sergeykhbr/riscv_vhdl/rocket_soc/docs/style/header.tex

% Latex header for doxygen 1.8.10
\documentclass[oneside]{book}

% Packages required by doxygen
\usepackage{fixltx2e}
\usepackage{calc}
\usepackage{doxygen}
\usepackage[export]{adjustbox} % also loads graphicx
\usepackage{graphicx}
\usepackage[utf8]{inputenc}
\usepackage{makeidx}
\usepackage{multicol}
\usepackage{multirow}
\PassOptionsToPackage{warn}{textcomp}
\usepackage{textcomp}
\usepackage[nointegrals]{wasysym}
\usepackage[table]{xcolor}

% Font selection
\usepackage[T1]{fontenc}
\usepackage[scaled=.90]{helvet}
\usepackage{courier}
\usepackage{amssymb}
\usepackage{sectsty}
\renewcommand{\familydefault}{\sfdefault}
\allsectionsfont{%
  \fontseries{bc}\selectfont%
  \color{darkgray}%
}
\renewcommand{\DoxyLabelFont}{%
  \fontseries{bc}\selectfont%
  \color{darkgray}%
}
\newcommand{\+}{\discretionary{\mbox{\scriptsize$\hookleftarrow$}}{}{}}

% Page & text layout
\usepackage{geometry}
\geometry{%
  a4paper,%
  top=2.5cm,%
  bottom=2.5cm,%
  left=2.5cm,%
  right=2.5cm%
}
\tolerance=750
\hfuzz=15pt
\hbadness=750
\setlength{\emergencystretch}{15pt}
\setlength{\parindent}{0cm}
\setlength{\parskip}{0.2cm}
\makeatletter
\renewcommand{\paragraph}{%
  \@startsection{paragraph}{4}{0ex}{-1.0ex}{1.0ex}{%
    \normalfont\normalsize\bfseries\SS@parafont%
  }%
}
\renewcommand{\subparagraph}{%
  \@startsection{subparagraph}{5}{0ex}{-1.0ex}{1.0ex}{%
    \normalfont\normalsize\bfseries\SS@subparafont%
  }%
}
\makeatother

% Headers & footers
\usepackage{fancyhdr}
\pagestyle{fancyplain}
\fancyhead[LE]{\fancyplain{}{\bfseries\thepage}}
\fancyhead[CE]{\fancyplain{}{}}
\fancyhead[RE]{\fancyplain{}{\bfseries\leftmark}}
\fancyhead[LO]{\fancyplain{}{\bfseries\rightmark}}
\fancyhead[CO]{\fancyplain{}{}}
\fancyhead[RO]{\fancyplain{}{\bfseries\thepage}}
\fancyfoot[LE]{\fancyplain{}{}}
\fancyfoot[CE]{\fancyplain{}{}}
\fancyfoot[RE]{\fancyplain{}{\bfseries\scriptsize Generated on Mar 9, 2017 }}
\fancyfoot[LO]{\fancyplain{}{\bfseries\scriptsize Generated on Mar 9, 2017 }}
\fancyfoot[CO]{\fancyplain{}{}}
\fancyfoot[RO]{\fancyplain{}{}}
\renewcommand{\footrulewidth}{0.4pt}
\renewcommand{\chaptermark}[1]{%
  \markboth{#1}{}%
}
\renewcommand{\sectionmark}[1]{%
  \markright{\thesection\ #1}%
}

% Indices & bibliography
\usepackage{natbib}
\usepackage[titles]{tocloft}
\setcounter{tocdepth}{3}
\setcounter{secnumdepth}{5}
\makeindex

% Hyperlinks (required, but should be loaded last)
\usepackage{ifpdf}
\ifpdf
  \usepackage[pdftex,pagebackref=true]{hyperref}
\else
  \usepackage[ps2pdf,pagebackref=true]{hyperref}
\fi
\hypersetup{%
  colorlinks=true,%
  linkcolor=blue,%
  citecolor=blue,%
  unicode%
}

% Custom commands
\newcommand{\clearemptydoublepage}{%
  \newpage{\pagestyle{empty}\cleardoublepage}%
}

%===== C O N T E N T S =====

\begin{document}

% Titlepage & ToC
\hypersetup{pageanchor=false,
             bookmarks=true,
             bookmarksnumbered=true,
             pdfencoding=unicode
            }
\pagenumbering{roman}
\begin{titlepage}
\vspace*{7cm}
\begin{center}%
{\Large RISC-V System-on-Chip description}\\
\vspace*{3cm}
{\large Autor: Khabarov Sergey 5.1.2}\\
\vspace*{0.5cm}
{\large MIPT}\\
\vspace*{0.5cm}
{\small Mar 09, 2017}\\
\end{center}
\end{titlepage}
\clearemptydoublepage
\tableofcontents
\clearemptydoublepage
\pagenumbering{arabic}
\hypersetup{pageanchor=true}

%--- Begin generated contents ---
