sergeykhbr/riscv_vhdl/docs/doxygen/config/style/header.tex

% Latex header for doxygen 1.8.16
\let\mypdfximage\pdfximage\def\pdfximage{\immediate\mypdfximage}\documentclass[oneside]{book}

%% moved from doxygen.sty due to workaround for LaTex 2019 version and unmaintained tabu package
\usepackage{ifthen}
\ifx\requestedLaTeXdate\undefined
\usepackage{array}
\else
\usepackage{array}[=2016-10-06]
\fi
%%
% Packages required by doxygen
\usepackage{fixltx2e}
\usepackage{calc}
\usepackage{doxygen}
\usepackage{graphicx}
\usepackage[utf8]{inputenc}
\usepackage{makeidx}
\usepackage{multicol}
\usepackage{multirow}
\PassOptionsToPackage{warn}{textcomp}
\usepackage{textcomp}
\usepackage[nointegrals]{wasysym}
\usepackage[table]{xcolor}
\usepackage{ifpdf,ifxetex}

% Font selection
\usepackage[T1]{fontenc}
\usepackage[scaled=.90]{helvet}
\usepackage{courier}
\usepackage{amssymb}
\usepackage{sectsty}
\renewcommand{\familydefault}{\sfdefault}
\allsectionsfont{%
  \fontseries{bc}\selectfont%
  \color{darkgray}%
}
\renewcommand{\DoxyLabelFont}{%
  \fontseries{bc}\selectfont%
  \color{darkgray}%
}
\newcommand{\+}{\discretionary{\mbox{\scriptsize$\hookleftarrow$}}{}{}}

% Arguments of doxygenemoji:
% 1) ':<text>:' form of the emoji, already "LaTeX"-escaped
% 2) file with the name of the emoji without the .png extension
% in case image exist use this otherwise use the ':<text>:' form
\newcommand{\doxygenemoji}[2]{%
  \IfFileExists{./#2.png}{\raisebox{-0.1em}{}}{#1}%
}
% Page & text layout
\usepackage{geometry}
\geometry{%
  a4paper,%
  top=2.5cm,%
  bottom=2.5cm,%
  left=2.5cm,%
  right=2.5cm%
}
\tolerance=650
\hfuzz=15pt
\hbadness=650
\textheight=650pt% default 674 see https://www.sharelatex.com/learn/Page_size_and_margins
\setlength{\emergencystretch}{15pt}
\setlength{\parindent}{0cm}
\newcommand{\doxynormalparskip}{\setlength{\parskip}{3ex plus 2ex minus 2ex}}
\newcommand{\doxytocparskip}{\setlength{\parskip}{1ex plus 0ex minus 0ex}}
\doxynormalparskip
\makeatletter
\renewcommand{\paragraph}{%
  \@startsection{paragraph}{4}{0ex}{-1.0ex}{1.0ex}{%
    \normalfont\normalsize\bfseries\SS@parafont%
  }%
}
\renewcommand{\subparagraph}{%
  \@startsection{subparagraph}{5}{0ex}{-1.0ex}{1.0ex}{%
    \normalfont\normalsize\bfseries\SS@subparafont%
  }%
}
\makeatother

% Headers & footers
\usepackage{fancyhdr}
\pagestyle{fancyplain}
% E O = Even Odd pages: L C R = Left, Center, Right page
\setlength\headheight{50pt}% top colontitle height
\fancyhead[RE,RO]{\fancyplain{}{\bfseries\thepage}}
\fancyhead[CE,CO]{\fancyplain{}{\bfseries\rightmark}}
\fancyhead[LE,LO]{}

\fancyfoot[LE,RO]{\fancyplain{}{}}
\fancyfoot[CE,CO]{\fancyplain{}{}}
\fancyfoot[RE,LO]{\fancyplain{}{\bfseries\scriptsize Generated on \\\today }}

\renewcommand{\footrulewidth}{0.4pt}
\renewcommand{\chaptermark}[1]{%
  \markboth{#1}{}%
}
\renewcommand{\sectionmark}[1]{%
  \markright{\thesection\ #1}%
}

% Indices & bibliography
\usepackage{natbib}
\usepackage[titles]{tocloft}
\setcounter{tocdepth}{3}
\setcounter{secnumdepth}{5}
\makeindex

\usepackage{newunicodechar}
  \newunicodechar{⁻}{${}^{-}$}% Superscript minus
  \newunicodechar{²}{${}^{2}$}% Superscript two
  \newunicodechar{³}{${}^{3}$}% Superscript three

% Hyperlinks (required, but should be loaded last)
\ifpdf
  \usepackage[pdftex,pagebackref=true]{hyperref}
\else
  \ifxetex
    \usepackage[pagebackref=true]{hyperref}
  \else
    \usepackage[ps2pdf,pagebackref=true]{hyperref}
  \fi
\fi

\hypersetup{%
  colorlinks=true,%
  linkcolor=blue,%
  citecolor=blue,%
  unicode%
}

% Custom commands
\newcommand{\clearemptydoublepage}{%
  \newpage{\pagestyle{empty}\cleardoublepage}%
}

\usepackage{caption}
\captionsetup{labelsep=space,justification=centering,font={bf},singlelinecheck=off,skip=4pt,position=top}

\usepackage{etoc}
\etocsettocstyle{\doxytocparskip}{\doxynormalparskip}
\renewcommand{\numberline}[1]{#1~}
%===== C O N T E N T S =====

\newcounter{tblid}[chapter]
\newenvironment{tblid}[1][]{\refstepcounter{tblid}\par\medskip
   \textbf{Table~\thechapter#1-\thetblid#1. \medskip}}{\medskip}

\newcounter{figid}[chapter]
\newenvironment{figid}[1][]{\refstepcounter{figid}\par\medskip
   \textbf{Figure~\thechapter#1-\thefigid#1. \medskip}}{\medskip}

\begin{document}

% Titlepage & ToC
\hypersetup{pageanchor=false,
             bookmarksnumbered=true,
             pdfencoding=unicode
            }
\pagenumbering{alph}
\begin{titlepage}
\vspace*{7cm}
\begin{center}%
{\Large Synthesizable System-on-Chip}\\
\vspace*{1\baselineskip}
{\Large with 64-bits RISC-V processor core}\\
\vspace*{2\baselineskip}
{\Large Technical Reference Manual}\\
\end{center}
\begin{flushright}%
\vspace*{3cm}
{\scshape Generated:    \today}\\
{\scshape Author: Sergey Khabarov}
\end{flushright}

\begin{center}%
\vspace*{3cm}
\begin{tabular}{ | m{2cm} | m{3cm} | m{3cm} | m{2cm} | m{2cm} | }
\hline
  & Name & Position & Signature &  Date \\
\hline
Prepared by & Sergey Khabarov & Technical Lead &  & \\
\hline
Reviewed by & Denis Nefedov &  &  & \\
\hline
Approved by &  &  &  & \\
\hline
Approved by &  &  &  & \\
\hline
\end{tabular}
\end{center}
\end{titlepage}
\clearemptydoublepage
\pagenumbering{roman}
\tableofcontents
\clearemptydoublepage
\pagenumbering{arabic}
\hypersetup{pageanchor=true}

%--- Begin generated contents ---
