sergeykhbr/riscv_vhdl/docs/doxygen/pics/dbg_dsu.png

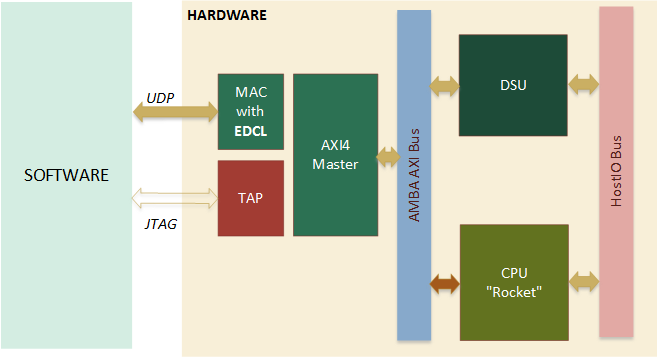
docs/doxygen/pics/dbg_dsu.png
