sergeykhbr/riscv_vhdl/docs/doxygen/pics/dbg_err1.png

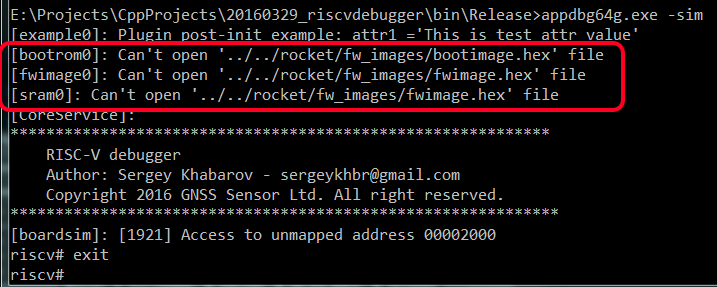
docs/doxygen/pics/dbg_err1.png
