sergeykhbr/riscv_vhdl/docs/doxygen/pics/dbg_fpga_gui1.png

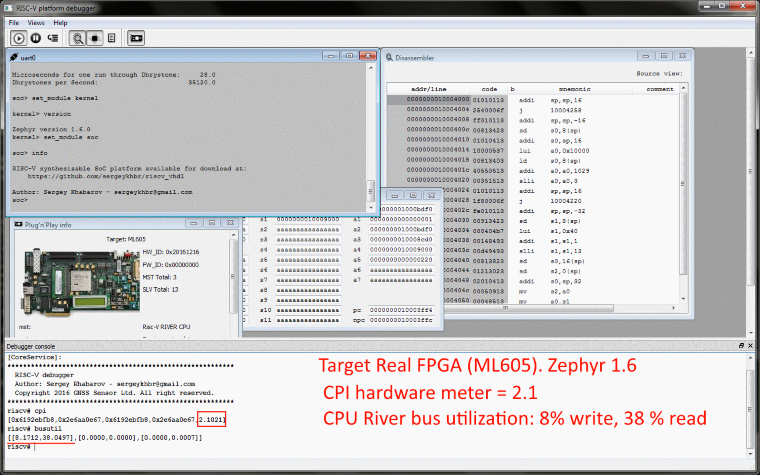
docs/doxygen/pics/dbg_fpga_gui1.png
