sergeykhbr/riscv_vhdl/docs/doxygen/pics/dbg_gnss.png

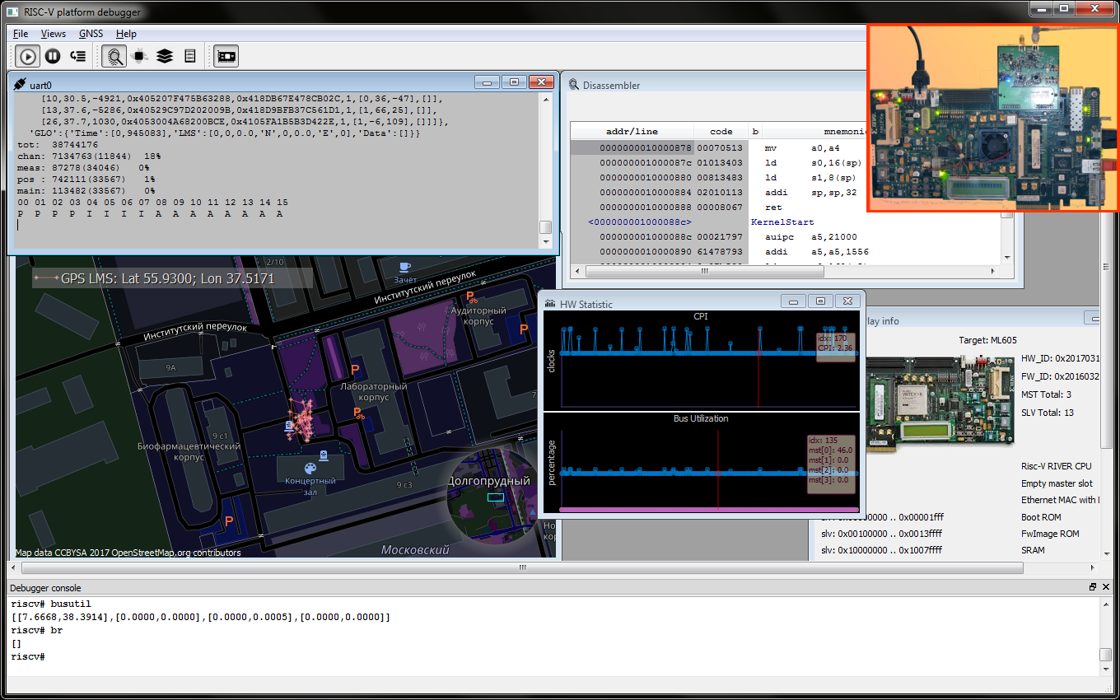
docs/doxygen/pics/dbg_gnss.png
