sergeykhbr/riscv_vhdl/docs/doxygen/pics/dbg_gui_start.png

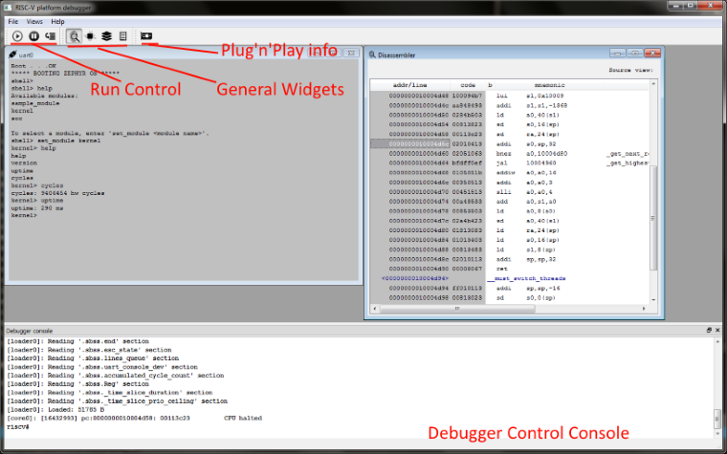
docs/doxygen/pics/dbg_gui_start.png
