sergeykhbr/riscv_vhdl/docs/doxygen/pics/dbg_gui_symb.png

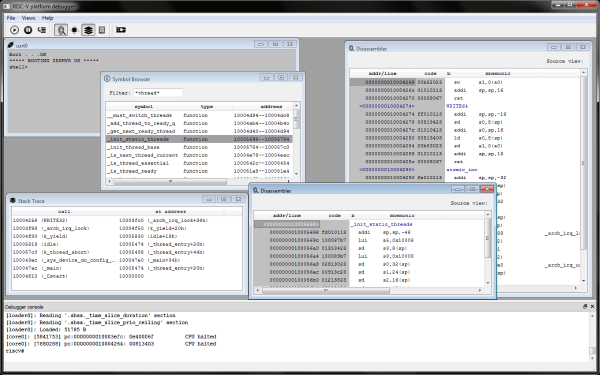
docs/doxygen/pics/dbg_gui_symb.png
