sergeykhbr/riscv_vhdl/docs/doxygen/pics/dbg_sim.png

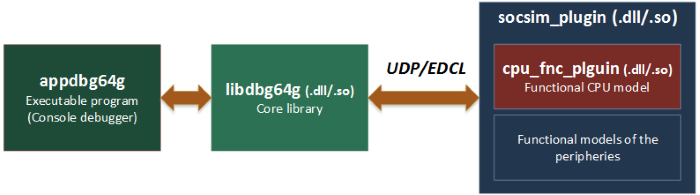
docs/doxygen/pics/dbg_sim.png
