sergeykhbr/riscv_vhdl/docs/doxygen/pics/dbg_simout1.png

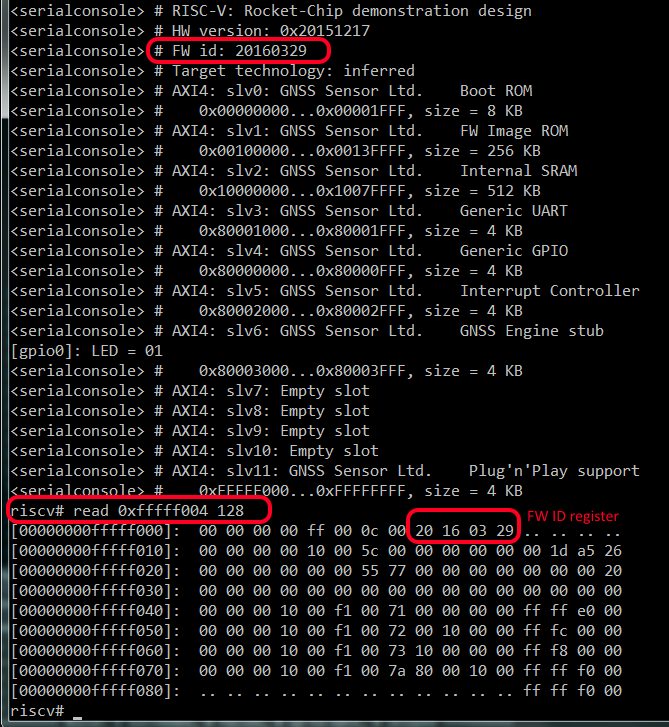
docs/doxygen/pics/dbg_simout1.png
