sergeykhbr/riscv_vhdl/docs/doxygen/pics/eth_check1.png

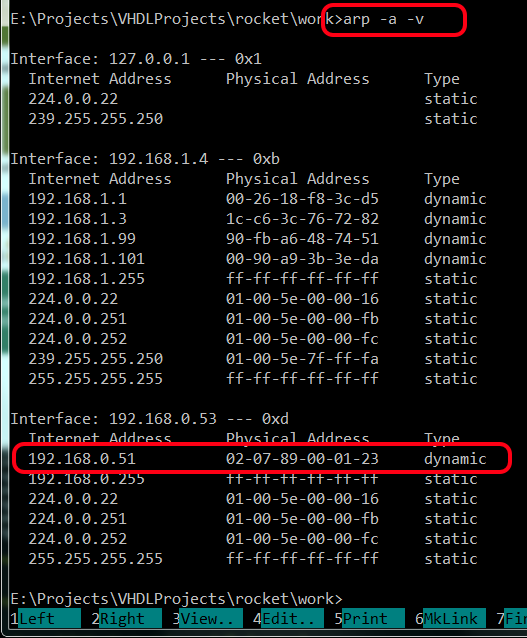
docs/doxygen/pics/eth_check1.png
