sergeykhbr/riscv_vhdl/docs/doxygen/pics/eth_common.png

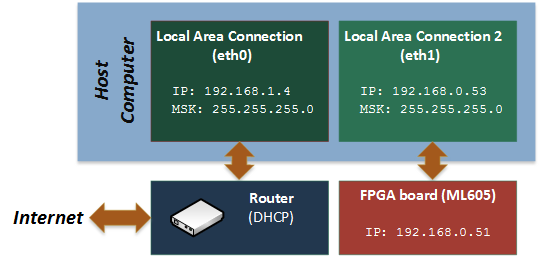
docs/doxygen/pics/eth_common.png
