sergeykhbr/riscv_vhdl/docs/doxygen/pics/eth_win1.png

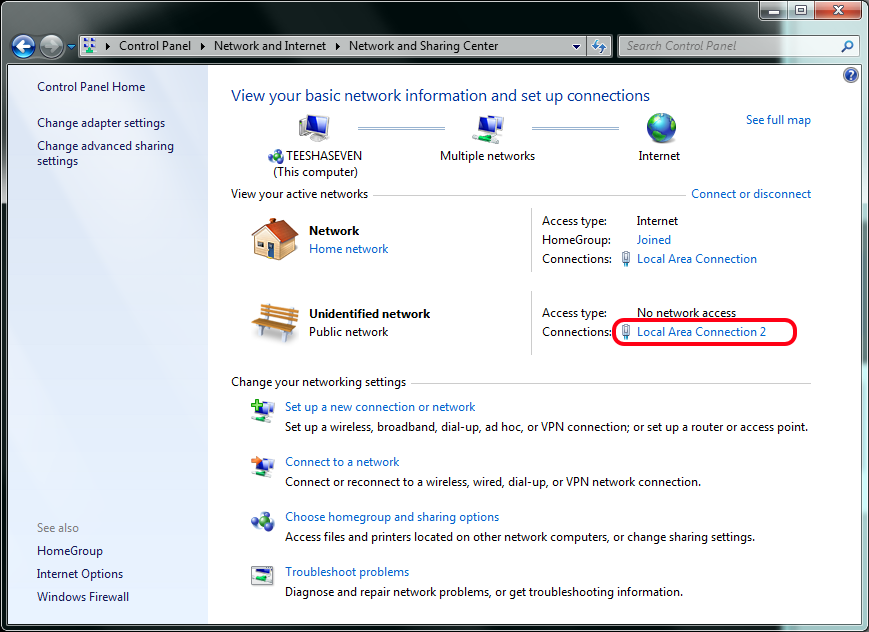
docs/doxygen/pics/eth_win1.png
