sergeykhbr/riscv_vhdl/docs/doxygen/pics/eth_win2.png

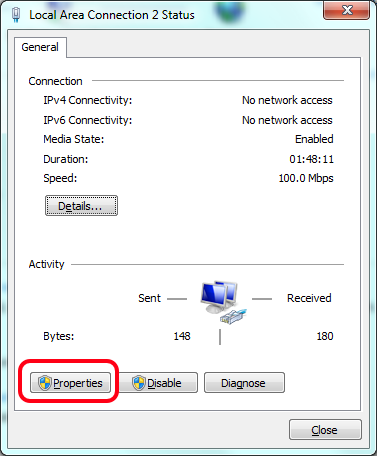
docs/doxygen/pics/eth_win2.png
