sergeykhbr/riscv_vhdl/docs/doxygen/pics/eth_win3.png

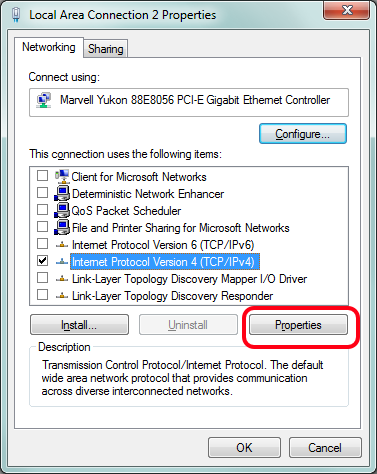
docs/doxygen/pics/eth_win3.png
