sergeykhbr/riscv_vhdl/docs/doxygen/pics/eth_win4.png

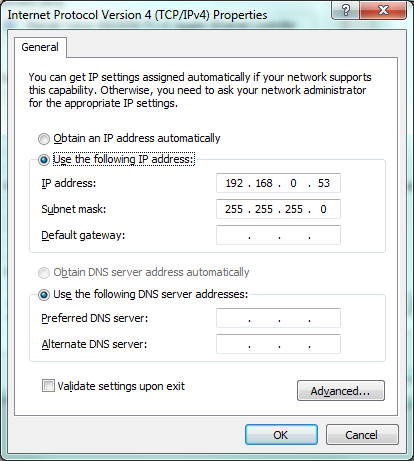
docs/doxygen/pics/eth_win4.png
