sergeykhbr/riscv_vhdl/docs/doxygen/pics/gptimer_pwm.png

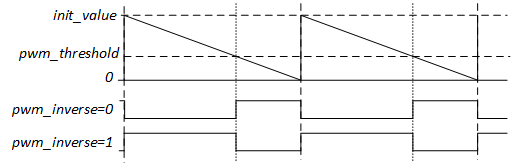
docs/doxygen/pics/gptimer_pwm.png
