sergeykhbr/riscv_vhdl/docs/doxygen/pics/soc_sim.png

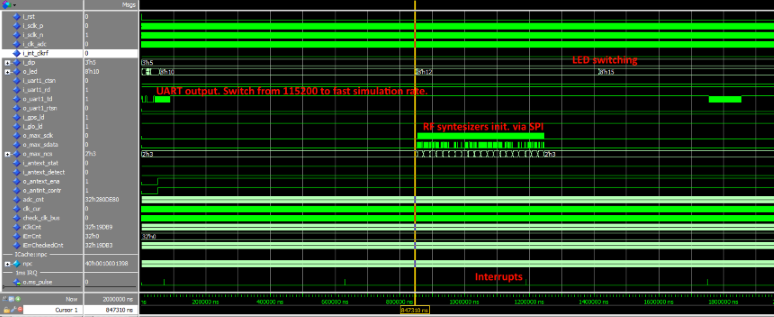
docs/doxygen/pics/soc_sim.png
