sergeykhbr/riscv_vhdl/docs/doxygen/pics/soc_top_v4.png

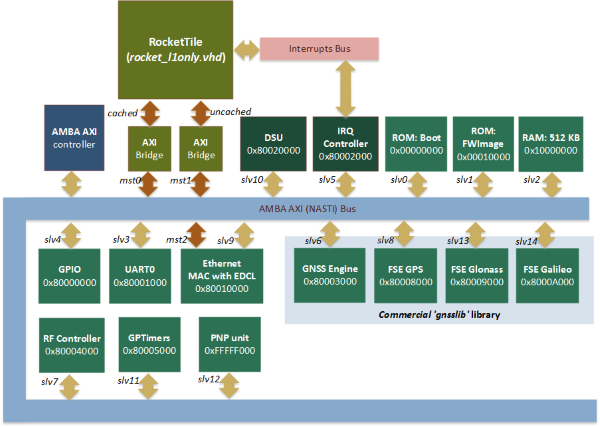
docs/doxygen/pics/soc_top_v4.png
