sergeykhbr/riscv_vhdl/docs/doxygen/pics/spi_rd_data.png

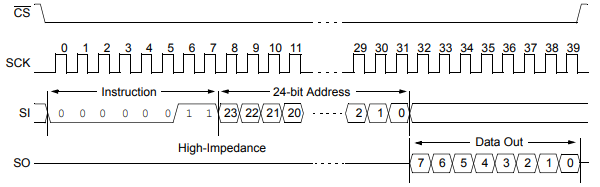
docs/doxygen/pics/spi_rd_data.png
