sergeykhbr/riscv_vhdl/docs/doxygen/pics/spi_rd_status.png

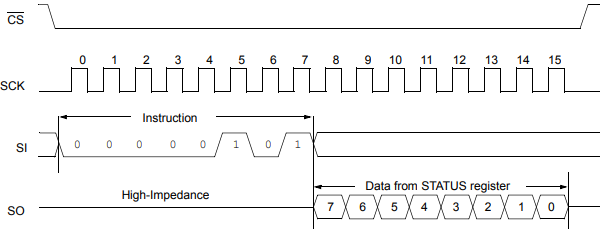
docs/doxygen/pics/spi_rd_status.png
