sergeykhbr/riscv_vhdl/docs/doxygen/pics/spi_wr_enable.png

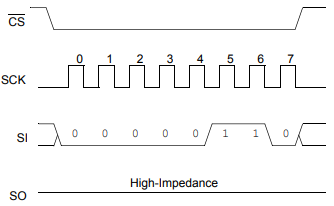
docs/doxygen/pics/spi_wr_enable.png
