sergeykhbr/riscv_vhdl/docs/doxygen/pics/spi_wr_page.png

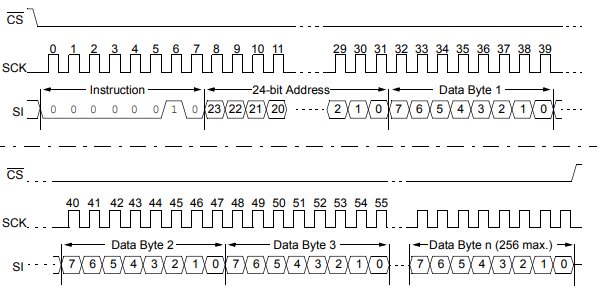
docs/doxygen/pics/spi_wr_page.png
