sergeykhbr/riscv_vhdl/docs/doxygen/pics/spi_wr_status.png

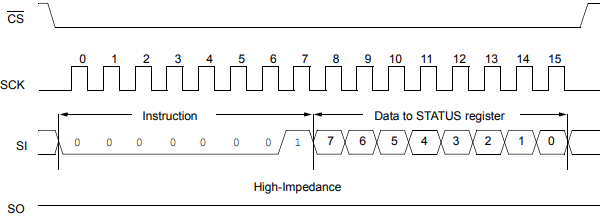
docs/doxygen/pics/spi_wr_status.png
