sergeykhbr/riscv_vhdl/docs/doxygen/pics/uartdbg1.png

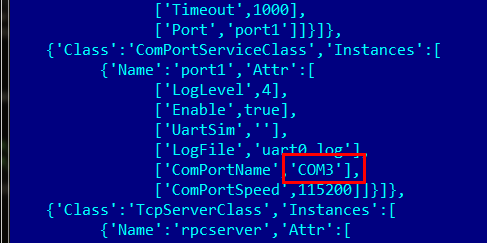
docs/doxygen/pics/uartdbg1.png
