sergeykhbr/riscv_vhdl/docs/doxygen/pics/uartdbg2.png

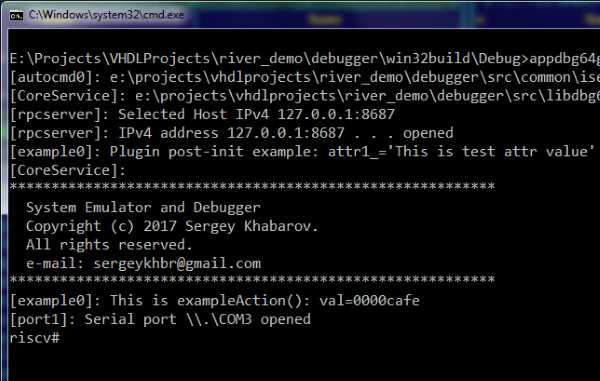
docs/doxygen/pics/uartdbg2.png
