sergeykhbr/riscv_vhdl/docs/doxygen/pics/uartdbg3.png

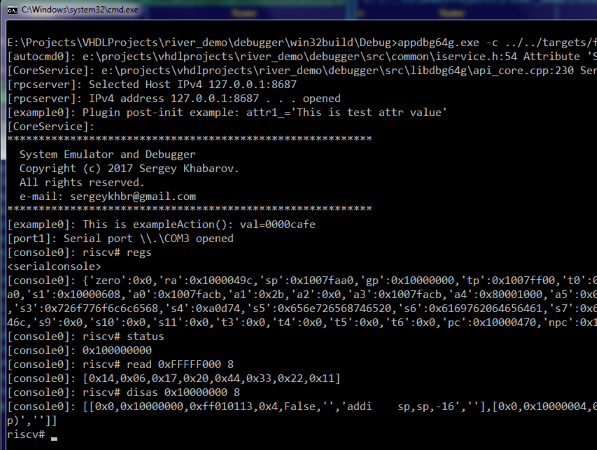
docs/doxygen/pics/uartdbg3.png
