sergeykhbr/riscv_vhdl/docs/doxygen/pics/uartdbg4.png

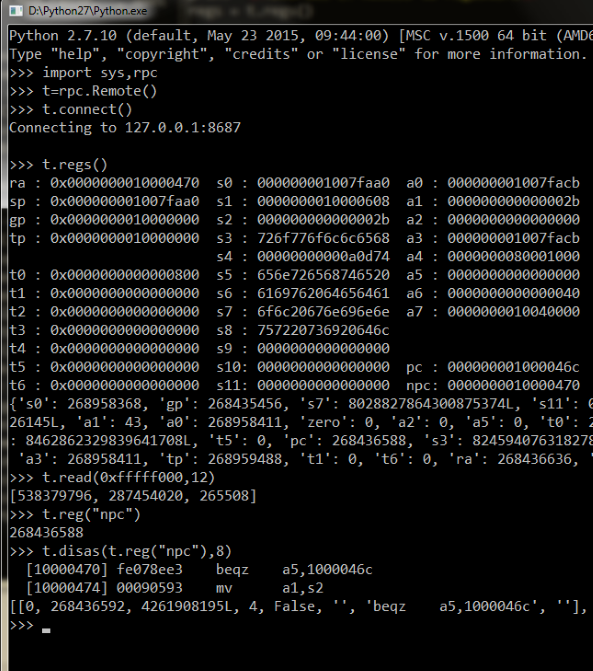
docs/doxygen/pics/uartdbg4.png
