sergeykhbr/riscv_vhdl/docs/doxygen/pics/mem_byte_order.png

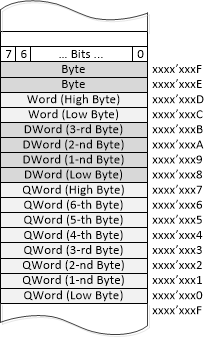
docs/doxygen/pics/mem_byte_order.png
