sergeykhbr/riscv_vhdl/docs/doxygen/pics/dbg_testhw.png

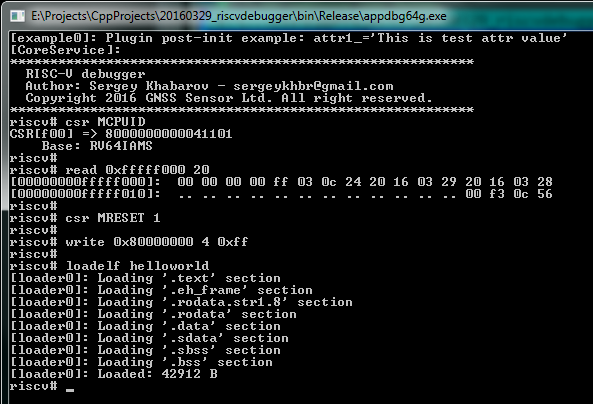
docs/doxygen/pics/dbg_testhw.png
