sergeykhbr/riscv_vhdl/debugger/scripts/demo/footer.tex

% Latex footer for doxygen 1.8.10
%--- End generated contents ---

% Index
\backmatter
\newpage
\phantomsection
\clearemptydoublepage
\addcontentsline{toc}{chapter}{Index}
\printindex

\end{document}
