sergeykhbr/riscv_vhdl/debugger/src/gui_plugin/resources/images/kc705_top.png

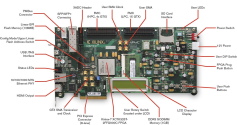
debugger/src/gui_plugin/resources/images/kc705_top.png
