sergeykhbr/riscv_vhdl/debugger/src/gui_plugin/resources/images/ml605_top.png

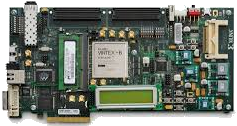
debugger/src/gui_plugin/resources/images/ml605_top.png
