sergeykhbr/riscv_vhdl/(threads)

Thread 1 (2016-02-23):

Bare-metal Rocket Chip

pbn4, 2016-02-23:
Hello,

I was wondering if it is possible to run bare-metal applications with rocketchip? I wanted to simply flash a program written in C without using bootloader and flashing linux image to ROM.  If it is not possible please point me to some details (docs, readings etc.) about it.

sergeykhbr, 2016-02-23:
Hi,
It is possible and that's we're doing with our firmware for Satellite Navigation receiver.

In our case it is a bit simpler to support hardware features because we're writing our FW from the scratch. In a case of linux there're some modifications in kernel will require to support internal timers and interrupts and most probably modes of processors (up to 4 privilege levels: machine ->..-> user). Linux port from the original riscv.org site should simplify this work, I think.
The second problem - available memory size to run linux. It can be easily solved on fpga platforms using appropriate ddr phy with AMBA axi controller but it out of my project for now (maybe later).

You need some initial bootup code in any case to reset registers, invalidate caches and initialize stack pointer. After that you can copy your linux image into SRAM or jump to some entry point at once. That's we are actually doing with our firmware before we call main() function placed exactly at 0x10000000 address. See example of our our boot loader in 'fw' folder.

Closed 2016-02-23.

Thread 4 (2017-02-07):

The software models with GUI closes automatically

satya123bora, 2017-02-07:
If I run ./_run_functional_sim.sh or ./_run_systemc_sim.sh, it works fine for 2-3 mins. But, after 2-3 mins, the window closes automatically. The terminal messages are:

[example0]: Plugin post-init example: attr1_='This is test attr value'
[CoreService]:                                                
**********************************************************
  RISC-V debugger
  Author: Sergey Khabarov - sergeykhbr@gmail.com
  Copyright 2016 GNSS Sensor Ltd. All right reserved.
**********************************************************
[example0]: This is exampleAction(): val=0000cafe             
<led[7:0]> 01h                                                
<led[7:0]> 02h                                                
<led[7:0]> 03h                                                
<led[7:0]> 04h                                                
<serialconsole> Boot . . .OK                                  
<serialconsole> ***** BOOTING ZEPHYR OS *****                 
riscv# *** Error in `./appdbg64g.exe': double free or corruption (out): 0x00007f4d8805f1d0 ***
./_run_functional_sim.sh: line 3:  7880 Aborted                 (core dumped) ./appdbg64g.exe -c ../../targets/functional_sim_gui.json "$@"

when the window closes, the terminal also stops working. If I try to run it from a different terminal, it appears for 3-4 secs and then closes. But, If I wait for 15-20 mins and then run it, it again works for 2-3 mins. Why is this happening? I am working on ubuntu 14.04.

sergeykhbr, 2017-02-07:
Thank you for this issue report. I can reproduce it and will try to fix as fast as possible.

sergeykhbr, 2017-02-07:
Bug was fixed. see attribute.cpp, line 216. Allocated memory wasn't initialized (Linux problem only).

Closed 2017-02-08.

Thread 5 (2017-06-22):

Rtos port on RISC-V

ninode, 2017-06-22:
Hello,

I'm doing an rtos port on RISC-V and currently working on the fpga-zynq/rocket-chip directory of Berkeley's.

Could you please provide instruction to how you used Vivado tools to generate another boot.bin which contains another os than linux with the rocket chip ? Did you use [this directory ](https://github.com/ucb-bar/fpga-zynq) at all ?
What kind of files are necessary to have both the rocket cores and another os into the same boot.bin ?

Thank you very much

Regards

sergeykhbr, 2017-06-23:
Hi,

I think you've a bit misunderstood the difference of projects for ZYNQ (ARM+FPGA) and pure FPGA projects. I do not use ZYNQ in my project and I do not use directory you've pointed to. So, I cannot help you to generate boot.bin file because I don't need to generate image for ARM at all.

Regards,
Sergey

ninode, 2017-07-03:
Hello,

Actually, is it possible to use your SoC FPGA Rocket sources and push them to a Zedboard to have Rocket cores on the FPGA fabric and not touch the ARM ?

Also, instead of Zephyr, is it possible to use my own sources for a ported RTOS in order to have: RTOS on ARM cores and Rocket cores on FPGA, without the boot.bin, but following your steps ?

Thank you

sergeykhbr, 2017-07-03:
I am not experienced with ZYNQ but I see one common difference in FPGA startup process:

- In a case of pure FPGA project (not ZYNQ), FPGA has access to all HW interfaces and IOs including flash ROM. Software (ISE or Vivado) can directly load bit-image into fpga via JTAG interface either.

- In a case of ZYNQ almost all FPGA's IOs connected to MIO interface between ARM and FPGA. And accordingly with this thread
https://forums.xilinx.com/t5/Zynq-All-Programmable-SoC/Zynq-newbee-questions-Configure-FPGA-fabric-without-hard-ARM/td-p/568025
"**_The Zynq PL cannot be configured independent of the PS; the PL can't power on and read a configuration bitstream from a memory chip. The PS must run and program the fabric through a configuration access port...._**"
In my opinion, it means that you has to build and run at least BootLoader on ARM to properly configure MIO interface and load FPGA image into FPGA.

So, I suppose the answers on questions will be (my opinion only):
1. It is possible to use Rocket sources on FPGA but ARM is always touched.
2. You cannot load FPGA without boot.bin

Closed 2017-06-23.

Thread 6 (2017-08-17):

compiling errors

Pengnian, 2017-08-17:
Hi ,all

I want to compiling boot (riscv_vhdl\rocket_soc\fw\boot),but find some errors maybe causing  gun-toolchain version , please experts  explanation ! Thanks~

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

sergeykhbr, 2017-08-17:
Hi,
You're building _bootimg_ with the flag **-march=rv64ima**, but gcc toolchain was built with the hardware FPU (default configuration).

I suggest to rebuild gcc with _**--disable-float**_ key or build _bootimg_ with the _-march=rv64imafd_.

Pengnian, 2017-08-17:
Okay. Thanks very much，I will  try again！☺️ You explanation  very useful for  me！

Sent from Mail Master
On 08/17/2017 17:57, Sergey wrote:

Hi,
You're building bootimg with the flag -march=rv64ima, but gcc toolchain was built with the hardware FPU (default configuration).

I suggest to rebuild gcc with --disable-float key or build bootimg with the -march=rv64imafd.

—
You are receiving this because you authored the thread.
Reply to this email directly, view it on GitHub, or mute the thread.

Closed 2017-08-17.

Thread 9 (2017-10-11):

how  to generate bitstream file  by myself ?

Pengnian, 2017-10-11:
Hi Sergey,

At first，thanks for your source code about risc-v cores.

I know I can directly use your  project at ISE or Vivado(riscv_vhdl/rocket_soc/prj/) but I want to synthesis in vivado by myself at xilinx  VCU118 Board. Can  you  tell me which vhdl files  need to add my project and other attention items?

Thanks you very much !

sergeykhbr, 2017-10-11:
Hi,
I'm doing the following steps to add new fpga/asic target:

1. Create new target ID in the file _techmap/gencomp/gecomp.vhd_ (or reuse '_virtex7_' for your purpose).
2. Generate new PLL module for your target and add it to the file _techmap/pll/SysPLL_tech.vhd_ under your generic parameter. Don't forget to include your pll module into '_techmap_' library (default is '_work_').
3. Do the same step for others '_*_tech.vhd_' files (if needed), like _techmap/mem/bootrom_tech.vhd_ or check that function __is_fpga__('virtex7') returns 1.
4. Create the constrains file for your fpga
5. Create the target config file (analog is _prj/ml605/config_v6.vhd_) and include it into the project instead of other config target. It should define parameters:
           CFG_FABTECH = virtex7
           CFG_MEMTECH = virtex7
           ..
6. Build project and try to find the words '_blackbox_' or '_black_' in your synthesis output. If not found then OK and everything should be built successfully, otherwise check that you properly included target dependable modules.

Pengnian, 2017-10-12:
@sergeykhbr Hi sergey，
Thanks  for your reply ,I want to ask one question that adding helloworld  hex file to vhdl file synthesis together which attention items we need focus on and why print "hello world !" message  by uart port is messy code.

please give me  some hint,thanks again!

sergeykhbr, 2017-10-12:
There're used two images:

1. bootimage.hex. This file is generated by fw/boot code. It is valid for ASIC, FPGA and RTL simulation. But there's implemented a special trick (reading 'tech' register from pnp module) for the RTL simulation that allows to skip stage of copying fwimage data from ROM to RAM before executing it.

2. fwimage.hex. It's the image with the firmware (HelloWorld or whatever). In normal mode it should be stored only as a ROM module but to speed simulation SRAM module also is using it for the initialization. This approach normally works on simulation and even for FPGA but invalid for ASIC because SRAM cannot be initialized.

If you have some messy UART output most probably you wrongly setup UART Baud rate. Baud Rate directly depends of Bus clock frequency and UART scaler register must be computed as:

        uart->scaler = Fbus / 115200 / 2
        where Fbus = 40 000 000 Hz
Probably you are using another Bus Frequency.

Pengnian, 2017-10-13:
@sergeykhbr Thanks very much,
It is very important for us !

Pengnian, 2017-10-13:
@sergeykhbr Hi sergey,
Thanks for you patient, I'm very appreciate it !

Pengnian, 2017-10-21:
@sergeykhbr Hi sergey，
 I'm sorry , I can't generate bitstream file for my target board (Virtex UltraScala+ VCU118) following your hints. Can you tell me every steps transplant RISC-V core to my board or create new project in vivado(or ISE)  for my board. My board XDC file   following:

`
##############################################################################
 Generated by PlanAhead 14.7 built on 'Fri Sep 27 19:29:51 MDT 2013' by 'xbuild'
##############################################################################

create_clock -period 5.000 -name i_sclk_p [get_ports i_sclk_p]
set_property IOSTANDARD LVDS [get_ports i_sclk_p]
set_property PACKAGE_PIN G31 [get_ports i_sclk_p]
set_property PACKAGE_PIN F31 [get_ports i_sclk_n]
set_property IOSTANDARD LVDS [get_ports i_sclk_n]

# button "Center"
set_property PACKAGE_PIN L19 [get_ports i_rst]
set_property CLOCK_DEDICATED_ROUTE FALSE [get_nets i_rst]
set_property IOSTANDARD LVCMOS12 [get_ports i_rst]

# DIP switch: SW1.1
set_property PACKAGE_PIN B17 [get_ports {i_dip[0]}]
set_property IOSTANDARD LVCMOS12 [get_ports {i_dip[0]}]
set_property PACKAGE_PIN G16 [get_ports {i_dip[1]}]
set_property IOSTANDARD LVCMOS12 [get_ports {i_dip[1]}]
set_property PACKAGE_PIN J16 [get_ports {i_dip[2]}]
set_property IOSTANDARD LVCMOS12 [get_ports {i_dip[2]}]
set_property PACKAGE_PIN D21 [get_ports {i_dip[3]}]
set_property IOSTANDARD LVCMOS12 [get_ports {i_dip[3]}]

#UART interface
set_property PACKAGE_PIN AY25 [get_ports i_uart1_ctsn]
set_property IOSTANDARD LVCMOS18 [get_ports i_uart1_ctsn]
set_property PACKAGE_PIN AW25 [get_ports i_uart1_rd]
set_property IOSTANDARD LVCMOS18 [get_ports i_uart1_rd]
set_property PACKAGE_PIN BB22 [get_ports o_uart1_rtsn]
set_property IOSTANDARD LVCMOS18 [get_ports o_uart1_rtsn]
set_property PACKAGE_PIN BB21 [get_ports o_uart1_td]
set_property IOSTANDARD LVCMOS18 [get_ports o_uart1_td]

#/ User's LEDs:
set_property PACKAGE_PIN AT32 [get_ports {o_led[0]}]
set_property IOSTANDARD LVCMOS12 [get_ports {o_led[0]}]
set_property PACKAGE_PIN AV34 [get_ports {o_led[1]}]
set_property IOSTANDARD LVCMOS12 [get_ports {o_led[1]}]
set_property PACKAGE_PIN AY30 [get_ports {o_led[2]}]
set_property IOSTANDARD LVCMOS12 [get_ports {o_led[2]}]
set_property PACKAGE_PIN BB32 [get_ports {o_led[3]}]
set_property IOSTANDARD LVCMOS12 [get_ports {o_led[3]}]
set_property PACKAGE_PIN BF32 [get_ports {o_led[4]}]
set_property IOSTANDARD LVCMOS12 [get_ports {o_led[4]}]
set_property PACKAGE_PIN AU37 [get_ports {o_led[5]}]
set_property IOSTANDARD LVCMOS12 [get_ports {o_led[5]}]
set_property PACKAGE_PIN AV36 [get_ports {o_led[6]}]
set_property IOSTANDARD LVCMOS12 [get_ports {o_led[6]}]
set_property PACKAGE_PIN BA37 [get_ports {o_led[7]}]
set_property IOSTANDARD LVCMOS12 [get_ports {o_led[7]}]

# Ethernet signals
set_property PACKAGE_PIN AT22 [get_ports i_gmiiclk_p]
set_property IOSTANDARD LVCMOS18 [get_ports i_gmiiclk_p]
set_property PACKAGE_PIN AU22 [get_ports i_gmiiclk_n]
set_property IOSTANDARD LVCMOS18 [get_ports i_gmiiclk_n]

set_property CLOCK_DEDICATED_ROUTE FALSE [get_nets -of [get_pins igbebuf0/xk7.x1/x1/O]]

set_property PACKAGE_PIN AH30 [get_ports io_emdio]
set_property IOSTANDARD LVCMOS18 [get_ports io_emdio]
set_property PACKAGE_PIN AM31 [get_ports o_emdc]
set_property IOSTANDARD LVCMOS18 [get_ports o_emdc]
set_property PACKAGE_PIN K36 [get_ports i_emdint]
set_property IOSTANDARD LVCMOS18 [get_ports i_emdint]
set_property PACKAGE_PIN R36 [get_ports o_erstn]
set_property IOSTANDARD LVCMOS18 [get_ports o_erstn]
set_property PACKAGE_PIN L38 [get_ports i_erx_crs]
set_property IOSTANDARD LVCMOS18 [get_ports i_erx_crs]
set_property PACKAGE_PIN M37 [get_ports i_erx_col]
set_property IOSTANDARD LVCMOS18 [get_ports i_erx_col]
set_property PACKAGE_PIN BC10 [get_ports i_erx_clk]
set_property IOSTANDARD LVCMOS18 [get_ports i_erx_clk]
set_property PACKAGE_PIN R33 [get_ports i_erx_er]
set_property IOSTANDARD LVCMOS18 [get_ports i_erx_er]
set_property PACKAGE_PIN T33 [get_ports i_erx_dv]
set_property IOSTANDARD LVCMOS18 [get_ports i_erx_dv]
set_property PACKAGE_PIN W31 [get_ports {i_erxd[0]}]
set_property IOSTANDARD LVCMOS18 [get_ports {i_erxd[0]}]
set_property PACKAGE_PIN Y31 [get_ports {i_erxd[1]}]
set_property IOSTANDARD LVCMOS18 [get_ports {i_erxd[1]}]
set_property PACKAGE_PIN U32 [get_ports {i_erxd[2]}]
set_property IOSTANDARD LVCMOS18 [get_ports {i_erxd[2]}]
set_property PACKAGE_PIN U31 [get_ports {i_erxd[3]}]
set_property IOSTANDARD LVCMOS18 [get_ports {i_erxd[3]}]
set_property PACKAGE_PIN T31 [get_ports o_egtx_clk]
set_property IOSTANDARD LVCMOS18 [get_ports o_egtx_clk]
set_property PACKAGE_PIN BE10 [get_ports i_etx_clk]
set_property IOSTANDARD LVCMOS18 [get_ports i_etx_clk]
set_property CLOCK_DEDICATED_ROUTE FALSE [get_nets i_etx_clk_IBUF_inst/O]

set_property PACKAGE_PIN BB8 [get_ports o_etx_er]
set_property IOSTANDARD LVCMOS18 [get_ports o_etx_er]
set_property PACKAGE_PIN J14 [get_ports o_etx_en]
set_property IOSTANDARD LVCMOS18 [get_ports o_etx_en]
set_property PACKAGE_PIN N12 [get_ports {o_etxd[0]}]
set_property IOSTANDARD LVCMOS18 [get_ports {o_etxd[0]}]
set_property PACKAGE_PIN R16 [get_ports {o_etxd[1]}]
set_property IOSTANDARD LVCMOS18 [get_ports {o_etxd[1]}]
set_property PACKAGE_PIN BB11 [get_ports {o_etxd[2]}]
set_property IOSTANDARD LVCMOS18 [get_ports {o_etxd[2]}]
set_property PACKAGE_PIN BA10 [get_ports {o_etxd[3]}]
set_property IOSTANDARD LVCMOS18 [get_ports {o_etxd[3]}]

set_property MARK_DEBUG true [get_nets o_uart1_td_OBUF]
set_property MARK_DEBUG true [get_nets i_uart1_rd_IBUF]
set_property MARK_DEBUG true [get_nets i_uart1_ctsn_IBUF]

set_property MARK_DEBUG false [get_nets {uart1/data1[2]}]
set_property MARK_DEBUG false [get_nets {uart1/data1[29]}]
set_property MARK_DEBUG false [get_nets {uart1/data1[26]}]
set_property MARK_DEBUG false [get_nets {uart1/data1[23]}]
set_property MARK_DEBUG false [get_nets {uart1/data1[20]}]
set_property MARK_DEBUG false [get_nets {uart1/data1[17]}]
set_property MARK_DEBUG false [get_nets {uart1/data1[14]}]
set_property MARK_DEBUG false [get_nets {uart1/data1[11]}]
set_property MARK_DEBUG false [get_nets {uart1/data1[10]}]
set_property MARK_DEBUG false [get_nets {uart1/data1[5]}]
set_property MARK_DEBUG false [get_nets {uart1/data1[27]}]
set_property MARK_DEBUG false [get_nets {uart1/data1[24]}]
set_property MARK_DEBUG false [get_nets {uart1/data1[21]}]
set_property MARK_DEBUG false [get_nets {uart1/data1[18]}]
set_property MARK_DEBUG false [get_nets {uart1/data1[15]}]
set_property MARK_DEBUG false [get_nets {uart1/data1[12]}]
set_property MARK_DEBUG false [get_nets {uart1/data1[8]}]
set_property MARK_DEBUG false [get_nets {uart1/data1[6]}]
set_property MARK_DEBUG false [get_nets {uart1/data1[3]}]
set_property MARK_DEBUG false [get_nets {uart1/data1[30]}]
set_property MARK_DEBUG false [get_nets {uart1/data1[7]}]
set_property MARK_DEBUG false [get_nets {uart1/data1[1]}]
set_property MARK_DEBUG false [get_nets {uart1/data1[16]}]
set_property MARK_DEBUG false [get_nets {uart1/data1[4]}]
set_property MARK_DEBUG false [get_nets {uart1/data1[31]}]
set_property MARK_DEBUG false [get_nets {uart1/data1[28]}]
set_property MARK_DEBUG false [get_nets {uart1/data1[22]}]
set_property MARK_DEBUG false [get_nets {uart1/data1[25]}]
set_property MARK_DEBUG false [get_nets {uart1/data1[19]}]
set_property MARK_DEBUG false [get_nets {uart1/data1[9]}]
set_property MARK_DEBUG false [get_nets {uart1/data1[13]}]

set_property MARK_DEBUG true [get_nets {rst0/AR[0]}]
create_debug_core u_ila_0 ila
set_property ALL_PROBE_SAME_MU true [get_debug_cores u_ila_0]
set_property ALL_PROBE_SAME_MU_CNT 1 [get_debug_cores u_ila_0]
set_property C_ADV_TRIGGER false [get_debug_cores u_ila_0]
set_property C_DATA_DEPTH 65536 [get_debug_cores u_ila_0]
set_property C_EN_STRG_QUAL false [get_debug_cores u_ila_0]
set_property C_INPUT_PIPE_STAGES 0 [get_debug_cores u_ila_0]
set_property C_TRIGIN_EN false [get_debug_cores u_ila_0]
set_property C_TRIGOUT_EN false [get_debug_cores u_ila_0]
set_property port_width 1 [get_debug_ports u_ila_0/clk]
connect_debug_port u_ila_0/clk [get_nets [list pll0/xv7.pll0/w_clk_bus]]
set_property PROBE_TYPE DATA_AND_TRIGGER [get_debug_ports u_ila_0/probe0]
set_property port_width 1 [get_debug_ports u_ila_0/probe0]
connect_debug_port u_ila_0/probe0 [get_nets [list i_uart1_ctsn_IBUF]]
create_debug_port u_ila_0 probe
set_property PROBE_TYPE DATA_AND_TRIGGER [get_debug_ports u_ila_0/probe1]
set_property port_width 1 [get_debug_ports u_ila_0/probe1]
connect_debug_port u_ila_0/probe1 [get_nets [list i_uart1_rd_IBUF]]
create_debug_port u_ila_0 probe
set_property PROBE_TYPE DATA_AND_TRIGGER [get_debug_ports u_ila_0/probe2]
set_property port_width 2 [get_debug_ports u_ila_0/probe2]
connect_debug_port u_ila_0/probe2 [get_nets [list o_uart1_td_OBUF {rst0/AR[0]}]]
set_property C_CLK_INPUT_FREQ_HZ 300000000 [get_debug_cores dbg_hub]
set_property C_ENABLE_CLK_DIVIDER false [get_debug_cores dbg_hub]
set_property C_USER_SCAN_CHAIN 1 [get_debug_cores dbg_hub]
connect_debug_port dbg_hub/clk [get_nets u_ila_1_clkfbout_buf]
`

Pengnian, 2017-10-21:
@sergeykhbr Hi sergey，
I'm sorry , I can't generate bitstream file for my target board (Virtex UltraScala+ VCU118) following your hints. Can you tell me every steps transplant RISC-V core to my board or create new project in vivado(or ISE) for my board. My board XDC file following:
[riscv_soc_vcu118.txt](https://github.com/sergeykhbr/riscv_vhdl/files/1404056/riscv_soc_vcu118.txt)

sergeykhbr, 2017-11-03:
Sorry, I was on vacation.
Where did you stuck? Could you please send synthesis console logs. Because I don't have such board and can't check your constraints file.

Pengnian, 2017-11-06:
@sergeykhbr  Thank you very much,
 "ERROR: [Chipscope 16-213] The debug port 'u_ila_0/clk' has 1 unconnected channels (bits). This will cause errors during implementation."

my synthesis log as follow:

[synthesis_log.txt](https://github.com/sergeykhbr/riscv_vhdl/files/1446705/synthesis_log.txt)

my implementation log  as follow:
[implementation_log.txt](https://github.com/sergeykhbr/riscv_vhdl/files/1446708/implementation_log.txt)

Pengnian, 2017-11-07:
@sergeykhbr  Hi,sergeykhbr

Thank you for your patient!

Vivado synthesis has passed, but implementation report errors , the error is follow:

`[DRC 23-20] Rule violation (INBB-3) Black Box Instances - Cell 'boot0/tech0/genrom1.x0' of type 'boot0/tech0/genrom1.x0/BootRom_vcu118' has undefined contents and is considered a black box.  The contents of this cell must be defined for opt_design to complete successfully.
`
my vivado synthesis log:
[vivado_synthesis_log.txt](https://github.com/sergeykhbr/riscv_vhdl/files/1448573/vivado_synthesis_log.txt)

my vivado implementation log:
[vivado_implementation_log.txt](https://github.com/sergeykhbr/riscv_vhdl/files/1448574/vivado_implementation_log.txt)

Pengnian, 2017-11-07:
@sergeykhbr Thank you for your patient!

Vivado synthesis has passed, but implementation report errors , the error is follow:

`[DRC 23-20] Rule violation (INBB-3) Black Box Instances - Cell 'boot0/tech0/genrom1.x0' of type 'boot0/tech0/genrom1.x0/BootRom_vcu118' has undefined contents and is considered a black box. The contents of this cell must be defined for opt_design to complete successfully.`

my vivado synthesis log:
[vivado_synthesis_log.txt](https://github.com/sergeykhbr/riscv_vhdl/files/1448577/vivado_synthesis_log.txt)

my vivado implementation log:
[vivado_implementation_log.txt](https://github.com/sergeykhbr/riscv_vhdl/files/1448578/vivado_implementation_log.txt)

sergeykhbr, 2017-11-07:
I see at least 2 wrongly synthesized component (see synt. log-file):
```
Report BlackBoxes:
     +------+----------------+----------+
     |      |BlackBox name   |Instances |
     +------+----------------+----------+
     |1     |BootRom_vcu118  |         1|
     |2     |RomImage_vcu118 |         1|
     +------+----------------+----------+
```
So you need to properly instantiate these modules in a similar way as in *techmap\mem\bootrom_tech.vhd*
1. Check *is_fpga(memtech)* returns true
2. Check that your files included into *techmap* library
3. There's a bit another names than in my project so I can't provide more details.

Pengnian, 2017-11-08:
@sergeykhbr
Thank for your patient,

My modification steps as follow:

 1. create BootRom_vcu118.vhd for  my target.
 2.instantiation the modules in `techmap\mem\bootrom.vhd`
  ( `RomImage_vcu118.vhd` also like above )

So,besides I don't know which file  need to modification .Can you tell  all of `*.vhd` file need to modification  about `BootRom` and `RomImage`.

Pengnian, 2017-11-08:
Thanks for your patient, My modification steps as follow:

   1.create BootRom_vcu118.vhd for my target.
   2.instantiation the modules in techmap\mem\bootrom.vhd
      ( RomImage_vcu118.vhd also like above )
So,besides I don't know which file need to modification .Can you tell all of *.vhd file need to modification about BootRom and RomImage.

sergeykhbr, 2017-11-08:
If you create new ROM-module file then you need to add it into Vivado project and afterward you need to include it into 'techmap' library (default is 'work').

Now it looks like you didn't add your files into the project or didn't include them into proper library by this reason Vivado insert black-boxes.

Pengnian, 2017-11-11:
Okay,Thanks  you very much!!!

Closed 2017-11-24.

Thread 11 (2018-03-29):

elf2raw64 и .shstrab

kraziant, 2018-03-29:
Сергей, здравствуйте! Собрали elf2raw64 из исходников. При конвертации выдается ошибка:
 err: undifined .shstrab section.

Возможно мы не правильно elf собираем?
В качестве тулчейна используем SciFive пресобранный со студией.

Хотим запустить helloworld.

sergeykhbr, 2018-03-29:
Hi. Could you please attach your elf-file?

Notice: there's bug with some compressed instruction in simulator from the main trunk of the repository that I didn't solve yet.

kraziant, 2018-03-31:
Here they are:

[helloworld.hex.txt](https://github.com/sergeykhbr/riscv_vhdl/files/1865273/helloworld.hex.txt)
[_example-comp.err.txt](https://github.com/sergeykhbr/riscv_vhdl/files/1865275/_example-comp.err.txt)
[helloworld.tar.gz](https://github.com/sergeykhbr/riscv_vhdl/files/1865277/helloworld.tar.gz)

kraziant, 2018-04-02:
Today we a trying to use Ubuntu GNU GCC 6.1.0 toolchain RV64IMA (204MB) and it work fine

sergeykhbr, 2018-04-02:
Thank you for the information.

I've looked into the code and this message "err: undefined .shstrab section" isn't critical. It only means that sections names weren't found. And it doesn't affect to the final ROM-image.

kraziant, 2018-04-02:
It's look like SciFive pre-build toolchain is use compressed instruction set, which does't support by project cores. In this case using `-march=rv64g` during helloworld compilation, will not solve the problem, because stdlib builded with compressed insturctions.

kraziant, 2018-04-12:
Done

Closed 2018-04-12.

Thread 14 (2018-07-13):

How to build River CPU?

mateoconlechuga, 2018-07-13:
Hello,

I understand that this is a template for instantiating the CPU on an SoC, however I am wondering if it is possible to just instantiate the River CPU as a standalone entity?

I see this issue: https://github.com/sergeykhbr/riscv_vhdl/issues/9

However I am wondering if it is possible to remove any extra components? Thanks for any help!

sergeykhbr, 2018-07-13:
Hi,
I'm not sure that I correctly understood your question, but:

- Yes, you can get River CPU module and connect it to another AXI4 inteconnect. You will also need boot memory, SRAM, interrupt controller, probably Debug Support Unit and other peripheries.
- Or you can generate VCD-trace file from SystemC model of River CPU and use it as stimulus for RTL simulation.

sergeykhbr, 2018-07-13:
Thank you for this question.

No, I do not use special tool to generate SystemC I do the following steps in development process:
1. Functional models of all devices with integration into SoC functional model. Testing.
2. SystemC model of specific device and automatic comparision of keys parameters relative the functional model.
3. RTL creation and testing relative SystemC using VCD-stimulus.

Closed 2018-07-16.

Thread 15 (2018-07-17):

A few questions

mateoconlechuga, 2018-07-17:
Thanks again for all your help. I just have a few questions concerning the River core:

* It seems that there is just 1 or 2 lines available in the caches. Is there actually a configurable cache size, or is it currently fixed?
* Can RISCV_ARCH be changed to 32 to support the 32bit RISC-V ISA? I see some things that appear to suggest it is hardcoded to 64 bits.
* It seems that the debug unit slave could be connected to a JTAG to AXI master, and then programmed via OpenOCD allowing for gdb debugging. Is there a defined protocol used within the debug module?

sergeykhbr, 2018-07-18:
1. I've tried to save cache upgrade capability with the possibility to make it more configurable but right now I don't need in it because I don't use DDR memory in my projects. Without DDR the caches are just wasting of resources (in my opinion).

2. No. Initially I had such idea to support RV32 only but now I think it is easy to create the separate branch with 32-bits CPU.

3. I have JTAG Test Access Point (TAP) that should work with this system and I can push it into repository. But I don't want to support gdb by myself in the nearest future.

mateoconlechuga, 2018-07-18:
It would be great if you could add that JTAG TAP whenever you have time; it would be greatly appreciated. Is there any things in particular that need to be done in order to support gdb?

sergeykhbr, 2018-07-18:
I will add JTAG TAP module into vhdl and update doxy with the description of scan chain values but I have very limited knowledge of the OpenOCD protocol. I suppose there should be configuration file or front-end module to translate gdb string commands into rd/wr addr/value transaction.

Current doxygen already contains information about DSU registers. Additional information of how-to-use them can be found in debugger's source code.

P.S. See https://www.gaisler.com/products/grlib/grip.pdf, page 66, "JTAG Debug Link" for additional information. The difference only in address width 64 bits instead of 32.

mateoconlechuga, 2018-07-18:
Great, thanks for your help!

sergeykhbr, 2018-07-28:
I've added the JTAG TAP into the system top-level and made simple initial tests in rtl simulator.

Closed 2018-07-28.

Thread 16 (2018-07-18):

Boot procedure bypass ROM FW copy to SRAM

daffy1108, 2018-07-18:
Hi Sergey,

Thanks again for making this RISCV design open to design community.

I'm trying to add a new peripheral and add programming.

So I modified the ADDRESS MAP and logic to add this peripheral.

Is there a shortcut way to add my new code right after

"Registers initialization"

and before

"Copying ROM FW Image into internal SRAM"
"Go to SRAM entry point 0x10000000 in user mode"
"Initialization of the "Interrupt Registers" by proper handler"
"Initialization of the UART"
"Start main task"
?

The sample code also has GPIO writing to the LED.
How to make new code also work before or after GPIO writing to LED.

For simulation, the ROM FW Image copying into internal SRAM is consuming lots of
simulation time and doesn't make for quick and easy debug of my code and logic.

Any other recommendations ?

Thanks,

David

sergeykhbr, 2018-07-18:
- Download the latest GCC from https://github.com/gnu-mcu-eclipse/riscv-none-gcc/releases/ (thanks to Liviu Ionescu <ilg@livius.net>).
- Build elf2raw64 tool and copy it into gcc/bin folder (setup PATH variable).
- Edit examples/boot/src/main.c file by adding your functionality into method *_init()* before *copy_image()* call.
- Modify method led_set(int) accordingly with your requirements.
- Run make (or make.bat) from *examples/boot/makefiles*.
You should get the new HEX-file with your modifications directly used by rtl.

You can do the same things with other examples.

Image is copying under conditions in bootloader:

        if (tech != TECH_INFERRED && pnp->fwid == 0) {
            memcpy(sram, fwrom, FW_IMAGE_SIZE_BYTES);
        }
It means:  not behaviour simulation AND run the first time after power-on. So I suppose you are running NOT behaviour simulation.

daffy1108, 2018-07-18:
Hi Sergey,

Looks like we can modify
fw/boot/src/main.c
to add the peripheral code before "copy_image()".
If we were to comment out the "copy_image()" would RISCV read and execute
from ROMIMAGE instead of SRAM ?

void _init() {
    uint32_t tech;
    pnp_map *pnp = (pnp_map *)ADDR_NASTI_SLAVE_PNP;
    uart_map *uart = (uart_map *)ADDR_NASTI_SLAVE_UART1;
    // Half period of the uart = Fbus / 115200 / 2 = 70 MHz / 115200 / 2:
    //uart->scaler = 304;  // 70 MHz
    uart->scaler = 260;  // 60 MHz

    led_set(0x01);
    print_uart("Boot . . .", 10);
    led_set(0x02);
///////////////////////////// PUT NEW PERIPHERAL CODE HERE ////////////////
    copy_image(); /////////// WHAT HAPPENS IF WE COMMENT THIS OUT ???? //////
    led_set(0x03);
    print_uart("OK\r\n", 4);
    led_set(0x04);
}

Closed 2018-07-25.

Thread 17 (2018-07-24):

loadelf is not working

southlife, 2018-07-24:
Hi, sergey.

Thank you for making River system.
I am following the tutorial now.
However, there are parts that do not work so I leave a question.

[loadelf helloworld] command is work well in Simulator(_run_functional_sim.sh).
But, in the FPGA(_run_fpga_gui.sh), the loadelf command is not work.

Here is the log when I run the command.

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

As you can see, when I run loadelf, edcl does not work properly.
Does it work right in the FPGA?

sergeykhbr, 2018-07-24:
I will check how the latest modifications affected on FPGA target. Did you use the latest version?

Could you also make the following steps to get additional information:
- Halt FPGA before loading new image (because of when loading is finished *loadelf* command restores CPU previous state).
- Check that *npc* register is equal to RESET_VECTORE (value 0x40)
- Read or dump part of memory starting from 0x10000000 (in hex format) and compare it with the generated *helloworld.hex* file.

Thank you

sergeykhbr, 2018-07-24:
I've just tried to build and debug FPGA (ML605) target using Ethernet/UDP TAP and it works fine. The only changes that I've made were the following things:
- Add recently created  *dcom_uart.vhd* file into *misclib* of the ISE project.
- I also wrote 1 into **pnp->fwid** register by sending command 'write 0xfffff004 4 0x1' before loading elf-file. It allows to avoid default image (zephyr) re-loading after soft-reset (see boot/main.c).

Could you provide more information about your setup?

southlife, 2018-07-25:
Thanks for your fast response.

I had test with latest pre-built image(riscv_vhdl-master\rtl\bit_files\v6.0\virtex6_ml605\riscv_soc_river_40mhz_zephyr16_v6.bit) and ML605 FPGA board.

1. When I halt the target before loading elf file, NPC value is 0x10004258 not 0x40.
2. Write 0x1 to 0xfffff004 for bypassing image_copy function in boot-up time as you mentioned.
3. And run [loadelf helloworld] command
4. Then UART0 display the TRAP code as following.

> shell> Boot . . .OK
> ADC clock not found. Enable DIP int_rf.
> mcause:0000000000000002,mepc:0000000010000000

But when I use the latest rtl code(rebuild fpga image in ISE) that you have updated yesterday(added dcom_uart.vhd, dcom_jtag.vhd, tap_jtag.vhd),
It works fine as following!

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

I think it would be a good idea to add writing 0x1 at 0xfffff004 to the tutorials

sergeykhbr, 2018-07-25:
Thank you for your feedback.
I'll move initialization of register *pnp->fwid* into the boot code.

Closed 2018-07-25.

Thread 18 (2018-07-25):

riscv_soc_tb crashes in Vivado Simulator

mateoconlechuga, 2018-07-25:
When I execute the simulation from Vivado 2017.4, in the KC705 project, it produces the following errors:

    Command failed: Simulator command interrupted.

    Simulator engine not responding.
    The simulator has terminated in an unexpected manner. Please review the simulation log (xsim.log) for details.

I'm not sure what may be the cause? Does this occur on your end?

sergeykhbr, 2018-07-25:
I've never run Vivado simulator before. I'm using QuestaSim and the unisim libraries to simulate fpga targets.
Recently I've built and commit new bit-file for KC705 board with all the latest modifications you can try it on your board.

mateoconlechuga, 2018-07-25:
Oh I see thanks!

Closed 2018-07-25.

Thread 19 (2018-07-31):

Potential ICache Bug

mateoconlechuga, 2018-07-31:
It seems that the cache can request two read addresses in sequence, without waiting for the first one to come back. I see this occur often on returns and jumps; causing the processor to enter an undefined state.

sergeykhbr, 2018-07-31:
The latest version actively tested including many-hours FPGA tests. It is always possible that some bug was skipped but it should be exceptionally rare case.

I suppose you have some misunderstanding. The memory transaction considered accepted only when AR_VALID = 1 && AR_READY = 1. There's possible situation when *fetch* module changes read request address while AR_READY=0.

mateoconlechuga, 2018-07-31:
Yes, AR_VALID = 1 && AR_READY = 1 are held both high in consequitive clocks. Here's the hardware capture on the axi bus, alone with the corresponding code.

Where the yellow vertical line is there are two axi requests: (Click for larger)

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

```
000000001000000a <StartHello>:
    1000000a:	1141                	addi	sp,sp,-16
    1000000c:	45b9                	li	a1,14
    1000000e:	00007517          	auipc	a0,0x7
    10000012:	8ca50513          	addi	a0,a0,-1846 # 100068d8 <__errno+0xc>
    10000016:	e406                	sd	ra,8(sp)
    10000018:	016000ef          	jal	ra,1000002e <PrintUart>
    1000001c:	60a2                	ld	ra,8(sp)
    1000001e:	45b9                	li	a1,14
    10000020:	00007517          	auipc	a0,0x7
    10000024:	8b850513          	addi	a0,a0,-1864 # 100068d8 <__errno+0xc>
    10000028:	0141                	addi	sp,sp,16
    1000002a:	0040006f          	j	1000002e <PrintUart>

000000001000002e <PrintUart>:
    1000002e:	87aa                	mv	a5,a0
    10000030:	400006b7          	lui	a3,0x40000
    10000034:	40a7873b          	subw	a4,a5,a0
    10000038:	00b74363          	blt	a4,a1,1000003e <PrintUart+0x10>
    1000003c:	8082                	ret
    1000003e:	4698                	lw	a4,8(a3)
    10000040:	8b21                	andi	a4,a4,8
    10000042:	ff75                	bnez	a4,1000003e <PrintUart+0x10>
    10000044:	0007c703          	lbu	a4,0(a5)
    10000048:	0785                	addi	a5,a5,1
    1000004a:	c2d8                	sw	a4,4(a3)
    1000004c:	b7e5                	j	10000034 <PrintUart+0x6>
```

From icache.vhd, this line: https://github.com/sergeykhbr/riscv_vhdl/blob/master/rtl/riverlib/cache/icache.vhd#L261-L263
Appears to issue this because instruction address 1000002e has lower bits "110". This causes `r.double_req` to be set, which then causes a second request before the first one completes.

I'm not sure if my reasoning is correct.

sergeykhbr, 2018-08-01:
It doesn't look good. But I noticed that you're using another system. In my opinion the interconnect has to lower AR_READY signal just after first transaction was accepted.

There's another possibility for such behavior if your interconnect implements buffered ports accepting several transactions.

mateoconlechuga, 2018-08-01:
Yes, the interconnect is able to accept several transactions (but that is part of the axi standard?) Anyway, I guess I can try lowering AR_READY when the transaction gets accepted, and then raising it when the response comes back?

sergeykhbr, 2018-08-01:
I agree that you found a problem occurring with the buffered interconnect with the queue length more than one and it should be fixed somehow.  But it's a bit another use case that I cannot reproduce right now. If you provide solution it would be very nice.

Accordingly to my experience fix for such problems may have undesirable side effects on long tests.

sergeykhbr, 2018-08-08:
Can you try the following patch to avoid bus request signal from caches before previous response has been received?

[rtl_cache_buffered_out_patch.txt](https://github.com/sergeykhbr/riscv_vhdl/files/2270023/rtl_cache_buffered_out_patch.txt)

Thread 24 (2019-06-14):

freertos port for river core

suhasskrishanmurthy, 2019-06-14:
Hi, I want to port freertos on the river core,so is there any links where i can refer or if you have done it would you share the steps? . I have gone through the freertos site

sergeykhbr, 2019-06-14:
Hi,
I didn't port freertos and I don't have necessary steps.

If you are not going to change ROM bootloader implemented in the SoC you should build freertos as a usual user application with program entry point 0x10000000 (internal SRAM base address) and change parameter CFG_SIM_FWIMAGE_HEX in *config_[target].vhd*.

Bootloader will copy your application image from ROM with this image into internal SRAM and jump to the entry point.

To implement serial output/input (printf/cin) please refer to the examples in folder *./examples*

suhasskrishanmurthy, 2019-06-17:
thank you for replying.
I actually went through this link https://www.freertos.org/Using-FreeRTOS-on-RISC-V.html
is this sufficient or any changes to be made?
I just have a few questions.
1.is there any changes to be made for memory map,interrupts tables,uart etc..

sergeykhbr, 2019-06-18:
Your question is too common.
Freertos tutorial has a statement that 3 boards are supported: MiFive, VEGABoard ans SiFive. So if you want another one you need to add it manually changing configuration and source files, memory map, interrupts, drivers etc. I'm not going to port freertos myself in the nearest future.

If you have problems with my rtl code or simulator please attach error message and log files.

Closed 2019-06-18.

Thread 28 (2019-08-27):

showing CPU is turned off

suhasskrishanmurthy, 2019-08-27:
I followed the steps present in Readme for setting debugger
and ran _run_functional_sim.sh
after this a prompt cmd# came in that i tried loaded helloworld
cmd# loadelf /home/riscv/helloworld
after this it showed reading some section
after this i pressed F5 but its showing
[25867098, "core0", "../src/common/generic/cpu_generic.cpp:428 CPU is turned-off"]

what am i doing wrong
I reconfigured ip address to 192.168.0.53
using command
sudo ifconfig eth0 192.168.0.53 netmask 255.255.255.0

sergeykhbr, 2019-08-27:
This is definitely a bug. Thank you, I will fix it in a couple of days.

Some simulation platforms have a Power-on button to simulate Power Cycle. The demo Hello World system doesn't implement this functionality that's the root cause of the problem

Closed 2019-08-30.

Thread 29 (2019-08-29):

Openning ttyUSB0 at 115200 . . .failed"

suhasskrishanmurthy, 2019-08-29:
I am trying to run application debugger on top of fpga.
so i executed fpga_gui.sh and used loadelf tool to load the zephyr.elf onto fpga but it says
[0, "port1", "../src/libdbg64g/services/comport/com_linux.cpp:152 fopen() failed"]
[0, "port1", "../src/libdbg64g/services/comport/comport.cpp:128 Openning ttyUSB0 at 115200 . . .failed"]
[0, "edcltap", "../src/libdbg64g/services/debug/edcl.cpp:99 No response. Break read transaction[1] at 80090000"]
[0, "udpedcl", "../src/libdbg64g/services/debug/udp_dbglink.cpp:224 sendto() failed

this never stops
and also LED @ ethernet do not blink at host system side
i have used sudo  ifconfig eth0 192.168.0.53 netmask 255.255.255.0
to change the ip of my pc
I also changed COM3 to ttyUSB0 as you have mentioned since my host is ubuntu 18.04
is there any other source file that i need to change.
please tell what am i doing wrong?

sergeykhbr, 2019-08-30:
I think there're at least two problems:
   - Serial output doesn't work
   - No debug connection via Ethernet

To start solving the 1-st one you should load any fpga image that can generate uart output (river soc or anything other). If you would see correct output in any console client then it should work in simulator's 'serial console' widget when you specify the same port settings in JSON-configuration file (*fpga_gui.json*).

The second problem may be caused by firewall settings or something like that, for me it is harder to help because I don't use linux for the hardware debugging. Maybe you will find something helpful in this document (chapter 5)
[riscv_vhdl_trm.pdf](https://github.com/sergeykhbr/riscv_vhdl/files/3559007/riscv_vhdl_trm.pdf)

FrankAnze, 2019-09-20:
Hi, I had the same problems.

I solved uart's problem by changing 'COM3' to '/dev/ttyUSB0' ('ttyUSB0' doesn't work for me) but I couldn't solve the debug connection via ethernet.

I can see the FPGA from my PC as you can see in the following image:

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

I noticed that when running './_run_fpga_gui.sh' an error related to CoreService 'core0' appears at the beginning:

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

While running the simulator './_run_functional_sim.sh' the following appears:

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

I was also seeing the files 'fpga_gui.json' and 'functional_sim_gui.json' and I noticed that 'fpga_gui.json' has much less services than 'functional_sim_gui.json' such as 'TcpServerClass', 'SerialDbgServiceClass', 'CpuRiver_FunctionalClass'.
I didn't find any service called 'core0' in 'fpga_gui.json' but I have no idea if that could be the problem. Could it be that there is a problem with 'fpga_gui.json'?

Regards,
Frank

sergeykhbr, 2019-09-21:
This message formed by *ConsoleClass* and used to debug zephyr os during development. I removed this attribute and you won't see it anymore.

This modification cannot affect Ethernet debug link. Probably you could try to find information about how to setup EDCL debug link on linux for LEON3 boards because they use absolutely the same ethernet module and settings.
Take into account that EDCL module of MAC can response only on ARP requests and ignore all others. By this reason firewalls can mark the device as unhealthy or something like that. I disable all services and protocols except IPv4 for the eth. port connected to fpga board (on windows)

Closed 2019-11-26.

Thread 30 (2019-09-05):

Generating bit file for boot up using debugger

taniyagarg4, 2019-09-05:
I am using a linux machine for fpga implementation of river core with freertos.
As you suggested, i changed COM3 to ttyUSB0 in debugger/targets/fpga_gui.json
After this, when i tried to generate bit file, i got the error that it can not access bin folder in riscv_vhdl/examples/dhrystone/makefiles/
So, i checked the repository and saw that the folder name was changed from bin to binarm
I renamed the folder to bin
As per your suggestions, I also did the following:
      1. desabled FPU
      2. commented CFLAGS += -march=rv64imac -mabi=lp64 statement in examples/bootrom_tests/makefiles/make_bootrom_tests

After this, when I tried to generate the bit file, it gave the error that I am trying to access the dhrystone21.hex after the limit of the file.
After further debugging, I found that the ROM_LENGTH calculation in rom_inferred.vhd file exceeds the dhrystone.hex file limit.
Can you please check these issues and let me know what am I doing wrong?

sergeykhbr, 2019-09-05:
Just several comments because in your question actually several questions:

- You can freely change json-configuration files it cannot affect the build process.
- *examples/dhrystone/makefiles/binarm* folder contains the **pre-built** hex-image + elf (with debug symbols) for ARM processor (not a RISC-V). These files are used by target *functional_arm_gui.json* or with the custom ARM-R5 system that not in the repository. You shouldn't rename it.
- FPU is disabled by default for *boot/* example. See the parameter *FPU_ENABLED=0* in the *make_boot*. Total size of the boot image 3 KB it is much less than available 'bootrom' space.
- I am using own utility **'examples/elf2rawx'** to generate hex-file. So you can try to build it and copy the binary file 'elf2rawx' into the folder with your gcc compiler:

         $ cd examples/elf2rawx/makefiles
         $ make
         $ cp elf/elf2rawx $(YOUR_CUSTOM_RISCV_GCC_FOLDER)
         $ cd ../../dhrystone21/makefiles
         $ make

- What version of gcc you are using (or actually where I can get the same to reproduce your result)?
- Are you going to port freertos yourself?

taniyagarg4, 2019-09-05:
i have actually followed your steps and sorry we are booting zephyr the way
you have done.
i was to change the folder name because it is giving an error while
generating bit file. So if i should not rename then what is to be done

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

--

*Thanks and Regards*

Taniya Garg

Mail: taniyagarg4@gmail.com

Mob: +91-9606815185

sergeykhbr, 2019-09-05:
I think I've understood. There're special *.vhd configuration file for each project:
- *rtl/prj/kc705/config_k7.vhd* for the KC705 board
- *rtl/prj/ml605/config_v6.vhd* for the ML605 board
- *rtl/prj/modelsim/config_msim.vhd* for the simulation in QuestaSim
- etc

All these files have the following constants definition:

    constant CFG_SIM_BOOTROM_HEX : string :=
                CFG_TOPDIR & "examples/boot/linuxbuild/bin/bootimage.hex";

    constant CFG_SIM_FWIMAGE_HEX : string :=
                CFG_TOPDIR & "examples/zephyr/gcc711/zephyr.hex";

Make sure that these constants are the same as shown above to run zephyr. It possible to change them to run bare-metal Dhrystone benchmark or *bootrom_tests* for CPU verification or redefine *CFG_TOPDIR* parameter.

taniyagarg4, 2019-09-06:
Ok sir I will try this but if I want to use the hex image I generated using
your specified method, then what should I do because that is the one that's
giving error?

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

sergeykhbr, 2019-09-15:
In that case please share information about gcc version and build log.

Closed 2019-09-17.

Thread 31 (2019-09-17):

Uart Conf

suhasskrishanmurthy, 2019-09-17:
we want to use debugger for booting zephyr, In .ucf file you have connected uart1 to usb-uart convertor where as debug uart goes to LPC, So do we need to swap these as debugger is not able to connect uart in present situation.

sergeykhbr, 2019-09-17:
Yes, you may swap these UARTS ports to be able debug via serial interface.
Take into notice that UART debug port is the master device and it automatically detects port baud rate on debugger connection (only first time after hard reset).

Closed 2019-11-26.

Thread 35 (2020-03-11):

Communicating with the ML605 Board (v8.0)

gutkedu, 2020-03-11:
Hello,

I'm having an issue or misunderstanding for communicating with the processor via UART. I downloaded the bitstream v8.0 into the ML605 board using iSE Impact, opened the UART channel on my computer and when I press RESET, I receive only a byte 00 on UART.

Also, it is possible to generate the bitstream for the ml605 board in the v11?

Thanks

sergeykhbr, 2020-03-12:
Hello,
- Check that you setup 115200 baud rate.
- ML605 is a quite obsolete board which is not supported in Vivado (I entirely switched into kc705). But you can build bit-file in ISE Studio from the latest 'master' (I've just checked it) and try to run it on your board.

gutkedu, 2020-03-13:
I checked and it is on 115200 baud rate, I tried multiple versions of the bitstream already, version 7.0, 8.0 and 11.0  (generated the bitstream with Xilinx ISE myself) but no success, I`m still receiving  0x00 on uart input. Maybe my board has a problem...

sergeykhbr, 2020-03-13:
Did you try to connect to board via Ethernet?
Could you try the following file?
[r5_soc.zip](https://github.com/sergeykhbr/riscv_vhdl/files/4331381/r5_soc.zip)

gutkedu, 2020-03-13:
I didn't try connecting with the ethernet and downloading the debugger. I tried this r5_soc bit file and still the same issue, next week I'm going to try to find the problem again, could be a problem with the board or with the software, I'm not sure

Closed 2022-09-15.

Thread 37 (2020-07-15):

problem compilation with options: -march=rv64imafd -DFPU_ENABLED

bitprog10, 2020-07-15:
Здравствуйте! Попробовали пересобрать helloworld с функцией сложения двух чисел типа double. Использовали компилятор riscv64-unknown-elf-gcc-8.3.0-2019.08.0-x86_64-linux-ubuntu14 от SiFive с опциями -march=rv64imafd -DFPU_ENABLED.
В helloworld.dump в разделе функции fadd присутсвует недокументированная команда fmv.d. При моделировании в  данном месте возникает исключение из-за нелегальной операции.

Как можно решить данную проблему?

Листинг модифицированной части helloworld.c прилагаю:

double fadd(double a, double b){
    double c=a+b;
    return c;
}

void helloWorld() {
    char ss[256];
    int ss_len;
    ss_len = sprintf(ss, "Hellow World - %d!!!!\n", 1);
    print_uart(ss, ss_len);
    fadd(10,10);
}

sergeykhbr, 2020-07-16:
I can reproduce this exception. CPU module doesn't support Compressed version of the instruction FLD (load double value from memory), so there's several options:
- Add this instruction into simulation
- Disable hardware FPU
- Disable compressed instruction set. It can be done by adding at the beginning of the any *.cpp file the following option so that Compressed instruction set will be disabled only for this file:

       asm(".option norvc");

- Wait until I will add this instructions into RTL and simulation.

Closed 2022-09-15.

Thread 41 (2021-09-27):

How to generate VCD files of bare-metal dhrystone with _run_systemc_sim.sh?

cnjsdfcy, 2021-09-27:
Hi Sergey,

Thanks for sharing this nice project.

I assume RISC-V SystemC model is CABA(Cycle-Accurate Bit-Accurate), right?

And I want to view it's waveform of some workloads, e.g. the pre-built dhrystone21.elf.
So, I managed to build the master branch code successfully (some modifications to satisfy compilation and added some missing files in the makefile), then I tried to add loading dhrystone21.elf with below modification:
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
But, after waiting some seconds, seems nothing have been run, please check the **attachment for log**.
[sc.log](https://github.com/sergeykhbr/riscv_vhdl/files/7236011/sc.log)

And below is screenshot of the pop-up Universal platform simualtor:
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

Any suggestions to correctly dump VCD waveform?

Thanks,
Cai Yu

sergeykhbr, 2021-09-27:
Hello, your assumption about the cycle accurate model is correct.

Here's the short description of the JSON-configuration file:
1. 'InitCommands' list attribute contains a list of commands that will be send to simulator during startup. Command 'loadelf _filename_ <b>nocode</b>" just loading symbol information (available in the Symbol Browser of simulator) without actual code flashing.
2. File image that actually used during CPU boot is defined here:
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
3. To generate VCD file just define output file name here:
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
4. Then you will be able to use any viewer (gtkvave as an example):
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

cnjsdfcy, 2021-09-27:
Thanks for your quick reply.

I tried with the bootrom_tests.hex, but it still not running correctly:
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

sergeykhbr, 2021-09-27:
Yes, I'm developing new updates for the CPU and disconnect temporary interrupts request pins from pipeline. This problem is a sequence of current development because bootrom_tests intentionally reads/writes into unmapped regions to check proper exceptions handling. You could try stable tagged version v11.0 to run this test.

cnjsdfcy, 2021-09-27:
I tried both v11.0 and v10.0, both warning with access of unmapped address, but V10.0 print out _HARTID_ in uart0 quickly however V11.0 doesn't. Anyway, I will try to modify and build the bootrom_test to generate a clean and short test/waveform.

Thanks, I am closing this issue.

Closed 2021-09-27.

Thread 43 (2023-04-18):

Run Hello world example on VC707 board

Mina2411, 2023-04-18:
Hello,
Thanks for this great work, I appreciate the whole work. It is extremely beneficial.
Actually,I removed the constraint file of KC705 board, and I used the constraint file of VC707 board, and I did the matching between them. Fortunately, the bit stream is written successfully and uploaded on the board.
However, I need to test the processor on the board, so I chose the simple hello world example using the UART module, but I don't know what should I do to test hello world on the board. I know that I need a compiler to produce HEX file format for the C program and then put the path for the generated HEX file somewhere in the code (I think in the sram module), so Kindly can you tell me the steps to test the hello world example because I am not able to get this point from the repository.
Thank you in advance,
Mina

sergeykhbr, 2023-04-18:
If you properly ported KC705 target on VC707 you should see UART1 output generated by 'bootrom_tests' example (115200 baudrate). By default, HEX-files _bootrom_tests_hi/lo.hex_ are used to initialize internal ROM of the SoC (see configuration parameter CFG_BOOTROM_FILE in file *sv\prj\impl\kc705\config_target_pkg.sv*). These files were pre-built and committed so you do not need to compile them manually. Check this output before experiment with the "Hello, World!" example.

You have several options:
1. Universal approach quite standard for any board
1.1. Configure and compile *'openocd'* to debug board via JTAG interface. Enable desired interface during configuration (jlink or whatever JTAG-debugger you are going to use). You also can find pre-built openocd binaries for Linux and Windows.
1.2. Compile helloworld in a usual way to get ELF-file (you do not need HEX-files in this case)
1.3. Change first line argument **remote_bitbang** in the openocd configuration file _openocd_gdb_cfg\bitbang_gdb.cfg_
```
// jlink is an example
adapter driver jlink
```
1.4. Start and connect to VC707 via JTAG *openocd -f bitbang_gdb.cfg*. Take into account that JTAG TAP module is a part of the system (SystemVerilog files) so you can assign TCK, TMS, TDI, TDO and TRST signals on any convenient for you GPIOs.
1.5. Use *load_image <your_path>/bin/helloworld* and *resume* commands to load image into RAM and start the execution. (See openocd script description or telnet connection to port 4444). Or use **gdb** to connect to *openocd* and all functionality provided by gdb.

2. Second option is to generate HEX-files to initialize ROM instead bootrom_tests
2.1. Compile 'examples/elf2rawx' utility
2.2. Copy *elf2rawx* binary file into folder with your gcc binaries or modify PATH environment variable so that *'make'* could find it.
2.3. Compile helloworld you should get hex-files
2.4. Modify parameter CFG_BOOTROM_FILE in *config_target_pkg.sv*.

**Most probably you do not need to build Hello World to check your bit stream file you should see UART output as following:**
```
HARTID . . . . .0
HARTS. . . . . .1
PLIC_IRQS  . . .73
HWID . . . . . .0x20221101
FWID . . . . . .0x20220116
PLIC . . . . . .PASS
MTIMER . . . . .PASS
SWIRQ. . . . . .PASS
L2.Coherence . .Disabled
PMP. . . . . . .PASS
MMU.MPRV . . . .PASS
HW_FPU . . . . .testing
Testing FADD
Testing FMUL
...
```

Mina2411, 2023-04-20:
Hello again,
Thank you for your reply, and I will try to follow these steps to get any output.However, I need to understand the pipelined stages, and the signals going in and out from each stage, but this is difficult from the VHDL code, so do you have any inspiration diagram that you followed while you are writing your design; I mean by diagram something like that for instance.
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

Thank you in advance,
Mina

sergeykhbr, 2023-04-20:
Sorry, I do not have the diagrams like that

sergeykhbr, 2023-04-25:
Hi,
current version of SoC for FPGA (KC705) is placed in folder sv (System Verilog) to build bitstream file:
```
cd sv\prj\impl\kc705
make
```
Vivado should be in your PATH directory. I suppose 'make' could be also run from Vivado command console. You do not need to change anything all paths in the project are project relative.
vhdl is an obsolete version do not use it. It will be overwiten in the future.

Mina2411, 2023-04-27:
Hello again,
I have used the sv version of the riscv, and I have a question in the constraint file. I found a lot of lines similar to that one,
"set_property LOC PHASER_OUT_PHY_X1Y3 [get_cells  -hier -filter {NAME =~ */ddr_phy_4lanes_2.u_ddr_phy_4lanes/ddr_byte_lane_D.ddr_byte_lane_D/phaser_out}]"
Kindly, I want to know what these lines mean "I think it is related to routing of nets", as this is the first time I saw such lines in a constraint file, so that I can match these lines to the constraint file of VC707 board, as I am having a lot of routing errors when I use the constraint file of VC707 board, and also I would like to know where can I get this routing information, as I was searching in the user guide, and I found nothing there.
Thanks,
Mina

sergeykhbr, 2023-04-28:
You need to generate DDR controller using Vivado IP generator for your board. And then integrate it into the project.

You also have another option - remove entirely DDR controller from the project and nullify AXI/APB interfaces connected to Bus Controller. In this case _bootrom_tests_ will works as usual from the internal SRAM/ROM but you won't get the change to enjoy porting Linux.

sergeykhbr, 2023-04-28:
To debug FPGA board use the standard RISC-V development toolchain: gcc, openocd + gdb. You can build it or find and download binaries in the Internet. It will allow to load application into internal SRAM and execute them.

Debugger in this repository should be used for the verification purpose:
- debug functional simulation
- debug SystemC simulation (full analog of the RTL simulation)
- debug RTL if you know howto to use DPI and your simulator supports this feature.

I'm using own version of the HEX generator (elf2rawx) because in some specific ASIC cases ROM couldn't be implemented as a single block and I need several HEX-files to initialize all ROM blocks. Probably you can find standard utility for that elf2hex or objdump.

Mina2411, 2023-04-30:
Hello,
I will try to get the gcc compiler, but is the riscv processor is 32 or 64 bits, as when I was exploring the boot_rom_tests, I saw that the instructions is 32 bits (8 HEX each), but the boot rom file consists of 64 bits instructions, so this will help me to download the gcc version I think.
Thanks,
Mina

sergeykhbr, 2023-04-30:
This repository implements 64-bits CPU.
Memory width isn't determined by the CPU, it could be 8-bits or 256-bits and perfectly work with the 32 and 64-bits CPUs. It directly affects CPU throuput/latency/performance either as many other configuration parameters of the CPU, System Bus and Caches.
Parameter CFG_LOG2_SYSBUS_DATA_BYTES specify system bus width

mito200, 2023-05-01:
Hello Serge,
I can not find the original C file from which the bootrom tests hex file is generated . I need it to nullify the Dram function or test in it . I really appreciate your help . Thanks in advance.

mito200, 2023-05-01:
Moreover, Kindly can you please tell me if there is any method to open the gui for the sv project rather than running the make command in the kc705 directory ( like opening the vhdl project from the xpr file for example)

sergeykhbr, 2023-05-02:
1. All source files of the bootrom_tests are here: https://github.com/sergeykhbr/riscv_vhdl/tree/master/examples/bootrom_tests/src

2. No. The bitstream file is generated from console. You can create project file manually by adding all files from the 'sv' sub-folder plus constrain file from the 'kc705' sub-folder.

Mina2411, 2023-05-03:
Hello again,
Kindly,I need to make sure of a certain point,if I have a program, and I want to test it on the processor, I would place the path of the hex file of the program in the config_target_pkg.sv, this is what I understand, but I can't find the link between the rom_inferred_2x32 which is the module where the hex files are read (then this module is port mapped in rom_tech.sv file) and the pipeline stages, so the program instructions will go through the pipeline. so could you please clarify the module or the part where this files are linked together?
Thanks,
Mina

sergeykhbr, 2023-05-03:
Sorry, I don't understand why you expect link between ROM and "pipeline". ROM is an independent module with the AXI interface. There're a lot of things between "pipeline" and ROM: Bus Interfaces, L2 coherent bridge, L1 bridge.

mito200, 2023-05-05:
Hello Serge again,
Can you tell me please which compiler have you used or send me a link to it?
Thank you

mito200, 2023-05-05:
But one last trial with my compiler can you please ellaborate to me more what you mean in tghe previous comment of elf2rawx and make file staff to initialize the rom

mito200, 2023-05-05:
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

Okay I am stuck now in option 2 here, I have compiled the elf2ravw sources and have the elf file and then added it to the same directory where all gcc binaries like gcc-unknown-elf-gcc are in so now can you tell me what is the next step as I can not understand it from this comment

sergeykhbr, 2023-05-06:
Use the following to generate helloworld.hex:
```
elf2rawx helloworld.elf -h -f 65536 -l 8 -o helloworld.hex
```
or the following to generate *_hi.hex and *_lo.hex
```
elf2rawx helloworld.elf -h -f 65536 -l 8 -o helloworld_hi.hex -o helloworld_lo.hex
```
File __sv\rtl\techmap\mem\rom_inferred_2x32.sv__ uses hi/lo files to initialize two 'rom_inferred_32' modules each 32-bits width.

Mina2411, 2023-05-08:
Hello again,
I have tried many options to compile helloworld and produce the hex file, but the problem is that the stack pointer is not initialized correctly, so the program can't be started because the Dram block is nullified, so I am having only the internal memory. I have also tried different gcc compilers and different versions, but the same problem appears, and I can't link between elf2rawx and helloworld to generate the correct hex file due to linker problems may be the compiler isn't compatible with this riscv or missing libaries and packages, so please if you have the hex file for helloworld that is running on this riscv send it, so we can use it. we are only trying to test the processor to perform some work on it in the near future, but we are stuck in this initial step, so if you can help us to proceed, we will be thankful because we must test this simple helloworld example before doing any additional steps.
Thanks,
Mina

sergeykhbr, 2023-05-08:
Definitely you need the startup file (assembler) that will properly initialize CPU/CPUs depending of the configuration before user application entry point will be called. Absolutely sure that it requires some experience of working with bare metal to link newlib or whatever compiler is used with the standard printf, malloc or C++ functions. This tutorials is a bit out of this project.

Generally I suggest do not modify hardware (fpga porting) and software (bootrom_tests) at the same time. If the _bootrom_tests_ successfully starts on your FPGA it should be trivial to modify it and print "Hello World". Other examples (except riscv_tests) could be obsolete and it is out of my scope to provide ready-to-use out-of-the-box SDK.
Current implementation is complied with the RISC-V specifications and the standard approach for any RISC-V board (actually for any architecture) should be used.

sergeykhbr, 2023-05-31:
Makefile of the helloworld example was updated and HEX-files committed to run this application in the same way as the default bootrom_tests example (just change parameter CFG_BOOTROM_FILE_HEX).

Thread 44 (2023-05-11):

riscv_soc_tb Simulaton

Youssef-IA, 2023-05-11:
Hi,
Thanks for your efforts.

I wanted to run a simulation as mentioned in http://sergeykhbr.github.io/riscv_vhdl/verification_page.html#sim_tb_link and unable to find the mentioned testbench file or a document that explains the expected behavior.

On the other hand, I tried to run through the following path iscv_vhdl/vhdl/rtl/prj/sim, after creating a questasim makefile the mimics the committed xilinx makefile. But, I do not understand what is the expected behavior while moving from a JTAG test to another, is that documented anywhere?
Also I noticed that both Ethernet & UART enables are instantiated with 0, is that intended?

That's the waveform output
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

sergeykhbr, 2023-05-11:
Hi,
I didn't update documentation quite a long period of time. It contains a lot of obsolete information, sorry for that.
Here're the list of possible simulation configurations:
1. ASIC unisim simulation (most generic and full simulation) using ncsim:
```
cd riscv_vhdl\sv\prj\impl\asic_sim
make build
make gui
```
2. KC705 simulation (it requires library with the Secure IP components (SIP-components) to simulate DDR controller using ncsim. I think it is possible to simulate this FPGA project entirely in Vivado.
```
cd riscv_vhdl\sv\prj\impl\kc705_sim
make build
make gui
```
3. Build KC705 bitstream file:
```
cd riscv_vhdl\sv\prj\impl\kc705
make
```
4. Simulate SystemC precise model:
```
- Download and build systemc library
- Specify env, variables SYSTEMC_LIB and SYSTEMC_SRC accordingly with the build folder
- Use CMake for \riscv_vhdl\debugger\cmake to generate project (I am suing Visual Studio)
- Build project and run configuration from cmake bin output directory:
        riscvdebugger.exe -c riscv_vhdl/debugger/targets/sysc_river_x1_gui.json
```
5. openocd + gdb could be used with the RTL simulation and SystemC to verify and debug simulation as a real hardware.

Youssef-IA, 2023-05-15:
Hi again,
Thanks for your response.

I am unable to use Vivado currently, but Simulation started successfully using questasim showing the green terminal of the uart output .. but nothing is printed. Is there any configuration that needs to be added or maybe tool issue?

If I want to try helloworld example, should I add the generated .hex file somewhere? I tried to load it into rtl/techmap/mem/rom_inferred_32.sv & rtl/techmap/mem/rom_inferred_2x32.sv modules but nothing happened.

If that is documented anywhere just please refer to it and i will check.

sergeykhbr, 2023-05-15:
There's no need to change configuration or hex-files to run simulation.
As an example I've just run clean repository _asic_sim_ simulation with the following result:
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

Time diagram above shows the following signals:
- Boot ROM values to check that HEX-files were read successfully:
-- asic_top_tb.tt.soc0.boot0.o.r_valid
-- asic_top_tb.tt.soc0.boot0.o.r_data
- UART td with 115200:
-- asic_top_tb.tt.soc0.uart1.o_td
- Core[0] executed instructions:
-- asic_top_tb.tt.soc0.group0.xslotcpu[0].cpux.river0.proc0.exec0.o_valid
-- asic_top_tb.tt.soc0.group0.xslotcpu[0].cpux.river0.proc0.exec0.o_pc[63:0]

You can use the same signals to check your simulation.
UART VIP decodes the _td_ signal and writes accumulated bytes into file uart_0.log (it should be created in your questasim project). Console just read and show content of this file.

Youssef-IA, 2023-05-21:
Thanks for your help, It is highly appreciated.
I started the simulation successfully, but it is not the same as yours. It stops at 414.8875 us and o_pc = 00...0100b8
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

I'll be debugging the issue, is there anything that you could provide to help? where to start from?
Also I think that If I need to change the scenarios, I need to add the hex file to the boot ROM memory, right? (e.g.: hello_world.hex)

sergeykhbr, 2023-05-21:
1. I see that CPU starts working as expected but failing on the first FPU instruction:
```
100b8:	f2000053          	fmv.d.x	ft0,zero
  fmv.d.x f1, x0
```
Did you change configuration parameter CFG_HW_FPU_ENABLE? It is enabled by default and I actually didn't try to disable it.
Could you check that inside of execute module is properly instantiated module _fpu0_ (FpuTop)?

2. Hello world example is quite obsolete example and to run it properly it should be build with some startup file that initialize CPU registers and others peripheries. Example of such _startup.S_ file you can find in the folder _examples/common/system/startup.S_. Basically, hello world requires some makefile and source code modifications to start it properly.
To generate hex-files I use utility _examples/elf2rawx_. Take into account that the latest RTL simulation instantiates 2 ROM blocks and it requires 2 hex files with the suffixes _hi.hex and _lo.hex. Parameter CFG_BOOTROM_FILE specifies only one file but these suffixes will be added in the file "rom_inferred_2x32.sv".

Generate 1 hex- file:
```
elf2rawx example.elf -h -f 65536 -l 8 -o example.hex
```
Generate 2 hex- files:
```
elf2rawx example.elf -h -f 65536 -l 8 -o example_hi.hex -o example_lo.hex
```

Youssef-IA, 2023-05-28:
Hi,
Thanks a lot for the detailed reply, that's really appreciated.

I started debugging the fpu module as you mentioned, CFG_HW_FPU_ENABLE=1 & the module is properly instaniated.
So I started checking the internal signals, FPU inputs mainly.
I found that **fpu0.i_en=1** just 1 clock cycle before the mentioned fpu instruction (100b8), then goes down.
Also both of the inputs (**fpu0.i_a & fpu0.i_b**) are stuck to **0** jsut before that command (100b8).
is that expected? and what is the previous command (100b4) stands for?

Is there a document or another program explaining what is expected from the simulation so that I can debug more?
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

sergeykhbr, 2023-05-28:
Hi, let's start it working with Questa.
- If you compile _bootrom_tests_ example you will get listing file (bootrom_test.lst) with the disassembled code. I think it's better than documentation (see link below).
```
# intialization when HW FPU enabled
#ifdef FPU_ENABLED
  fssr    x0
   100b4:	00301073          	fssr	zero
  fmv.d.x f0, x0
   100b8:	f2000053          	fmv.d.x	ft0,zero
  fmv.d.x f1, x0
   100bc:	f20000d3          	fmv.d.x	ft1,zero
  fmv.d.x f2, x0
```
- Instruction 100b4 is also FPU instruction or more precisely it is a privileged instruction to write into CSR (Control Status Register) which is available for the disabled and enabled FPU. Your simulation looks good for me at this point.
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

- I've prepared VCD file (o_river.vcd) generated by SystemC model that I use as a reference in a case of problems (as shown on picture above). It should help you to identify the difference with RTL. See the link https://github.com/sergeykhbr/riscv_vhdl/tree/tmpstorage/files

Youssef-IA, 2023-07-25:
Hi , thanks a lot for your help
The simulation now resumes bs it hangs like this, with no output in the UART, o_pc = 10e18
10e18:   0000100f            fence.i

just to confirm, you are using examples/bootrom_tests/linuxbuild/bin/bootrom_tests.hex file, right?
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

sergeykhbr, 2023-07-26:
Hi, could you simulate a bit longer? Fence.I is a quite time consuming operation.
We have a bit different gcc version and as a result build files, but I suppose this Fence_I is from 'exception_handler_c' method and it means that something executed in a wrong way. Could you provide more info what happened before _pc_ jumps into exception?

Youssef-IA, 2023-07-30:
Hi,
I simulated longer time (2ms) but the screenshot is just cropped, **it later jumps to this command and keeps repeating**
10e1c:   0001f7b7            lui a5,0x1f
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

The last commands **before the exception** are (in order before the exception)
19c98:   fcf42823            sw  a5,-48(s0)
11a34:   fe010113            addi    sp,sp,-32
11a38:   00813c23            sd  s0,24(sp)                                                                                                                                         
11a3c:   02010413            addi    s0,sp,32
 malloc_type *pool = (malloc_type *)ADDR_BUS0_XSLV_SRAM;
11a40:   080007b7            lui a5,0x8000
11a44:   fef43423            sd  a5,-24(s0)
 pnp_map *pnp = (pnp_map *)ADDR_BUS0_XSLV_PNP;
11a48:   100ff7b7            lui a5,0x100ff
11a4c:   fef43023            sd  a5,-32(s0)
// 8-bytes alignment
pool->allocated_sz = (sizeof(malloc_type) + 7) & ~0x7ull;
11a50:   fe843783            ld  a5,-24(s0)
11a54:   00001737            lui a4,0x1
11a58:   81870713            addi    a4,a4,-2024 # 818 <_ftext-0xf7e8>
11a5c:   00e7b423            sd  a4,8(a5)

_trap_table:_
10004:   7500006f            j   10754 <trap_entry>

_trap_entry:_
10754:   340f1073            csrw    mscratch,t5
10758:   34202f73            csrr    t5,mcause
1075c:   100f5c63            bgez    t5,10874 <handle_exception>
10874:   00123023            sd  ra,0(tp) # 0 <_ftext-0x10000>
..... the above commands were repeated multiple times ....

_handle_exception:_
..... multiple commands from handle_exception function .....:
108e8:   0e323823            sd  gp,240(tp)
108ec:   51c000ef            jal ra,10e08 <exception_handler_c>

_void exception_handler_c() {_
10e08:   fe010113            addi    sp,sp,-32
10e0c:   00113c23            sd  ra,24(sp)
10e10:   00813823            sd  s0,16(sp)
10e14:   02010413            addi    s0,sp,32
10e18:   0000100f            fence.i   <<<<<< The hanging command

sergeykhbr, 2023-07-31:
It looks like exception occurs on write access into the pnp module register. I suppose that pnp (or the whole apb-bridge "bus1") weren't properly instantiated and connected. It should be quite easy to track error on apb-bridge in/outs.

Youssef-IA, 2023-08-16:
Thanks for you response. I will debug it.

I was checking the new commits and I found that you updated the helloworld example after our earlier conversation, so
 in asic_sim_pkg.sv, I changed:
localparam CFG_BOOTROM_FILE_HEX = "../../../../examples/helloworld/makefiles/bin/helloworld";

And Ran the simulation again, It hangs at o_pc = 100c0, which is a very simple ori command
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

And the UART prints this unkown character
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

Do you have any idea what is the issue? Did I miss something while updating CFG_BOOTROM_FILE_HEX?

sergeykhbr, 2023-08-16:
It looks like simulation reads xxxx from address 0x1b8c8 that stucks the simulator when it tries to OR the results. Or less probable, this address is not responding.

Main idea here is to initialize mtvec CSR register and enable vector mode (bit[1:0] = 0.1)

Youssef-IA, 2023-11-16:
Thanks a lot for your help, the design is running now.
But I am not sure if it's running as expected, can you please provide the expected UART output ?

sergeykhbr, 2023-11-16:
Hi, happy to hear that. Here's one of the latest output (sd-card disconnected):
```
sdtype: unknown
HARTID . . . . .0
HARTS. . . . . .1
PLIC_IRQS  . . .73
HWID . . . . . .0x20220903
FWID . . . . . .0x20220116
PLIC . . . . . .PASS
MTIMER . . . . .PASS
SWIRQ. . . . . .PASS
L2.Coherence . .Disabled
PMP. . . . . . .PASS
MMU.MPRV . . . .PASS
HW_FPU . . . . .testing
Testing FADD
Testing FMUL
Testing DCVT_D_W
Testing DCVT_D_WU
Testing DCVT_W_D
Testing DCVT_WU_D
FPU errors . . .0
instr_load_err .PASS
rd_missaccess. .PASS
wr_missaccess. .PASS
stack_ovr. . . .PASS
stack_und. . . .PASS

# Plug'n'Play info:
# AXI4: slv0: Optimizing Technologies.    AXI Interconnect
#    0000000000000000...ffffffffffffffff, size = 0 bytes
# AXI4: mst1: Optimizing Technologies.    RISC-V River x4 Workgroup
# AXI4: slv2: Optimizing Technologies.    Boot ROM
#    0000000000010000...000000000001ffff, size = 64 KB
# AXI4: slv3: Optimizing Technologies.    Internal SRAM
#    0000000008000000...00000000081fffff, size = 2 MB
# AXI4: slv4: Optimizing Technologies.    Internal SRAM
#    0000000080000000...00000000bfffffff, size = 1024 MB
# AXI4: slv5: Optimizing Technologies.    DDR Controller
#    00000000100c0000...00000000100c0fff, size = 4 KB
# AXI4: slv6: Optimizing Technologies.    PRCI
#    0000000000000000...ffffffffffffffff, size = 0 bytes
# AXI4: slv7: Optimizing Technologies.    Generic GPIO
#    0000000010060000...0000000010060fff, size = 4 KB
# AXI4: slv8: Optimizing Technologies.    CLINT
#    0000000002000000...000000000200ffff, size = 64 KB
# AXI4: slv9: Optimizing Technologies.    PLIC
#    000000000c000000...000000000fffffff, size = 64 MB
# AXI4: slv10: Optimizing Technologies.    Plug'n'Play support
#    00000000100ff000...00000000100fffff, size = 4 KB
# AXI4: slv11: Optimizing Technologies.    AXI2APB Bridge
#    0000000010000000...00000000100fffff, size = 1 MB
# AXI4: slv12: Optimizing Technologies.    Workgroup DMI
#    000000001001e000...000000001001efff, size = 4 KB
# AXI4: slv13: Optimizing Technologies.    Generic UART
#    0000000010010000...0000000010010fff, size = 4 KB
# AXI4: slv14: Optimizing Technologies.    SPI Controller
#    0000000010050000...0000000010050fff, size = 4 KB
# AXI4: slv15: Optimizing Technologies.    Unknown
#    0000000800000000...0000000fffffffff, size = 0 bytes
DDR Init . .DONE
DDR[0] . . . . .0x1122334455667788 expected 0x1122334455667788ull
DDR[1] . . . . .0xffeeddccbbaa9988 expected 0xffeeddccbbaa9988ull
DDR[9MB] . . . .0xcafef00ddead0901 expected 0xcafef00ddead0901ull
DDR. . . . . . .PASS
Copy BBL . . . .mcause:0000000000000006,mepc:0000000000018290
```
- Hardware SD controller development is in progress so you should see this exception. When I've used software to generate SPI commands for SD-card there was a chance to get the following output (after DDR test):

```
DDR Init . .DONE
DDR[0] . . . . .0x1122334455667788 expected 0x1122334455667788ull
DDR[1] . . . . .0xffeeddccbbaa9988 expected 0xffeeddccbbaa9988ull
DDR[9MB] . . . .0xcafef00ddead0901 expected 0xcafef00ddead0901ull
DDR. . . . . . .PASS
DUM: ff ff ff ff ff ff ff ff ff ff
CMD0: ff ff ff ff ff ff ff R1: 01
CMD8: ff ff ff ff ff ff ff R1: 01
CMD58: 00 00 00 00 ff ff ff R3: 01 00ff8000
CMD55: ff ff ff ff ff ff ff R1: 01
ACMD41: ff ff ff ff ff ff ff R1: 01
CMD55: ff ff ff ff ff ff ff R1: 01
ACMD41: ff ff ff ff ff ff ff R1: 01
CMD55: ff ff ff ff ff ff ff R1: 00
ACMD41: ff ff ff ff ff ff ff R1: 00
CMD58: ff ff ff ff ff ff ff R3: 00 c0ff8000 HCS=1
SPI.Init . . . .SDHC
Copy BBL . . . .10485760 B copied
bbl loader
              vvvvvvvvvvvvvvvvvvvvvvvvvvvvvvvv
                  vvvvvvvvvvvvvvvvvvvvvvvvvvvv
rrrrrrrrrrrrr       vvvvvvvvvvvvvvvvvvvvvvvvvv
rrrrrrrrrrrrrrrr      vvvvvvvvvvvvvvvvvvvvvvvv
rrrrrrrrrrrrrrrrrr    vvvvvvvvvvvvvvvvvvvvvvvv
rrrrrrrrrrrrrrrrrr    vvvvvvvvvvvvvvvvvvvvvvvv
rrrrrrrrrrrrrrrrrr    vvvvvvvvvvvvvvvvvvvvvvvv
rrrrrrrrrrrrrrrr      vvvvvvvvvvvvvvvvvvvvvv
rrrrrrrrrrrrr       vvvvvvvvvvvvvvvvvvvvvv
rr                vvvvvvvvvvvvvvvvvvvvvv
rr            vvvvvvvvvvvvvvvvvvvvvvvv      rr
rrrr      vvvvvvvvvvvvvvvvvvvvvvvvvv      rrrr
rrrrrr      vvvvvvvvvvvvvvvvvvvvvv      rrrrrr
rrrrrrrr      vvvvvvvvvvvvvvvvvv      rrrrrrrr
rrrrrrrrrr      vvvvvvvvvvvvvv      rrrrrrrrrr
rrrrrrrrrrrr      vvvvvvvvvv      rrrrrrrrrrrr
rrrrrrrrrrrrrr      vvvvvv      rrrrrrrrrrrrrr
rrrrrrrrrrrrrrrr      vv      rrrrrrrrrrrrrrrr
rrrrrrrrrrrrrrrrrr          rrrrrrrrrrrrrrrrrr
rrrrrrrrrrrrrrrrrrrr      rrrrrrrrrrrrrrrrrrrr
rrrrrrrrrrrrrrrrrrrrrr  rrrrrrrrrrrrrrrrrrrrrr

       INSTRUCTION SETS WANT TO BE FREE
 {
  #address-cells = <0x00000002>;
  #size-cells = <0x00000002>;
  compatible = "riscv-virtio";
  model = "riscv-virtio,qemu";
  flash@20000000 {
    bank-width = <0x00000004>;
    reg = <0x00000000 0x20000000 0x00000000 0x02000000 0x00000000 0x22000000 0x00000000 0x02000000>;
    compatible = "cfi-flash";
  }
  chosen {
    bootargs = <0x6561726c 0x79707269 0x6e746b3d 0x6b656570 0x20727720 0x726f6f74 0x3d2f6465 0x762f7664>;
    stdout-path = <0x2f756172 0x74403130 0x30313030>;
  }
  uart@10010000 {
    interrupts = <0x0000000a>;
    interrupt-parent = <0x00000003>;
    clock-frequency = <0x00384000>;
    reg = <0x00000000 0x10010000 0x00000000 0x00000100>;
    compatible = "sifive,uart0";
  }
  test@100000 {
    reg = <0x00000000 0x00100000 0x00000000 0x00001000>;
    compatible = "sifive,test1", "sifive,test0";
  }
  virtio_mmio@10008000 {
    interrupts = <0x00000008>;
    interrupt-parent = <0x00000003>;
    reg = <0x00000000 0x10008000 0x00000000 0x00001000>;
    compatible = "virtio,mmio";
  }
  virtio_mmio@10007000 {
    interrupts = <0x00000007>;
    interrupt-parent = <0x00000003>;
    reg = <0x00000000 0x10007000 0x00000000 0x00001000>;
    compatible = "virtio,mmio";
  }
  virtio_mmio@10006000 {
    interrupts = <0x00000006>;
    interrupt-parent = <0x00000003>;
    reg = <0x00000000 0x10006000 0x00000000 0x00001000>;
    compatible = "virtio,mmio";
  }
  virtio_mmio@10005000 {
    interrupts = <0x00000005>;
    interrupt-parent = <0x00000003>;
    reg = <0x00000000 0x10005000 0x00000000 0x00001000>;
    compatible = "virtio,mmio";
  }
  virtio_mmio@10004000 {
    interrupts = <0x00000004>;
    interrupt-parent = <0x00000003>;
    reg = <0x00000000 0x10004000 0x00000000 0x00001000>;
    compatible = "virtio,mmio";
  }
  virtio_mmio@10003000 {
    interrupts = <0x00000003>;
    interrupt-parent = <0x00000003>;
    reg = <0x00000000 0x10003000 0x00000000 0x00001000>;
    compatible = "virtio,mmio";
  }
  virtio_mmio@10002000 {
    interrupts = <0x00000002>;
    interrupt-parent = <0x00000003>;
    reg = <0x00000000 0x10002000 0x00000000 0x00001000>;
    compatible = "virtio,mmio";
  }
  virtio_mmio@10001000 {
    interrupts = <0x00000001>;
    interrupt-parent = <0x00000003>;
    reg = <0x00000000 0x10001000 0x00000000 0x00001000>;
    compatible = "virtio,mmio";
  }
  cpus {
    #address-cells = <0x00000001>;
    #size-cells = <0x00000000>;
    timebase-frequency = <0x00989680>;
    cpu-map {
      cluster0 {
        core0 {
          cpu = <0x00000001>;
        }
      }
    }
    cpu@0 {
      phandle = <0x00000001>;
      device_type = "cpu";
      reg = <0x00000000>;
      status = "okay";
      compatible = "riscv";
      riscv,isa = "rv64imafdcsu";
      mmu-type = "riscv,sv48";
      interrupt-controller {
        #interrupt-cells = <0x00000001>;
        interrupt-controller;
        compatible = "riscv,cpu-intc";
        phandle = <0x00000002>;
      }
    }
  }
  memory@80000000 {
    device_type = "memory";
    reg = <0x00000000 0x80000000 0x00000000 0x20000000>;
  }
  soc {
    #address-cells = <0x00000002>;
    #size-cells = <0x00000002>;
    compatible = "simple-bus";
    ranges;
    pci@30000000 {
      interrupt-map-mask = <0x00001800 0x00000000 0x00000000 0x00000007>;
      interrupt-map = <0x00000000 0x00000000 0x00000000 0x00000001 0x00000003 0x00000020 0x00000000 0x00000000 0x00000000 0x00000002 0x00000003 0x00000021 0x00000000 0x00000000 0x00000000 0x00000003 0x00000003 0x00000022 0x00000000 0x00000000 0x00000000 0x00000004 0x00000003 0x00000023 0x00000800 0x00000000 0x00000000 0x00000001 0x00000003 0x00000021 0x00000800 0x00000000 0x00000000 0x00000002 0x00000003 0x00000022 0x00000800 0x00000000 0x00000000 0x00000003 0x00000003 0x00000023 0x00000800 0x00000000 0x00000000 0x00000004 0x00000003 0x00000020 0x00001000 0x00000000 0x00000000 0x00000001 0x00000003 0x00000022 0x00001000 0x00000000 0x00000000 0x00000002 0x00000003 0x00000023 0x00001000 0x00000000 0x00000000 0x00000003 0x00000003 0x00000020 0x00001000 0x00000000 0x00000000 0x00000004 0x00000003 0x00000021 0x00001800 0x00000000 0x00000000 0x00000001 0x00000003 0x00000023 0x00001800 0x00000000 0x00000000 0x00000002 0x00000003 0x00000020 0x00001800 0x00000000 0x00000000 0x00000003 0x00000003 0x00000021 0x00001800 0x00000000 0x00000000 0x00000004 0x00000003 0x00000022>;
      ranges = <0x01000000 0x00000000 0x00000000 0x00000000 0x03000000 0x00000000 0x00010000 0x02000000 0x00000000 0x40000000 0x00000000 0x40000000 0x00000000 0x40000000>;
      reg = <0x00000000 0x30000000 0x00000000 0x10000000>;
      dma-coherent;
      bus-range = <0x00000000 0x000000ff>;
      linux,pci-domain = <0x00000000>;
      device_type = "pci";
      compatible = "pci-host-ecam-generic";
      #size-cells = <0x00000002>;
      #interrupt-cells = <0x00000001>;
      #address-cells = <0x00000003>;
    }
    interrupt-controller@c000000 {
      phandle = <0x00000003>;
      riscv,ndev = <0x00000035>;
      reg = <0x00000000 0x0c000000 0x00000000 0x04000000>;
      interrupts-extended = <0x00000002 0xffffffff 0x00000002 0x00000009>;
      interrupt-controller;
      compatible = "riscv,plic0";
      #interrupt-cells = <0x00000001>;
      #address-cells = <0x00000000>;
    }
  }
}
[    0.000000] OF: fdt: Ignoring memory range 0x80000000 - 0x80200000
[    0.000000] No DTB passed to the kernel
[    0.000000] Linux version 5.0.0-rc1-56210-g0a657e0d72f0 (coder@coder-comp) (gcc version 11.1.0 (g5964b5cd727)) #11 SMP Mon Aug 22 11:09:54 MSK 2022
[    0.000000] Zone ranges:
[    0.000000]   DMA32    [mem 0x0000000080200000-0x000000009fffffff]
[    0.000000]   Normal   [mem 0x00000000a0000000-0x000009ffffffffff]
[    0.000000] Movable zone start for each node
[    0.000000] Early memory node ranges
[    0.000000]   node   0: [mem 0x0000000080200000-0x000000009fffffff]
[    0.000000] Initmem setup node 0 [mem 0x0000000080200000-0x000000009fffffff]
[    0.000000] software IO TLB: mapped [mem 0x9b8fc000-0x9f8fc000] (64MB)
[    0.000000] elf_hwcap is 0x112d
[    0.000000] percpu: Embedded 14 pages/cpu @(____ptrval____) s28568 r0 d28776 u57344
[    0.000000] Built 1 zonelists, mobility grouping on.  Total pages: 128775
[    0.000000] Kernel command line: earlyprintk=keep rw root=/dev/vda
[    0.000000] Dentry cache hash table entries: 65536 (order: 7, 524288 bytes)
[    0.000000] Inode-cache hash table entries: 32768 (order: 6, 262144 bytes)
[    0.000000] Sorting __ex_table...
[    0.000000] Memory: 442248K/522240K available (3962K kernel code, 248K rwdata, 887K rodata, 155K init, 789K bss, 79992K reserved, 0K cma-reserved)
[    0.000000] SLUB: HWalign=64, Order=0-3, MinObjects=0, CPUs=1, Nodes=1
[    0.000000] rcu: Hierarchical RCU implementation.
[    0.000000] rcu: 	RCU event tracing is enabled.
[    0.000000] rcu: 	RCU restricting CPUs from NR_CPUS=8 to nr_cpu_ids=1.
[    0.000000] rcu: RCU calculated value of scheduler-enlistment delay is 10 jiffies.
[    0.000000] rcu: Adjusting geometry for rcu_fanout_leaf=16, nr_cpu_ids=1
[    0.000000] NR_IRQS: 0, nr_irqs: 0, preallocated irqs: 0
[    0.000000] plic: mapped 53 interrupts to 1 (out of 2) handlers.
[    0.000000] clocksource: riscv_clocksource: mask: 0xffffffffffffffff max_cycles: 0x24e6a1710, max_idle_ns: 440795202120 ns
[    0.000653] sched_clock: 64 bits at 10MHz, resolution 100ns, wraps every 4398046511100ns
[    0.815190] printk: console [hvc0] enabled
[    0.834363] Calibrating delay loop (skipped), value calculated using timer frequency.. 20.00 BogoMIPS (lpj=100000)
[    0.878327] pid_max: default: 32768 minimum: 301
[    0.914269] Mount-cache hash table entries: 1024 (order: 1, 8192 bytes)
[    0.939484] Mountpoint-cache hash table entries: 1024 (order: 1, 8192 bytes)
[    0.972428] Kernel panic - not syncing: Can't find rootfs type
[    0.994972] CPU: 0 PID: 0 Comm: swapper/0 Not tainted 5.0.0-rc1-56210-g0a657e0d72f0 #11
[    1.029401] Call Trace:
[    1.040786] [<ffffffe000029012>] walk_stackframe+0x0/0xa6
[    1.064140] [<ffffffe00002930c>] show_stack+0x2a/0x34
[    1.086488] [<ffffffe0003ee358>] dump_stack+0x66/0x80
[    1.108435] [<ffffffe00002cc4e>] panic+0xdc/0x21a
[    1.128936] [<ffffffe000009f98>] mnt_init+0x11e/0x1a6
[    1.150950] [<ffffffe000009c80>] vfs_caches_init+0x64/0x74
[    1.174943] [<ffffffe000000980>] start_kernel+0x2b4/0x2e4
[    1.198504] [<ffffffe000000076>] clear_bss_done+0x3a/0x3c
[    1.222219] ---[ end Kernel panic - not syncing: Can't find rootfs type ]---
```

Youssef-IA, 2023-11-19:
Got it, thanks a lot for your help!

Just one last question please,
does any of the other tests provided in examples are fully developed yet? or just bootrom_tests & helloworld?
- "riscv_tests" & "dhrystone" are running but I can not figure what is the expected output?
- "boot" is showing spi.c compilation issue related to ADDR_BUS0_XSLV_QSPI2

sergeykhbr, 2023-11-20:
I removed this QSPI controller because I hope to implement controller that can use SD-card in SD mode.

All examples were runnable some time ago but I broke it removing additional ROM block (fwimage) because of conceptual reason. Previous idea was to copy application (helloworld, riscv-tests, Drhystone or whatever) from this ROM into SRAM by bootloader and start execution from SRAM. Now it is impossible, SD-card or JTAG should be used for that.

I've committed update into boot example to skip coping procedure (ROM/SD->SRAM) so now there's possibility to initialize SRAM block and run application just after boot. It is valid for RTL simulation or FPGA to check examples but invalid for ASIC implementation.

SD-controller is the critical element right to use system in a standard way without additional hacks and workarounds and store linux rootfs or user applications.

Youssef-IA, 2023-11-20:
Thanks a lot for you help, great work!
Looking forward for SD-controller implementation.

Closed 2023-11-20.

Thread 45 (2023-05-20):

Adding a slave peripheral

Mina2411, 2023-05-20:
I want to add a new slave peripheral to Riscv, and I took SRAM as reference to know the modules and packages that I should modify, and I found that I should add:-
1) Index, start and end address in the memory address mapping in types_bus0_pkg.
2) Add a new device id in types_amba_pkg for my new peripheral.
3) Define the size of the peripheral in config_target_pkg.
4) Define the new slave peripheral in riscv_soc_pkg which I can't understand what this number given to the peripherals represent and to which module this number is used "I think this is the missing part that this number should be mapped to another module and get some information from this module, so if you can clarify what is the idea behind this number "SOC_PNP_SRAM"".
Do I need to adjust any other modules or packages?

sergeykhbr, 2023-05-20:
1. Yes. You need to create new AXI slave slot by increasing CFG_BUS0_XSLV_TOTAL value and defining allocated memory range in the CFG_BUS_MAP.
2. It is optional. Only if you would like to use plug'n'play feature (device descriptor visible in pnp module). You can use any values here including zeros. This IDs do not affect hardware.
3. It is optional. config_target_pkg.sv file should be used to specify parameters that could have different value for different targets. For an example, internal SRAM in ASIC target should have 2 MB and it uses full allocated memory space in CFG_BUS_MAP but it is too big memory for FPGA board kc705. You can hardcoded parameters of your module wherever you want.
4. It is optional the same as p.2. Only if you want that descriptor of your module was available in pnp module. You may ignore this structure and output signals of the module.

The best approach is to make step 1 and use _axi_slv_ sub-module as an AXI interface inside of your device.

Note: Most of the Verilog and SystemC files are generated by __rtlgen__ utility (see https://github.com/sergeykhbr/rtlgen). When it will be fully finished it will implement full system generator that allows to create topology of the SoC and full customization.

Mina2411, 2023-05-20:
Hello,
you mean to create a slave peripheral and fit it in the riscv soc, I need to do all the modifications in types_bus0_pkg only which is the index given to the peripheral to access the memory mapping vector depending on the size of the peripheral of course and increase CFG_BUS0_XSLV_TOTAL value. then I need to take the axi_slv as a sub module which I did already, anything else is optional which I may or may not use right?
Thanks

Mina2411, 2023-05-20:
I see also that there is no axi_master interface or it is implemented in the sv version under a different name, because I wandering how the master peripherals are connected to the AXI without an interface module, so can you clarify where is the AXI/Master interface module?

sergeykhbr, 2023-05-21:
Master interface is in the development to provide coherence interface and re-used in CPUs workgroup

Mina2411, 2023-05-21:
so you mean that there is no module for AXI_master interface explicitly, sorry,I am not able to understand what you mean .

Mina2411, 2023-05-21:
As I want to add a new master peripheral, how can I communicate with the AXI bus? That's why I am asking about an interface module like the axi_slv.

sergeykhbr, 2023-05-21:
I cannot provide simple solution right now. You have several options that should be implemented manually:

1. Connection to ACP port (before L2-cache). If you are developing DMA engine or another CPU and would like to provide coherence of caches of your device and CPUs of the workgroup then you need to reproduce state machine similar to _river_amba.sv_ file.
2. Connection to BUS0 master port (no hardware coherency). Simplified version of the _river_amba.sv_. In this case you either have two options: (a) Properly configure PMP (or MPU - memory protection unit) that allocates uncached memory regions used for inter-processor communication or (b) actively use ifence instruction and loose performance.
3. Implementation of the master interface module at the top of my todo list, so sooner or later I will commit such module.

Mina2411, 2023-05-31:
Hello again,
I mas

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

Hello again,
I made all the steps, and I defined the memory map for a slave peripheral as '{64'h0000100000000, 64'h0000100000100}, and The index for the peripheral to access the memory map, but when I test the peripheral by writing a value and trying to read it again to see if the peripheral is fitted in the processor or not, it always fails.I tried the same implementation of the sram to see if the problem is in my implementation or not, and it fails also. so Is there any other software "I mean in C header files or C files" or hardware steps that I should follow or the previous steps should let everything work?

sergeykhbr, 2023-06-01:
- Could you share the code snippet of how you are connecting your module to AXI bus?
- Are you able to run RTL simulation to check the access?

Mina2411, 2023-06-01:
[axi4_new_slave.txt](https://github.com/sergeykhbr/riscv_vhdl/files/11623343/axi4_new_slave.txt)
For the testbench, I am working on it, but as you can see I made the connection the same as the connection of the sram and any other slave module.
Thanks

sergeykhbr, 2023-06-01:
I mean at the SoC level (file riscv_soc.sv) not inside of the slave device.

Mina2411, 2023-06-01:
[riscv_soc.txt](https://github.com/sergeykhbr/riscv_vhdl/files/11623663/riscv_soc.txt)
This is riscv_soc module, you can find the new peripheral under the sram module port map.

sergeykhbr, 2023-06-01:
That looks good for me. But I think you should increase upper address. You cannot allocate less than 4 KB of memory on AXI bus (it is possible on APB - bus1).

Mina2411, 2023-06-02:
Hello,
Yes,that was the problem, it worked now.
also, I need to make my new peripheral non-cachable, so what I did that I tried to configure some CSR registers in the software program, and I did the following:-

1) configure CSR_MPU_ADDR_Register and give it the value of the base address of my new peripheral.
 __asm__("csrw 0x352, %0" : :"r"(base_address));

2) configure CSR_MPU_Mask_Register and give it the size of the peripheral.
 __asm__("csrw 0x353, %0" : :"r"(region_size));

3) configure CSR_MPU_CTRL_Register to adjust the attributes needed for the new peripheral
__asm__("csrw 0x354, %0" : :"r"(0x10011)); //enable region/uncachable region/not an executable region/read region/write region

Actually, I added these lines of code in the main function, and it didn't work, so is there something else to be done to disable cache access when I am trying to read from or write to the peripheral?

Thank you very much for your effort.

sergeykhbr, 2023-06-02:
See Physical Memory Protection (PMP) in risc-v specification. I forget to remove _map_mpu.h_ header file from examples that you are referring to. It was my own version of protection module before the specification updates and it is obsolete.

Mina2411, 2023-06-02:
You mean that I need to configure registers for PMP in the software program ?

sergeykhbr, 2023-06-02:
No, sorry. My bad. PMP setups access rights. Edit _pma.sv_ file to specify new IO (uncached) region.

Mina2411, 2023-06-02:
I saw the pma module, and I didn’t understand what I should do to specify uncached memory regions, or I need to add something to the module itself

sergeykhbr, 2023-06-02:
In pma_pkg.sv specify constants:
```
localparam bit [CFG_CPU_ADDR_BITS-1:0] YOUR_DEVICE_BAR = 48'h000100000000;
localparam bit [CFG_CPU_ADDR_BITS-1:0] YOUR_DEVICE_MASK = 48'h000000000fff;// 4 KB
```
In pma.sv add uncahced data region:
```
    end else if ((i_daddr & (~YOUR_DEVICE_MASK)) == YOU_DEVICE_BAR) begin
        v_dcached = 1'b0;
```

Mina2411, 2023-06-04:
Hello,
I tried to run the test bench of kc705_top, and I tried to monitor some internal signals that should change according to the software program that initialize the rom, but the signals are not assigned to any value for a long simulation time. does the test bench implemented to test how the program will affect the signals "such as signals on the AXI bus", or to monitor other features?
Thanks.

sergeykhbr, 2023-06-05:
I am not sure that I understood your question but asic_sim, kc705_sim and a real hardware execute absolutely the same code and should show the same output. With the enabled DDR controller kc705_sim simulation works mush slower than 'unisim' asic_sim.

CPU harts after reset wait until I/D caches finish its initialization and become available. Duration of the cache initialization depends of cache sizes.

Mina2411, 2023-06-05:
I mean that I want to test the peripheral in vivado simulator (xsim) using the software program that initialize the ROM, and I am trying to monitor some internal signals that should change depending on the software program, but the problem is that the signals aren't changing, so my asking that should the test bench of the top module simulate all the submodules, and I should see how the AXI signals are changing.

sergeykhbr, 2023-06-05:
Yes, whole system are simulating with the all peripheries.

Mina2411, 2023-07-14:
Hello sergey,
I have a problem that whenever I try to add another peripheral on bus0 in this address range '{64'h0001008000000, 64'h0001008200000}, the simulation crashes, and bitstream also doesn't work, so is there a reason for that or something I did wrong.
Thanks

Mina2411, 2023-07-14:
Hello Sergey,
I want to add another peripheral on bus0 in the memory region '{64'h0001008000000, 64'h0001008200000}, and when I tried to do so, the simulation crashes and bit stream isn't working, I think it something related to axictrl_bus0.sv module, but I don't know what is the exact problem to change it. I am also working on the old version of axictrl_bus0 not the new one that you committed recently, so if you can tell me what to change in the old version because by using the new one this will lead to many changes in the previous steps that I made.
Note:- This peripheral is of index 7, so it is number 8 on the bus.
Thanks

Mina2411, 2023-07-14:
Hello Sergey,
I was trying to add another peripheral on bus0 in the memory region '{64'h0001008000000, 64'h0001008200000}, and after this modification in bus0_pkg, the simulation crashes and bitstream doesn't work as well, so is there a reason for that or I made something wrong knowing that this peripheral of index 7, so I have 8 peripherals on bus0 "localparam int CFG_BUS0_XSLV_TOTAL = 8;"
Thanks

sergeykhbr, 2023-07-23:
You can use fence.i instruction to flush caches

Thread 48 (2024-10-23):

Should SRLW be I Type instead of R Type?

dselke, 2024-10-23:
You have a great project here Sergey. I fixed a bug in my old version of River by switching SRLW from R Type ("ADD like") to I Type ("ADDI like"), and I just want to make sure you don't have the same issue.  I was getting a bogus shift amount in the second shifter argument in simulation which caused the River sim to disagree with the same .c file built for x64 laptop. Same instruction, shift right logical word by 31. Instead of this instruction turning "all FFs" into "1", the result in the sim was "00000000000003FF" (shift by 14 instead of 31 - the instruction in both .s files showed 31.  The problem was that src2 is supposed to be immediate  (https://riscv.org/wp-content/uploads/2019/06/riscv-spec.pdf, page 37).  On line 633 and 688 of [decoder.vhd](https://github.com/sergeykhbr/riscv_vhdl/blob/master/vhdl/rtl/riverlib/core/decoder.vhd), it looks like SRLW is still R Type.  I don't know if this is still a bug for you because my code diverged from your latest some years ago.

Live long and prosper! :)

dselke, 2024-10-23:
I have a custom assembler as well as a customized river cpu so this "fix" could be a case of two wrongs making a right!

sergeykhbr, 2024-10-24:
Hi,
VHDL code is a bit obsolete. Newer SystemVerilog/SystemC version is available and it was tested with third-party riscv-tests framework.
Could you share patch/diff file?

dselke, 2024-10-25:
I was confused reading the spec.  SRLW shift amount is supposed to be rs2[4:0], which I misinterpreted as the 5 bits labeled rs2 in the "diagram" of the instructions itself. Instead it is the 5 low bits of the register whose name is in that field of the instruction.  So it should be R-Type.  I am now sure that I fixed a software bug by adding a hardware bug. SRLIW does what I was trying to make SRLW do.  False alarm! There's no need for you to maintain obsolete stuff; I will own my copy of the vhdl until I can update to the latest river. Thanks for your quick response.

dselke, 2024-10-25:
Trying to close as resolved.

Closed 2024-10-30.

Thread 49 (2025-02-14):

Help in simulating the file

jibinbabuamakkattu, 2025-02-14:
We have been trying to simulate the rivertop file. What we are doing is that, we are using force constant to assign values to each input variable.
We force constant all the required variables in the fetch stage to check if the output is available in the execute stage, but the o_valid is always 0 for which ever instruction we try.
Could you kindly help us understand what we are doing wrong?

sergeykhbr, 2025-02-15:
Sorry friend, there's not enough information. What target you are trying simulate? What is toolchain?

jibinbabuamakkattu, 2025-02-17:
Thanks for your reply. Here's some additional context:

Target & Toolchain: We're simulating the rivertop file using Xilinx Vivado 2023.2, with the intent to eventually implement it on an Artix-7 board.
Simulation Scope: We’re focusing solely on the rivertop file rather than simulating the complete repository.
Issue Encountered: In our simulation, we’re using force constant to assign values to all required input signals in the fetch stage. Despite this, the o_valid signal in the execute stage remains 0 for every instruction we test.
Could you help us understand what might be going wrong? Are there any dependencies or simulation setup issues (e.g., missing reset sequences, handshake signals, or other initialization conditions) that we might be overlooking by simulating just the top-level file with forced constants?

Any insights or suggestions would be greatly appreciated!
