sergeykhbr/riscv_vhdl/sv/prj/impl/kc705/kc705_top.xdc

create_clock -name i_sclk_p -period 5.000 [get_ports i_sclk_p]

set_property VCCAUX_IO DONTCARE [get_ports {i_sclk_p}]
set_property IOSTANDARD DIFF_SSTL15 [get_ports i_sclk_p]
set_property PACKAGE_PIN AD12 [get_ports i_sclk_p]

set_property VCCAUX_IO DONTCARE [get_ports {i_sclk_n}]
set_property IOSTANDARD DIFF_SSTL15 [get_ports i_sclk_n]
set_property PACKAGE_PIN AD11 [get_ports i_sclk_n]

# button "Center"
set_property PACKAGE_PIN G12 [get_ports i_rst]
set_property CLOCK_DEDICATED_ROUTE FALSE [get_nets i_rst]
set_property IOSTANDARD LVCMOS25 [get_ports i_rst]

# DIP switch: SW1.1
set_property PACKAGE_PIN Y29 [get_ports {io_gpio[0]}]
set_property IOSTANDARD LVCMOS25 [get_ports {io_gpio[0]}]
set_property PACKAGE_PIN W29 [get_ports {io_gpio[1]}]
set_property IOSTANDARD LVCMOS25 [get_ports {io_gpio[1]}]
set_property PACKAGE_PIN AA28 [get_ports {io_gpio[2]}]
set_property IOSTANDARD LVCMOS25 [get_ports {io_gpio[2]}]
set_property PACKAGE_PIN Y28 [get_ports {io_gpio[3]}]
set_property IOSTANDARD LVCMOS25 [get_ports {io_gpio[3]}]

# LPC :
set_property PACKAGE_PIN AG25 [get_ports {o_ddr3_init_calib_complete}]
set_property IOSTANDARD LVCMOS25 [get_ports {o_ddr3_init_calib_complete}]

# User's LEDs:
set_property PACKAGE_PIN AB8 [get_ports {io_gpio[4]}]
set_property IOSTANDARD LVCMOS15 [get_ports {io_gpio[4]}]
set_property PACKAGE_PIN AA8 [get_ports {io_gpio[5]}]
set_property IOSTANDARD LVCMOS15 [get_ports {io_gpio[5]}]
set_property PACKAGE_PIN AC9 [get_ports {io_gpio[6]}]
set_property IOSTANDARD LVCMOS15 [get_ports {io_gpio[6]}]
set_property PACKAGE_PIN AB9 [get_ports {io_gpio[7]}]
set_property IOSTANDARD LVCMOS15 [get_ports {io_gpio[7]}]
set_property PACKAGE_PIN AE26 [get_ports {io_gpio[8]}]
set_property IOSTANDARD LVCMOS25 [get_ports {io_gpio[8]}]
set_property PACKAGE_PIN G19 [get_ports {io_gpio[9]}]
set_property IOSTANDARD LVCMOS25 [get_ports {io_gpio[9]}]
set_property PACKAGE_PIN E18 [get_ports {io_gpio[10]}]
set_property IOSTANDARD LVCMOS25 [get_ports {io_gpio[10]}]
set_property PACKAGE_PIN F16 [get_ports {io_gpio[11]}]
set_property IOSTANDARD LVCMOS25 [get_ports {io_gpio[11]}]

# JTAG
set_property PACKAGE_PIN AA25 [get_ports i_jtag_tck]
set_property IOSTANDARD LVCMOS25 [get_ports i_jtag_tck]
set_property CLOCK_DEDICATED_ROUTE FALSE [get_nets i_jtag_tck]
create_clock -period 1000.000 -name i_swjtag_clktck -waveform {0.000 500.000} [get_ports i_jtag_tck]

set_property PACKAGE_PIN J23 [get_ports i_jtag_trst]
set_property IOSTANDARD LVCMOS25 [get_ports i_jtag_trst]

set_property PACKAGE_PIN AA27 [get_ports i_jtag_tms]
set_property IOSTANDARD LVCMOS25 [get_ports i_jtag_tms]

set_property PACKAGE_PIN AB25 [get_ports i_jtag_tdi]
set_property IOSTANDARD LVCMOS25 [get_ports i_jtag_tdi]

set_property PACKAGE_PIN AB28 [get_ports o_jtag_tdo]
set_property IOSTANDARD LVCMOS25 [get_ports o_jtag_tdo]

set_property IOSTANDARD LVCMOS25 [get_ports o_jtag_vref]
set_property PACKAGE_PIN W21 [get_ports o_jtag_vref]


#UART interface
set_property PACKAGE_PIN M19 [get_ports i_uart1_rd]
set_property IOSTANDARD LVCMOS25 [get_ports i_uart1_rd]
set_property PACKAGE_PIN K24 [get_ports o_uart1_td]
set_property IOSTANDARD LVCMOS25 [get_ports o_uart1_td]

#SD-card:
set_property PACKAGE_PIN AB23 [get_ports o_sd_sclk]
set_property IOSTANDARD LVCMOS25 [get_ports o_sd_sclk]

# SDIO connector CMD:
set_property PACKAGE_PIN AB22 [get_ports io_sd_cmd]
set_property IOSTANDARD LVCMOS25 [get_ports io_sd_cmd]
#set_property PULLTYPE PULLUP [get_ports io_sd_cmd]

# SDIO connector DAT0
set_property PACKAGE_PIN AC20 [get_ports io_sd_dat0]
set_property IOSTANDARD LVCMOS25 [get_ports io_sd_dat0]
#set_property PULLTYPE PULLUP [get_ports io_sd_dat0]

# SDIO connector DAT1
set_property PACKAGE_PIN AA23 [get_ports io_sd_dat1]
set_property IOSTANDARD LVCMOS25 [get_ports io_sd_dat1]
#set_property PULLTYPE PULLUP [get_ports io_sd_dat1]

# SDIO connector DAT2
set_property PACKAGE_PIN AA22 [get_ports io_sd_dat2]
set_property IOSTANDARD LVCMOS25 [get_ports io_sd_dat2]
#set_property PULLTYPE PULLUP [get_ports io_sd_dat2]

# SDIO connector CD_DAT3
set_property PACKAGE_PIN AC21 [get_ports io_sd_cd_dat3]
set_property IOSTANDARD LVCMOS25 [get_ports io_sd_cd_dat3]
#set_property PULLTYPE PULLUP [get_ports io_sd_cd_dat3]

set_property PACKAGE_PIN AA21 [get_ports i_sd_detected]
set_property IOSTANDARD LVCMOS25 [get_ports i_sd_detected]

# write protect
set_property PACKAGE_PIN Y21 [get_ports i_sd_protect]
set_property IOSTANDARD LVCMOS25 [get_ports i_sd_protect]


##################################################################################################
## Controller 0
## Memory Device: DDR3_SDRAM->SODIMMs->MT8JTF12864HZ-1G6
## Data Width: 64
## Time Period: 1250
## Data Mask: 1
##################################################################################################

create_clock -period 5 [get_ports sys_clk_i]
          # Note: CLK_REF FALSE Constraint.
# CLK_REF is a 200  MHz clock source used to drive IODELAY CTRL logic (via an
# additional MMCM). This clock need not utilized CLOCK_DEDICADE_ROUTE (as they
# are limited in number), hence the FALSE value set.
# Please refer to UG 586 for details on clocking resources.
set_property CLOCK_DEDICATED_ROUTE FALSE [get_pins -hierarchical *clk_ref_mmcm_gen.mmcm_i*CLKIN1]
          

############## NET - IOSTANDARD ##################


# PadFunction: IO_L20P_T3_32 
set_property VCCAUX_IO HIGH [get_ports {io_ddr3_dq[0]}]
set_property SLEW FAST [get_ports {io_ddr3_dq[0]}]
set_property IOSTANDARD SSTL15_T_DCI [get_ports {io_ddr3_dq[0]}]
set_property PACKAGE_PIN AA15 [get_ports {io_ddr3_dq[0]}]

# PadFunction: IO_L23N_T3_32 
set_property VCCAUX_IO HIGH [get_ports {io_ddr3_dq[1]}]
set_property SLEW FAST [get_ports {io_ddr3_dq[1]}]
set_property IOSTANDARD SSTL15_T_DCI [get_ports {io_ddr3_dq[1]}]
set_property PACKAGE_PIN AA16 [get_ports {io_ddr3_dq[1]}]

# PadFunction: IO_L22P_T3_32 
set_property VCCAUX_IO HIGH [get_ports {io_ddr3_dq[2]}]
set_property SLEW FAST [get_ports {io_ddr3_dq[2]}]
set_property IOSTANDARD SSTL15_T_DCI [get_ports {io_ddr3_dq[2]}]
set_property PACKAGE_PIN AC14 [get_ports {io_ddr3_dq[2]}]

# PadFunction: IO_L22N_T3_32 
set_property VCCAUX_IO HIGH [get_ports {io_ddr3_dq[3]}]
set_property SLEW FAST [get_ports {io_ddr3_dq[3]}]
set_property IOSTANDARD SSTL15_T_DCI [get_ports {io_ddr3_dq[3]}]
set_property PACKAGE_PIN AD14 [get_ports {io_ddr3_dq[3]}]

# PadFunction: IO_L23P_T3_32 
set_property VCCAUX_IO HIGH [get_ports {io_ddr3_dq[4]}]
set_property SLEW FAST [get_ports {io_ddr3_dq[4]}]
set_property IOSTANDARD SSTL15_T_DCI [get_ports {io_ddr3_dq[4]}]
set_property PACKAGE_PIN AA17 [get_ports {io_ddr3_dq[4]}]

# PadFunction: IO_L20N_T3_32 
set_property VCCAUX_IO HIGH [get_ports {io_ddr3_dq[5]}]
set_property SLEW FAST [get_ports {io_ddr3_dq[5]}]
set_property IOSTANDARD SSTL15_T_DCI [get_ports {io_ddr3_dq[5]}]
set_property PACKAGE_PIN AB15 [get_ports {io_ddr3_dq[5]}]

# PadFunction: IO_L19P_T3_32 
set_property VCCAUX_IO HIGH [get_ports {io_ddr3_dq[6]}]
set_property SLEW FAST [get_ports {io_ddr3_dq[6]}]
set_property IOSTANDARD SSTL15_T_DCI [get_ports {io_ddr3_dq[6]}]
set_property PACKAGE_PIN AE15 [get_ports {io_ddr3_dq[6]}]

# PadFunction: IO_L24N_T3_32 
set_property VCCAUX_IO HIGH [get_ports {io_ddr3_dq[7]}]
set_property SLEW FAST [get_ports {io_ddr3_dq[7]}]
set_property IOSTANDARD SSTL15_T_DCI [get_ports {io_ddr3_dq[7]}]
set_property PACKAGE_PIN Y15 [get_ports {io_ddr3_dq[7]}]

# PadFunction: IO_L17P_T2_32 
set_property VCCAUX_IO HIGH [get_ports {io_ddr3_dq[8]}]
set_property SLEW FAST [get_ports {io_ddr3_dq[8]}]
set_property IOSTANDARD SSTL15_T_DCI [get_ports {io_ddr3_dq[8]}]
set_property PACKAGE_PIN AB19 [get_ports {io_ddr3_dq[8]}]

# PadFunction: IO_L14N_T2_SRCC_32 
set_property VCCAUX_IO HIGH [get_ports {io_ddr3_dq[9]}]
set_property SLEW FAST [get_ports {io_ddr3_dq[9]}]
set_property IOSTANDARD SSTL15_T_DCI [get_ports {io_ddr3_dq[9]}]
set_property PACKAGE_PIN AD16 [get_ports {io_ddr3_dq[9]}]

# PadFunction: IO_L17N_T2_32 
set_property VCCAUX_IO HIGH [get_ports {io_ddr3_dq[10]}]
set_property SLEW FAST [get_ports {io_ddr3_dq[10]}]
set_property IOSTANDARD SSTL15_T_DCI [get_ports {io_ddr3_dq[10]}]
set_property PACKAGE_PIN AC19 [get_ports {io_ddr3_dq[10]}]

# PadFunction: IO_L14P_T2_SRCC_32 
set_property VCCAUX_IO HIGH [get_ports {io_ddr3_dq[11]}]
set_property SLEW FAST [get_ports {io_ddr3_dq[11]}]
set_property IOSTANDARD SSTL15_T_DCI [get_ports {io_ddr3_dq[11]}]
set_property PACKAGE_PIN AD17 [get_ports {io_ddr3_dq[11]}]

# PadFunction: IO_L16P_T2_32 
set_property VCCAUX_IO HIGH [get_ports {io_ddr3_dq[12]}]
set_property SLEW FAST [get_ports {io_ddr3_dq[12]}]
set_property IOSTANDARD SSTL15_T_DCI [get_ports {io_ddr3_dq[12]}]
set_property PACKAGE_PIN AA18 [get_ports {io_ddr3_dq[12]}]

# PadFunction: IO_L16N_T2_32 
set_property VCCAUX_IO HIGH [get_ports {io_ddr3_dq[13]}]
set_property SLEW FAST [get_ports {io_ddr3_dq[13]}]
set_property IOSTANDARD SSTL15_T_DCI [get_ports {io_ddr3_dq[13]}]
set_property PACKAGE_PIN AB18 [get_ports {io_ddr3_dq[13]}]

# PadFunction: IO_L13N_T2_MRCC_32 
set_property VCCAUX_IO HIGH [get_ports {io_ddr3_dq[14]}]
set_property SLEW FAST [get_ports {io_ddr3_dq[14]}]
set_property IOSTANDARD SSTL15_T_DCI [get_ports {io_ddr3_dq[14]}]
set_property PACKAGE_PIN AE18 [get_ports {io_ddr3_dq[14]}]

# PadFunction: IO_L13P_T2_MRCC_32 
set_property VCCAUX_IO HIGH [get_ports {io_ddr3_dq[15]}]
set_property SLEW FAST [get_ports {io_ddr3_dq[15]}]
set_property IOSTANDARD SSTL15_T_DCI [get_ports {io_ddr3_dq[15]}]
set_property PACKAGE_PIN AD18 [get_ports {io_ddr3_dq[15]}]

# PadFunction: IO_L8P_T1_32 
set_property VCCAUX_IO HIGH [get_ports {io_ddr3_dq[16]}]
set_property SLEW FAST [get_ports {io_ddr3_dq[16]}]
set_property IOSTANDARD SSTL15_T_DCI [get_ports {io_ddr3_dq[16]}]
set_property PACKAGE_PIN AG19 [get_ports {io_ddr3_dq[16]}]

# PadFunction: IO_L7N_T1_32 
set_property VCCAUX_IO HIGH [get_ports {io_ddr3_dq[17]}]
set_property SLEW FAST [get_ports {io_ddr3_dq[17]}]
set_property IOSTANDARD SSTL15_T_DCI [get_ports {io_ddr3_dq[17]}]
set_property PACKAGE_PIN AK19 [get_ports {io_ddr3_dq[17]}]

# PadFunction: IO_L11N_T1_SRCC_32 
set_property VCCAUX_IO HIGH [get_ports {io_ddr3_dq[18]}]
set_property SLEW FAST [get_ports {io_ddr3_dq[18]}]
set_property IOSTANDARD SSTL15_T_DCI [get_ports {io_ddr3_dq[18]}]
set_property PACKAGE_PIN AG18 [get_ports {io_ddr3_dq[18]}]

# PadFunction: IO_L11P_T1_SRCC_32 
set_property VCCAUX_IO HIGH [get_ports {io_ddr3_dq[19]}]
set_property SLEW FAST [get_ports {io_ddr3_dq[19]}]
set_property IOSTANDARD SSTL15_T_DCI [get_ports {io_ddr3_dq[19]}]
set_property PACKAGE_PIN AF18 [get_ports {io_ddr3_dq[19]}]

# PadFunction: IO_L8N_T1_32 
set_property VCCAUX_IO HIGH [get_ports {io_ddr3_dq[20]}]
set_property SLEW FAST [get_ports {io_ddr3_dq[20]}]
set_property IOSTANDARD SSTL15_T_DCI [get_ports {io_ddr3_dq[20]}]
set_property PACKAGE_PIN AH19 [get_ports {io_ddr3_dq[20]}]

# PadFunction: IO_L7P_T1_32 
set_property VCCAUX_IO HIGH [get_ports {io_ddr3_dq[21]}]
set_property SLEW FAST [get_ports {io_ddr3_dq[21]}]
set_property IOSTANDARD SSTL15_T_DCI [get_ports {io_ddr3_dq[21]}]
set_property PACKAGE_PIN AJ19 [get_ports {io_ddr3_dq[21]}]

# PadFunction: IO_L10N_T1_32 
set_property VCCAUX_IO HIGH [get_ports {io_ddr3_dq[22]}]
set_property SLEW FAST [get_ports {io_ddr3_dq[22]}]
set_property IOSTANDARD SSTL15_T_DCI [get_ports {io_ddr3_dq[22]}]
set_property PACKAGE_PIN AE19 [get_ports {io_ddr3_dq[22]}]

# PadFunction: IO_L10P_T1_32 
set_property VCCAUX_IO HIGH [get_ports {io_ddr3_dq[23]}]
set_property SLEW FAST [get_ports {io_ddr3_dq[23]}]
set_property IOSTANDARD SSTL15_T_DCI [get_ports {io_ddr3_dq[23]}]
set_property PACKAGE_PIN AD19 [get_ports {io_ddr3_dq[23]}]

# PadFunction: IO_L1P_T0_32 
set_property VCCAUX_IO HIGH [get_ports {io_ddr3_dq[24]}]
set_property SLEW FAST [get_ports {io_ddr3_dq[24]}]
set_property IOSTANDARD SSTL15_T_DCI [get_ports {io_ddr3_dq[24]}]
set_property PACKAGE_PIN AK16 [get_ports {io_ddr3_dq[24]}]

# PadFunction: IO_L5N_T0_32 
set_property VCCAUX_IO HIGH [get_ports {io_ddr3_dq[25]}]
set_property SLEW FAST [get_ports {io_ddr3_dq[25]}]
set_property IOSTANDARD SSTL15_T_DCI [get_ports {io_ddr3_dq[25]}]
set_property PACKAGE_PIN AJ17 [get_ports {io_ddr3_dq[25]}]

# PadFunction: IO_L2P_T0_32 
set_property VCCAUX_IO HIGH [get_ports {io_ddr3_dq[26]}]
set_property SLEW FAST [get_ports {io_ddr3_dq[26]}]
set_property IOSTANDARD SSTL15_T_DCI [get_ports {io_ddr3_dq[26]}]
set_property PACKAGE_PIN AG15 [get_ports {io_ddr3_dq[26]}]

# PadFunction: IO_L4P_T0_32 
set_property VCCAUX_IO HIGH [get_ports {io_ddr3_dq[27]}]
set_property SLEW FAST [get_ports {io_ddr3_dq[27]}]
set_property IOSTANDARD SSTL15_T_DCI [get_ports {io_ddr3_dq[27]}]
set_property PACKAGE_PIN AF15 [get_ports {io_ddr3_dq[27]}]

# PadFunction: IO_L5P_T0_32 
set_property VCCAUX_IO HIGH [get_ports {io_ddr3_dq[28]}]
set_property SLEW FAST [get_ports {io_ddr3_dq[28]}]
set_property IOSTANDARD SSTL15_T_DCI [get_ports {io_ddr3_dq[28]}]
set_property PACKAGE_PIN AH17 [get_ports {io_ddr3_dq[28]}]

# PadFunction: IO_L4N_T0_32 
set_property VCCAUX_IO HIGH [get_ports {io_ddr3_dq[29]}]
set_property SLEW FAST [get_ports {io_ddr3_dq[29]}]
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

# PadFunction: IO_L15N_T2_DQS_33 
set_property VCCAUX_IO HIGH [get_ports {o_ddr3_ba[2]}]
set_property SLEW FAST [get_ports {o_ddr3_ba[2]}]
set_property IOSTANDARD SSTL15 [get_ports {o_ddr3_ba[2]}]
set_property PACKAGE_PIN AK9 [get_ports {o_ddr3_ba[2]}]

# PadFunction: IO_L16P_T2_33 
set_property VCCAUX_IO HIGH [get_ports {o_ddr3_ba[1]}]
set_property SLEW FAST [get_ports {o_ddr3_ba[1]}]
set_property IOSTANDARD SSTL15 [get_ports {o_ddr3_ba[1]}]
set_property PACKAGE_PIN AG9 [get_ports {o_ddr3_ba[1]}]

# PadFunction: IO_L16N_T2_33 
set_property VCCAUX_IO HIGH [get_ports {o_ddr3_ba[0]}]
set_property SLEW FAST [get_ports {o_ddr3_ba[0]}]
set_property IOSTANDARD SSTL15 [get_ports {o_ddr3_ba[0]}]
set_property PACKAGE_PIN AH9 [get_ports {o_ddr3_ba[0]}]

# PadFunction: IO_L10P_T1_33 
set_property VCCAUX_IO HIGH [get_ports {o_ddr3_ras_n}]
set_property SLEW FAST [get_ports {o_ddr3_ras_n}]
set_property IOSTANDARD SSTL15 [get_ports {o_ddr3_ras_n}]
set_property PACKAGE_PIN AD9 [get_ports {o_ddr3_ras_n}]

# PadFunction: IO_L9N_T1_DQS_33 
set_property VCCAUX_IO HIGH [get_ports {o_ddr3_cas_n}]
set_property SLEW FAST [get_ports {o_ddr3_cas_n}]
set_property IOSTANDARD SSTL15 [get_ports {o_ddr3_cas_n}]
set_property PACKAGE_PIN AC11 [get_ports {o_ddr3_cas_n}]

# PadFunction: IO_L10N_T1_33 
set_property VCCAUX_IO HIGH [get_ports {o_ddr3_we_n}]
set_property SLEW FAST [get_ports {o_ddr3_we_n}]
set_property IOSTANDARD SSTL15 [get_ports {o_ddr3_we_n}]
set_property PACKAGE_PIN AE9 [get_ports {o_ddr3_we_n}]

# PadFunction: IO_L18N_T2_34 
set_property VCCAUX_IO HIGH [get_ports {o_ddr3_reset_n}]
set_property SLEW FAST [get_ports {o_ddr3_reset_n}]
set_property IOSTANDARD LVCMOS15 [get_ports {o_ddr3_reset_n}]
set_property PACKAGE_PIN AK3 [get_ports {o_ddr3_reset_n}]

# PadFunction: IO_L14N_T2_SRCC_33 
set_property VCCAUX_IO HIGH [get_ports {o_ddr3_cke[0]}]
set_property SLEW FAST [get_ports {o_ddr3_cke[0]}]
set_property IOSTANDARD SSTL15 [get_ports {o_ddr3_cke[0]}]
set_property PACKAGE_PIN AF10 [get_ports {o_ddr3_cke[0]}]

# PadFunction: IO_L8P_T1_33 
set_property VCCAUX_IO HIGH [get_ports {o_ddr3_odt[0]}]
set_property SLEW FAST [get_ports {o_ddr3_odt[0]}]
set_property IOSTANDARD SSTL15 [get_ports {o_ddr3_odt[0]}]
set_property PACKAGE_PIN AD8 [get_ports {o_ddr3_odt[0]}]

# PadFunction: IO_L9P_T1_DQS_33 
set_property VCCAUX_IO HIGH [get_ports {o_ddr3_cs_n[0]}]
set_property SLEW FAST [get_ports {o_ddr3_cs_n[0]}]
set_property IOSTANDARD SSTL15 [get_ports {o_ddr3_cs_n[0]}]
set_property PACKAGE_PIN AC12 [get_ports {o_ddr3_cs_n[0]}]

# PadFunction: IO_L24P_T3_32 
set_property VCCAUX_IO HIGH [get_ports {o_ddr3_dm[0]}]
set_property SLEW FAST [get_ports {o_ddr3_dm[0]}]
set_property IOSTANDARD SSTL15 [get_ports {o_ddr3_dm[0]}]
set_property PACKAGE_PIN Y16 [get_ports {o_ddr3_dm[0]}]

# PadFunction: IO_L18P_T2_32 
set_property VCCAUX_IO HIGH [get_ports {o_ddr3_dm[1]}]
set_property SLEW FAST [get_ports {o_ddr3_dm[1]}]
set_property IOSTANDARD SSTL15 [get_ports {o_ddr3_dm[1]}]
set_property PACKAGE_PIN AB17 [get_ports {o_ddr3_dm[1]}]

# PadFunction: IO_L12P_T1_MRCC_32 
set_property VCCAUX_IO HIGH [get_ports {o_ddr3_dm[2]}]
set_property SLEW FAST [get_ports {o_ddr3_dm[2]}]
set_property IOSTANDARD SSTL15 [get_ports {o_ddr3_dm[2]}]
set_property PACKAGE_PIN AF17 [get_ports {o_ddr3_dm[2]}]

# PadFunction: IO_L6P_T0_32 
set_property VCCAUX_IO HIGH [get_ports {o_ddr3_dm[3]}]
set_property SLEW FAST [get_ports {o_ddr3_dm[3]}]
set_property IOSTANDARD SSTL15 [get_ports {o_ddr3_dm[3]}]
set_property PACKAGE_PIN AE16 [get_ports {o_ddr3_dm[3]}]

# PadFunction: IO_L24P_T3_34 
set_property VCCAUX_IO HIGH [get_ports {o_ddr3_dm[4]}]
set_property SLEW FAST [get_ports {o_ddr3_dm[4]}]
set_property IOSTANDARD SSTL15 [get_ports {o_ddr3_dm[4]}]
set_property PACKAGE_PIN AK5 [get_ports {o_ddr3_dm[4]}]

# PadFunction: IO_L18P_T2_34 
set_property VCCAUX_IO HIGH [get_ports {o_ddr3_dm[5]}]
set_property SLEW FAST [get_ports {o_ddr3_dm[5]}]
set_property IOSTANDARD SSTL15 [get_ports {o_ddr3_dm[5]}]
set_property PACKAGE_PIN AJ3 [get_ports {o_ddr3_dm[5]}]

# PadFunction: IO_L12P_T1_MRCC_34 
set_property VCCAUX_IO HIGH [get_ports {o_ddr3_dm[6]}]
set_property SLEW FAST [get_ports {o_ddr3_dm[6]}]
set_property IOSTANDARD SSTL15 [get_ports {o_ddr3_dm[6]}]
set_property PACKAGE_PIN AF6 [get_ports {o_ddr3_dm[6]}]

# PadFunction: IO_L6P_T0_34 
set_property VCCAUX_IO HIGH [get_ports {o_ddr3_dm[7]}]
set_property SLEW FAST [get_ports {o_ddr3_dm[7]}]
set_property IOSTANDARD SSTL15 [get_ports {o_ddr3_dm[7]}]
set_property PACKAGE_PIN AC7 [get_ports {o_ddr3_dm[7]}]

# PadFunction: IO_L21P_T3_DQS_32 
set_property VCCAUX_IO HIGH [get_ports {io_ddr3_dqs_p[0]}]
set_property SLEW FAST [get_ports {io_ddr3_dqs_p[0]}]
set_property IOSTANDARD DIFF_SSTL15_T_DCI [get_ports {io_ddr3_dqs_p[0]}]
set_property PACKAGE_PIN AC16 [get_ports {io_ddr3_dqs_p[0]}]

# PadFunction: IO_L21N_T3_DQS_32 
set_property VCCAUX_IO HIGH [get_ports {io_ddr3_dqs_n[0]}]
set_property SLEW FAST [get_ports {io_ddr3_dqs_n[0]}]
set_property IOSTANDARD DIFF_SSTL15_T_DCI [get_ports {io_ddr3_dqs_n[0]}]
set_property PACKAGE_PIN AC15 [get_ports {io_ddr3_dqs_n[0]}]

# PadFunction: IO_L15P_T2_DQS_32 
set_property VCCAUX_IO HIGH [get_ports {io_ddr3_dqs_p[1]}]
set_property SLEW FAST [get_ports {io_ddr3_dqs_p[1]}]
set_property IOSTANDARD DIFF_SSTL15_T_DCI [get_ports {io_ddr3_dqs_p[1]}]
set_property PACKAGE_PIN Y19 [get_ports {io_ddr3_dqs_p[1]}]

# PadFunction: IO_L15N_T2_DQS_32 
set_property VCCAUX_IO HIGH [get_ports {io_ddr3_dqs_n[1]}]
set_property SLEW FAST [get_ports {io_ddr3_dqs_n[1]}]
set_property IOSTANDARD DIFF_SSTL15_T_DCI [get_ports {io_ddr3_dqs_n[1]}]
set_property PACKAGE_PIN Y18 [get_ports {io_ddr3_dqs_n[1]}]

# PadFunction: IO_L9P_T1_DQS_32 
set_property VCCAUX_IO HIGH [get_ports {io_ddr3_dqs_p[2]}]
set_property SLEW FAST [get_ports {io_ddr3_dqs_p[2]}]
set_property IOSTANDARD DIFF_SSTL15_T_DCI [get_ports {io_ddr3_dqs_p[2]}]
set_property PACKAGE_PIN AJ18 [get_ports {io_ddr3_dqs_p[2]}]

# PadFunction: IO_L9N_T1_DQS_32 
set_property VCCAUX_IO HIGH [get_ports {io_ddr3_dqs_n[2]}]
set_property SLEW FAST [get_ports {io_ddr3_dqs_n[2]}]
set_property IOSTANDARD DIFF_SSTL15_T_DCI [get_ports {io_ddr3_dqs_n[2]}]
set_property PACKAGE_PIN AK18 [get_ports {io_ddr3_dqs_n[2]}]

# PadFunction: IO_L3P_T0_DQS_32 
set_property VCCAUX_IO HIGH [get_ports {io_ddr3_dqs_p[3]}]
set_property SLEW FAST [get_ports {io_ddr3_dqs_p[3]}]
set_property IOSTANDARD DIFF_SSTL15_T_DCI [get_ports {io_ddr3_dqs_p[3]}]
set_property PACKAGE_PIN AH16 [get_ports {io_ddr3_dqs_p[3]}]

# PadFunction: IO_L3N_T0_DQS_32 
set_property VCCAUX_IO HIGH [get_ports {io_ddr3_dqs_n[3]}]
set_property SLEW FAST [get_ports {io_ddr3_dqs_n[3]}]
set_property IOSTANDARD DIFF_SSTL15_T_DCI [get_ports {io_ddr3_dqs_n[3]}]
set_property PACKAGE_PIN AJ16 [get_ports {io_ddr3_dqs_n[3]}]

# PadFunction: IO_L21P_T3_DQS_34 
set_property VCCAUX_IO HIGH [get_ports {io_ddr3_dqs_p[4]}]
set_property SLEW FAST [get_ports {io_ddr3_dqs_p[4]}]
set_property IOSTANDARD DIFF_SSTL15_T_DCI [get_ports {io_ddr3_dqs_p[4]}]
set_property PACKAGE_PIN AH7 [get_ports {io_ddr3_dqs_p[4]}]

# PadFunction: IO_L21N_T3_DQS_34 
set_property VCCAUX_IO HIGH [get_ports {io_ddr3_dqs_n[4]}]
set_property SLEW FAST [get_ports {io_ddr3_dqs_n[4]}]
set_property IOSTANDARD DIFF_SSTL15_T_DCI [get_ports {io_ddr3_dqs_n[4]}]
set_property PACKAGE_PIN AJ7 [get_ports {io_ddr3_dqs_n[4]}]

# PadFunction: IO_L15P_T2_DQS_34 
set_property VCCAUX_IO HIGH [get_ports {io_ddr3_dqs_p[5]}]
set_property SLEW FAST [get_ports {io_ddr3_dqs_p[5]}]
set_property IOSTANDARD DIFF_SSTL15_T_DCI [get_ports {io_ddr3_dqs_p[5]}]
set_property PACKAGE_PIN AG2 [get_ports {io_ddr3_dqs_p[5]}]

# PadFunction: IO_L15N_T2_DQS_34 
set_property VCCAUX_IO HIGH [get_ports {io_ddr3_dqs_n[5]}]
set_property SLEW FAST [get_ports {io_ddr3_dqs_n[5]}]
set_property IOSTANDARD DIFF_SSTL15_T_DCI [get_ports {io_ddr3_dqs_n[5]}]
set_property PACKAGE_PIN AH1 [get_ports {io_ddr3_dqs_n[5]}]

# PadFunction: IO_L9P_T1_DQS_34 
set_property VCCAUX_IO HIGH [get_ports {io_ddr3_dqs_p[6]}]
set_property SLEW FAST [get_ports {io_ddr3_dqs_p[6]}]
set_property IOSTANDARD DIFF_SSTL15_T_DCI [get_ports {io_ddr3_dqs_p[6]}]
set_property PACKAGE_PIN AG4 [get_ports {io_ddr3_dqs_p[6]}]

# PadFunction: IO_L9N_T1_DQS_34 
set_property VCCAUX_IO HIGH [get_ports {io_ddr3_dqs_n[6]}]
set_property SLEW FAST [get_ports {io_ddr3_dqs_n[6]}]
set_property IOSTANDARD DIFF_SSTL15_T_DCI [get_ports {io_ddr3_dqs_n[6]}]
set_property PACKAGE_PIN AG3 [get_ports {io_ddr3_dqs_n[6]}]

# PadFunction: IO_L3P_T0_DQS_34 
set_property VCCAUX_IO HIGH [get_ports {io_ddr3_dqs_p[7]}]
set_property SLEW FAST [get_ports {io_ddr3_dqs_p[7]}]
set_property IOSTANDARD DIFF_SSTL15_T_DCI [get_ports {io_ddr3_dqs_p[7]}]
set_property PACKAGE_PIN AD2 [get_ports {io_ddr3_dqs_p[7]}]

# PadFunction: IO_L3N_T0_DQS_34 
set_property VCCAUX_IO HIGH [get_ports {io_ddr3_dqs_n[7]}]
set_property SLEW FAST [get_ports {io_ddr3_dqs_n[7]}]
set_property IOSTANDARD DIFF_SSTL15_T_DCI [get_ports {io_ddr3_dqs_n[7]}]
set_property PACKAGE_PIN AD1 [get_ports {io_ddr3_dqs_n[7]}]

# PadFunction: IO_L13P_T2_MRCC_33 
set_property VCCAUX_IO HIGH [get_ports {o_ddr3_ck_p[0]}]
set_property SLEW FAST [get_ports {o_ddr3_ck_p[0]}]
set_property IOSTANDARD DIFF_SSTL15 [get_ports {o_ddr3_ck_p[0]}]
set_property PACKAGE_PIN AG10 [get_ports {o_ddr3_ck_p[0]}]

# PadFunction: IO_L13N_T2_MRCC_33 
set_property VCCAUX_IO HIGH [get_ports {o_ddr3_ck_n[0]}]
set_property SLEW FAST [get_ports {o_ddr3_ck_n[0]}]
set_property IOSTANDARD DIFF_SSTL15 [get_ports {o_ddr3_ck_n[0]}]
set_property PACKAGE_PIN AH10 [get_ports {o_ddr3_ck_n[0]}]




set_property LOC PHASER_OUT_PHY_X1Y3 [get_cells  -hier -filter {NAME =~ */ddr_phy_4lanes_2.u_ddr_phy_4lanes/ddr_byte_lane_D.ddr_byte_lane_D/phaser_out}]
set_property LOC PHASER_OUT_PHY_X1Y2 [get_cells  -hier -filter {NAME =~ */ddr_phy_4lanes_2.u_ddr_phy_4lanes/ddr_byte_lane_C.ddr_byte_lane_C/phaser_out}]
set_property LOC PHASER_OUT_PHY_X1Y1 [get_cells  -hier -filter {NAME =~ */ddr_phy_4lanes_2.u_ddr_phy_4lanes/ddr_byte_lane_B.ddr_byte_lane_B/phaser_out}]
set_property LOC PHASER_OUT_PHY_X1Y0 [get_cells  -hier -filter {NAME =~ */ddr_phy_4lanes_2.u_ddr_phy_4lanes/ddr_byte_lane_A.ddr_byte_lane_A/phaser_out}]
set_property LOC PHASER_OUT_PHY_X1Y6 [get_cells  -hier -filter {NAME =~ */ddr_phy_4lanes_1.u_ddr_phy_4lanes/ddr_byte_lane_C.ddr_byte_lane_C/phaser_out}]
set_property LOC PHASER_OUT_PHY_X1Y5 [get_cells  -hier -filter {NAME =~ */ddr_phy_4lanes_1.u_ddr_phy_4lanes/ddr_byte_lane_B.ddr_byte_lane_B/phaser_out}]
set_property LOC PHASER_OUT_PHY_X1Y4 [get_cells  -hier -filter {NAME =~ */ddr_phy_4lanes_1.u_ddr_phy_4lanes/ddr_byte_lane_A.ddr_byte_lane_A/phaser_out}]
set_property LOC PHASER_OUT_PHY_X1Y11 [get_cells  -hier -filter {NAME =~ */ddr_phy_4lanes_0.u_ddr_phy_4lanes/ddr_byte_lane_D.ddr_byte_lane_D/phaser_out}]
set_property LOC PHASER_OUT_PHY_X1Y10 [get_cells  -hier -filter {NAME =~ */ddr_phy_4lanes_0.u_ddr_phy_4lanes/ddr_byte_lane_C.ddr_byte_lane_C/phaser_out}]
set_property LOC PHASER_OUT_PHY_X1Y9 [get_cells  -hier -filter {NAME =~ */ddr_phy_4lanes_0.u_ddr_phy_4lanes/ddr_byte_lane_B.ddr_byte_lane_B/phaser_out}]
set_property LOC PHASER_OUT_PHY_X1Y8 [get_cells  -hier -filter {NAME =~ */ddr_phy_4lanes_0.u_ddr_phy_4lanes/ddr_byte_lane_A.ddr_byte_lane_A/phaser_out}]


set_property LOC PHASER_IN_PHY_X1Y3 [get_cells  -hier -filter {NAME =~ */ddr_phy_4lanes_2.u_ddr_phy_4lanes/ddr_byte_lane_D.ddr_byte_lane_D/phaser_in_gen.phaser_in}]
set_property LOC PHASER_IN_PHY_X1Y2 [get_cells  -hier -filter {NAME =~ */ddr_phy_4lanes_2.u_ddr_phy_4lanes/ddr_byte_lane_C.ddr_byte_lane_C/phaser_in_gen.phaser_in}]
set_property LOC PHASER_IN_PHY_X1Y1 [get_cells  -hier -filter {NAME =~ */ddr_phy_4lanes_2.u_ddr_phy_4lanes/ddr_byte_lane_B.ddr_byte_lane_B/phaser_in_gen.phaser_in}]
set_property LOC PHASER_IN_PHY_X1Y0 [get_cells  -hier -filter {NAME =~ */ddr_phy_4lanes_2.u_ddr_phy_4lanes/ddr_byte_lane_A.ddr_byte_lane_A/phaser_in_gen.phaser_in}]
## set_property LOC PHASER_IN_PHY_X1Y6 [get_cells  -hier -filter {NAME =~ */ddr_phy_4lanes_1.u_ddr_phy_4lanes/ddr_byte_lane_C.ddr_byte_lane_C/phaser_in_gen.phaser_in}]
## set_property LOC PHASER_IN_PHY_X1Y5 [get_cells  -hier -filter {NAME =~ */ddr_phy_4lanes_1.u_ddr_phy_4lanes/ddr_byte_lane_B.ddr_byte_lane_B/phaser_in_gen.phaser_in}]
## set_property LOC PHASER_IN_PHY_X1Y4 [get_cells  -hier -filter {NAME =~ */ddr_phy_4lanes_1.u_ddr_phy_4lanes/ddr_byte_lane_A.ddr_byte_lane_A/phaser_in_gen.phaser_in}]
set_property LOC PHASER_IN_PHY_X1Y11 [get_cells  -hier -filter {NAME =~ */ddr_phy_4lanes_0.u_ddr_phy_4lanes/ddr_byte_lane_D.ddr_byte_lane_D/phaser_in_gen.phaser_in}]
set_property LOC PHASER_IN_PHY_X1Y10 [get_cells  -hier -filter {NAME =~ */ddr_phy_4lanes_0.u_ddr_phy_4lanes/ddr_byte_lane_C.ddr_byte_lane_C/phaser_in_gen.phaser_in}]
set_property LOC PHASER_IN_PHY_X1Y9 [get_cells  -hier -filter {NAME =~ */ddr_phy_4lanes_0.u_ddr_phy_4lanes/ddr_byte_lane_B.ddr_byte_lane_B/phaser_in_gen.phaser_in}]
set_property LOC PHASER_IN_PHY_X1Y8 [get_cells  -hier -filter {NAME =~ */ddr_phy_4lanes_0.u_ddr_phy_4lanes/ddr_byte_lane_A.ddr_byte_lane_A/phaser_in_gen.phaser_in}]





set_property LOC OUT_FIFO_X1Y3 [get_cells  -hier -filter {NAME =~ */ddr_phy_4lanes_2.u_ddr_phy_4lanes/ddr_byte_lane_D.ddr_byte_lane_D/out_fifo}]
set_property LOC OUT_FIFO_X1Y2 [get_cells  -hier -filter {NAME =~ */ddr_phy_4lanes_2.u_ddr_phy_4lanes/ddr_byte_lane_C.ddr_byte_lane_C/out_fifo}]
set_property LOC OUT_FIFO_X1Y1 [get_cells  -hier -filter {NAME =~ */ddr_phy_4lanes_2.u_ddr_phy_4lanes/ddr_byte_lane_B.ddr_byte_lane_B/out_fifo}]
set_property LOC OUT_FIFO_X1Y0 [get_cells  -hier -filter {NAME =~ */ddr_phy_4lanes_2.u_ddr_phy_4lanes/ddr_byte_lane_A.ddr_byte_lane_A/out_fifo}]
set_property LOC OUT_FIFO_X1Y6 [get_cells  -hier -filter {NAME =~ */ddr_phy_4lanes_1.u_ddr_phy_4lanes/ddr_byte_lane_C.ddr_byte_lane_C/out_fifo}]
set_property LOC OUT_FIFO_X1Y5 [get_cells  -hier -filter {NAME =~ */ddr_phy_4lanes_1.u_ddr_phy_4lanes/ddr_byte_lane_B.ddr_byte_lane_B/out_fifo}]
set_property LOC OUT_FIFO_X1Y4 [get_cells  -hier -filter {NAME =~ */ddr_phy_4lanes_1.u_ddr_phy_4lanes/ddr_byte_lane_A.ddr_byte_lane_A/out_fifo}]
set_property LOC OUT_FIFO_X1Y11 [get_cells  -hier -filter {NAME =~ */ddr_phy_4lanes_0.u_ddr_phy_4lanes/ddr_byte_lane_D.ddr_byte_lane_D/out_fifo}]
set_property LOC OUT_FIFO_X1Y10 [get_cells  -hier -filter {NAME =~ */ddr_phy_4lanes_0.u_ddr_phy_4lanes/ddr_byte_lane_C.ddr_byte_lane_C/out_fifo}]
set_property LOC OUT_FIFO_X1Y9 [get_cells  -hier -filter {NAME =~ */ddr_phy_4lanes_0.u_ddr_phy_4lanes/ddr_byte_lane_B.ddr_byte_lane_B/out_fifo}]
set_property LOC OUT_FIFO_X1Y8 [get_cells  -hier -filter {NAME =~ */ddr_phy_4lanes_0.u_ddr_phy_4lanes/ddr_byte_lane_A.ddr_byte_lane_A/out_fifo}]


set_property LOC IN_FIFO_X1Y3 [get_cells  -hier -filter {NAME =~ */ddr_phy_4lanes_2.u_ddr_phy_4lanes/ddr_byte_lane_D.ddr_byte_lane_D/in_fifo_gen.in_fifo}]
set_property LOC IN_FIFO_X1Y2 [get_cells  -hier -filter {NAME =~ */ddr_phy_4lanes_2.u_ddr_phy_4lanes/ddr_byte_lane_C.ddr_byte_lane_C/in_fifo_gen.in_fifo}]
set_property LOC IN_FIFO_X1Y1 [get_cells  -hier -filter {NAME =~ */ddr_phy_4lanes_2.u_ddr_phy_4lanes/ddr_byte_lane_B.ddr_byte_lane_B/in_fifo_gen.in_fifo}]
set_property LOC IN_FIFO_X1Y0 [get_cells  -hier -filter {NAME =~ */ddr_phy_4lanes_2.u_ddr_phy_4lanes/ddr_byte_lane_A.ddr_byte_lane_A/in_fifo_gen.in_fifo}]
set_property LOC IN_FIFO_X1Y11 [get_cells  -hier -filter {NAME =~ */ddr_phy_4lanes_0.u_ddr_phy_4lanes/ddr_byte_lane_D.ddr_byte_lane_D/in_fifo_gen.in_fifo}]
set_property LOC IN_FIFO_X1Y10 [get_cells  -hier -filter {NAME =~ */ddr_phy_4lanes_0.u_ddr_phy_4lanes/ddr_byte_lane_C.ddr_byte_lane_C/in_fifo_gen.in_fifo}]
set_property LOC IN_FIFO_X1Y9 [get_cells  -hier -filter {NAME =~ */ddr_phy_4lanes_0.u_ddr_phy_4lanes/ddr_byte_lane_B.ddr_byte_lane_B/in_fifo_gen.in_fifo}]
set_property LOC IN_FIFO_X1Y8 [get_cells  -hier -filter {NAME =~ */ddr_phy_4lanes_0.u_ddr_phy_4lanes/ddr_byte_lane_A.ddr_byte_lane_A/in_fifo_gen.in_fifo}]


set_property LOC PHY_CONTROL_X1Y0 [get_cells  -hier -filter {NAME =~ */ddr_phy_4lanes_2.u_ddr_phy_4lanes/phy_control_i}]
set_property LOC PHY_CONTROL_X1Y1 [get_cells  -hier -filter {NAME =~ */ddr_phy_4lanes_1.u_ddr_phy_4lanes/phy_control_i}]
set_property LOC PHY_CONTROL_X1Y2 [get_cells  -hier -filter {NAME =~ */ddr_phy_4lanes_0.u_ddr_phy_4lanes/phy_control_i}]


set_property LOC PHASER_REF_X1Y0 [get_cells  -hier -filter {NAME =~ */ddr_phy_4lanes_2.u_ddr_phy_4lanes/phaser_ref_i}]
set_property LOC PHASER_REF_X1Y1 [get_cells  -hier -filter {NAME =~ */ddr_phy_4lanes_1.u_ddr_phy_4lanes/phaser_ref_i}]
set_property LOC PHASER_REF_X1Y2 [get_cells  -hier -filter {NAME =~ */ddr_phy_4lanes_0.u_ddr_phy_4lanes/phaser_ref_i}]


set_property LOC OLOGIC_X1Y43 [get_cells  -hier -filter {NAME =~ */ddr_phy_4lanes_2.u_ddr_phy_4lanes/ddr_byte_lane_D.ddr_byte_lane_D/ddr_byte_group_io/*slave_ts}]
set_property LOC OLOGIC_X1Y31 [get_cells  -hier -filter {NAME =~ */ddr_phy_4lanes_2.u_ddr_phy_4lanes/ddr_byte_lane_C.ddr_byte_lane_C/ddr_byte_group_io/*slave_ts}]
set_property LOC OLOGIC_X1Y19 [get_cells  -hier -filter {NAME =~ */ddr_phy_4lanes_2.u_ddr_phy_4lanes/ddr_byte_lane_B.ddr_byte_lane_B/ddr_byte_group_io/*slave_ts}]
set_property LOC OLOGIC_X1Y7 [get_cells  -hier -filter {NAME =~ */ddr_phy_4lanes_2.u_ddr_phy_4lanes/ddr_byte_lane_A.ddr_byte_lane_A/ddr_byte_group_io/*slave_ts}]
set_property LOC OLOGIC_X1Y143 [get_cells  -hier -filter {NAME =~ */ddr_phy_4lanes_0.u_ddr_phy_4lanes/ddr_byte_lane_D.ddr_byte_lane_D/ddr_byte_group_io/*slave_ts}]
set_property LOC OLOGIC_X1Y131 [get_cells  -hier -filter {NAME =~ */ddr_phy_4lanes_0.u_ddr_phy_4lanes/ddr_byte_lane_C.ddr_byte_lane_C/ddr_byte_group_io/*slave_ts}]
set_property LOC OLOGIC_X1Y119 [get_cells  -hier -filter {NAME =~ */ddr_phy_4lanes_0.u_ddr_phy_4lanes/ddr_byte_lane_B.ddr_byte_lane_B/ddr_byte_group_io/*slave_ts}]
set_property LOC OLOGIC_X1Y107 [get_cells  -hier -filter {NAME =~ */ddr_phy_4lanes_0.u_ddr_phy_4lanes/ddr_byte_lane_A.ddr_byte_lane_A/ddr_byte_group_io/*slave_ts}]



set_property LOC PLLE2_ADV_X1Y1 [get_cells -hier -filter {NAME =~ */u_ddr3_infrastructure/plle2_i}]
set_property LOC MMCME2_ADV_X1Y1 [get_cells -hier -filter {NAME =~ */u_ddr3_infrastructure/gen_mmcm.mmcm_i}]
set_property slave_banks {32 34} [get_iobanks 33]
          


set_multicycle_path -from [get_cells -hier -filter {NAME =~ */mc0/mc_read_idle_r_reg}] \
                    -to   [get_cells -hier -filter {NAME =~ */input_[?].iserdes_dq_.iserdesdq}] \
                    -setup 6

set_multicycle_path -from [get_cells -hier -filter {NAME =~ */mc0/mc_read_idle_r_reg}] \
                    -to   [get_cells -hier -filter {NAME =~ */input_[?].iserdes_dq_.iserdesdq}] \
                    -hold 5

set_false_path -through [get_pins -filter {NAME =~ */DQSFOUND} -of [get_cells -hier -filter {REF_NAME == PHASER_IN_PHY}]]

set_multicycle_path -through [get_pins -filter {NAME =~ */OSERDESRST} -of [get_cells -hier -filter {REF_NAME == PHASER_OUT_PHY}]] -setup 2 -start
set_multicycle_path -through [get_pins -filter {NAME =~ */OSERDESRST} -of [get_cells -hier -filter {REF_NAME == PHASER_OUT_PHY}]] -hold 1 -start

#set_max_delay -datapath_only -from [get_cells -hier -filter {NAME =~ *temp_mon_enabled.u_tempmon/* && IS_SEQUENTIAL}] -to [get_cells -hier -filter {NAME =~ *temp_mon_enabled.u_tempmon/device_temp_sync_r1*}] 20
set_max_delay -to [get_pins -hier -include_replicated_objects -filter {NAME =~ *temp_mon_enabled.u_tempmon/device_temp_sync_r1_reg[*]/D}] 20
set_max_delay -from [get_cells -hier *rstdiv0_sync_r1_reg*] -to [get_pins -filter {NAME =~ */RESET} -of [get_cells -hier -filter {REF_NAME == PHY_CONTROL}]] -datapath_only 5
set_false_path -through [get_pins -hier -filter {NAME =~ */u_iodelay_ctrl/sys_rst}]
#set_false_path -through [get_nets -hier -filter {NAME =~ */u_iodelay_ctrl/sys_rst_i}]
          
set_max_delay -datapath_only -from [get_cells -hier -filter {NAME =~ *ddr3_infrastructure/rstdiv0_sync_r1_reg*}] -to [get_cells -hier -filter {NAME =~ *temp_mon_enabled.u_tempmon/xadc_supplied_temperature.rst_r1*}] 20
