sergeykhbr/riscv_vhdl/(commit log)

2015-11-11 UART implemented. FW updated to support PNP module configuration info
2015-11-13 UART polarity rts/cts fixed. Time interval tuned
2015-11-16 Interrupt controller was added. The latest rocket core generated.
2015-11-18 ucf and xdc files added for Xilinx KC705 board
2015-11-19 Fix with the return address in the interrupt handler
2015-11-26 FW updated. Fix problem with masters request arbitrer. SRAM with init function implemented only for ModelSim simulation
    [allmem.vhd, types_nasti.vhd]
2015-12-02 doxygen initial version added. debugging problem with static inline funciton
    [nasti_gnssstub.vhd, nasti_irqctrl.vhd, nasti_uart.vhd, types_nasti.vhd, types_rocket.vhd]
2015-12-15 Exception bug fixed. FW updated to output plug'n'play info
    [types_common.vhd]
2015-12-21 led switching added. uart researching
2015-12-22 bug fix: fw read incorrect uart status address, now UART prints correct information
    [nasti_gnssstub.vhd]
2016-01-15 FW updated to support new devices. PNP new parameter was added.
2016-01-28 Async FIFO and new ADC clock domain were added. FSE engine added and disabled.
2016-01-28 Async FIFO and new ADC clock domain were added. FSE engine added and disabled. fix ignore.
2016-02-09 ASIC io pad buffers added (not all). FW update. Real ADC clock added. ise project structure optimized
2016-02-10 Fix FSE sync pulse. gnsslib enabled by default with the gnssengine stub implementation
    [nasti_gnssstub.vhd, types_gnss.vhd, types_rocket.vhd]
2016-02-18 standartization of HostIO. Fix ml605 build with L2-cache
    [nasti_irqctrl.vhd, rocket_l1only.vhd, starter.vhd, types_rocket.vhd]
2016-02-19 cleanup HostIO. Revert accidentaly ignored Xilinx project files for ML605/KC705
    [axictrl.vhd, nasti_irqctrl.vhd, rocket_l1only.vhd, starter.vhd, types_nasti.vhd, types_rocket.vhd]
2016-02-24 sync with gnss rep: kc705 prj update, dual-port for ethernet mac was added. minor fixes
    [axictrl.vhd, rocket_l1only.vhd]
2016-02-26 uncapitilized RocketTile name to rocket_tile to fix ISE mixed project. Move from ise 12.4 to 14.7
    [nasti_irqctrl.vhd, rocket_l1only.vhd, starter.vhd, types_rocket.vhd]
2016-03-03 fpga constrains and reset fixes
    [nasti_gnssstub.vhd]
2016-03-06 fixes: vivado project. some warnings. failed constrain with enabled MAC not fixed yet.
    [axictrl.vhd, grethaxi.vhd]
2016-03-09 Fix procedure call that crush Xilinx synthesizer. Constraints met. FW update. MAC enabling by default.
    [axictrl.vhd, grethaxi.vhd, types_amba4.vhd]
2016-03-26 debuger linux build was fixed. Soft reset via DSU correctly implemented avoiding MRESET csr.
    [boardsim.cpp, boardsim.h, console.cpp, nasti_dsu.vhd, ringbuf.h, rocket_l1only.vhd]
2016-03-28 debugger problem with big read arrays fixed. README update to v2.0
    [console.cpp, main.cpp]
2016-04-01 fix in DSU that incorrect read upper word of 64-bits data in 32-bits transaction
    [main.cpp, memsim.cpp, memsim.h]
2016-04-07 candidat v2 fix: bootrom bug fix that leads to corruption of SRAM entry point. Remove 2-dimen array on AXI data path that incorrectly synth. by Vivado
    [bootrom_inferred.vhd, bootrom_tech.vhd, grethaxi.vhd, grethc64.vhd, nasti_dsu.vhd, nasti_gnssstub.vhd, nasti_irqctrl.vhd, nasti_uart.vhd]
2016-04-17 doxy update (Ethernet setup, debugger help were added); fix in functional CPU model; thread exit fix
    [boardsim.cpp, boardsim.h, console.cpp, cpu_riscv_func.cpp, cpu_riscv_func.h, grethaxi.vhd]
2016-04-20 linux fix: simulator multi-thread sync. System bus,greth classes were added. System events (Haps) implemented
    [boardsim.cpp, boardsim.h, cpu_riscv_func.cpp, cpu_riscv_func.h]
2016-04-23 CPU step-queue is thread safe now (sim). Run cotrol for simulation was added: go, halt, stepping
2016-04-24 fix soc reset via debugger (stucked irq controller). DSU dummy registers address space was added to support future CPU run control debugging features and provide compatibility with simulation
    [nasti_dsu.vhd]
2016-05-04 isr_table compatible with Zephyr OS was added. UART updated with IRQ pin and FIFOs thresholds
2016-05-09 zephyr: added arch msvc and riscv64. Run nanokernel & shell example in msvc. cooperative and preemptive task/fibers switching tested
2016-05-12 zephyr: gcc build initial version (linker error not fixed). elf64 support added for the offset generator
    [Kconfig.sch, sanity_last_release.csv]
2016-05-17 zephyr: remove unused drivers&files, initial risc-v build success. _Swap method not implemented (just stub)
    [Kconfig.sch]
2016-05-19 [*] zephyr: create thread and swap logic updated but not implemented yet
2016-05-20 [+] General Purpose Timers module implemented. FW and project files accordingly updated
2016-05-21 [+] delayed interrupt implmeneted (irqctrl module) to properly support lock/unlock Zephyr actions
2016-05-25 [!] zephyr: drivers (uart, timers) updated accordingly with vhdl. [+] context switching added
2016-05-30 [!] debugger simulator: fix bug in instruction SLLW. [+] FW sources and images updated to support irq_lock register in irqctrl. [!] Fix in _Swap assembler method
    [cpu_riscv_func.cpp, main.cpp, riscv-rv64i-user.cpp]
2016-06-01 [!] LUI instruction fix (signed extending). [!] GPTimer emulator memory map fix accordingly with HW
    [cpu_riscv_func.cpp, gptimers.cpp, gptimers.h, riscv-rv64i-user.cpp]
2016-06-02 Check for failed invocations which would cause the debugger to crash. Correct dependencies in various makefiles. Add -g flags globally to detect crash causes. Force listen command to use correct IP a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
    [main.cpp]
2016-06-02 [!] debugger: fix windows build after merging. [!] GPTimers added to makefile [+] Scripting support to debugger's console improved (add wait(msec) and input via uart0 serial)
    [console.cpp, cpu_riscv_func.cpp, gptimers.cpp, main.cpp, uart.cpp]
2016-06-02 [+] zephyr: printk enabled. First message: 'Zephyr Kernel 1.3.0 received'
2016-06-03 [!] debugger: linux build fixed (mess with the objects files)
    [cpu_riscv_func.cpp, uart.cpp]
2016-06-05 [+] Zephyr kernel 1.3.0. sucessfully run (stability under test). [!] Bug fixes: UART sim status, Simulator event queue removing item [+] Bootloader updated to support mepc register saving
    [console.cpp, cpu_riscv_func.cpp, uart.cpp]
2016-06-07 [!] Fix Zephyr swap context fiber -> task. [*] FPGA ROM hex-image files were updated. Zephyr is now default application (fwimage.hex).
    [cpu_riscv_func.cpp]
2016-06-10 [+] vhdl: interaction with zephyr via uart during RTL simulation was implemented. Module uart_sim was added. Found exception 'unaligned store' on function unlock_irq(key) (fixing in progress).
    [types_util.vhd]
2016-06-16 [+] ml605 virtex6 v3.0 fpga image released. [+] Zephyr successfully run on FPGA. [!] UART registers mapping changed to fix bug with RX fifo reading on 128-bits bus. [*] gnsslib submodules entirely ex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
    [nasti_uart.vhd]
2016-06-17 [*] vhdl uart registers mapping changes applied to software/simulation
2016-06-18 [!] Skipped REMW and REMUW instructions were added to simulate Drhystone benchmark. [!] hightick count reading value from GPTimer sim. bug fixed
    [console.cpp, gptimers.cpp, riscv-ext-m.cpp]
2016-06-23 [!] vhdl: fix gptimer that lead to 'ticks' command always returned zero
    [nasti_gptimers.vhd]
2016-06-24 [+] signal interface for gpio was added to implement leds switching in GUI
2016-07-11 [+] passthrough simulated uart serial interface to/from GUI
2016-07-26 [+] GUI plugin updated with new interaction ideology: commands outside of UI thread
2016-07-27 [!] fixed bug in event queue that occurs in attribtue clone() method. [-] Removed generated Meta Object headers from sources
    [DbgMainWindow.cpp, cpu_riscv_func.cpp, cpu_riscv_func.h, iclock.h]
2016-08-02 [!] fixing differences between GUI console and simple console
    [console.cpp, main.cpp, uart.cpp]
2016-08-10 [!] Fix annoying critical bug in command queue that was added after implementing two-step callback registration. [!] Fixing memory leakage in comand queue [*] Configuring QT-widgets via GUI attribute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
    [DbgMainWindow.cpp, console.cpp, cpu_riscv_func.cpp, icpuriscv.h, riscv-isa.h]
2016-08-10 [-] Remove Zephyr files copies and prepare patches for original repository zephyrproject.org. [+] howto file added inside zephyr sub-folder
    [sanity_last_release.csv]
2016-08-11 [!] linux fix no.1: sigfault via uninitialized memory in AttributeType. [*] fwimage.hex with Zephyr 1.4.0 added
    [console.cpp, main.cpp]
2016-08-12 [!] fix bug on linux with console module (not flushed entered symbols)
    [console.cpp]
2016-10-05 [*] New Zephyr kernel 1.5 and bootloader images [!] elf2raw64 base address option was added (no more need in elf2hex) [*] bootloader updated: new reset vector value 0x1000, elf2hex64 usage, mvect and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
    [main.cpp]
2016-10-05 [*] Update CPU simulator to priv spec 1.9: add new instructions, correct CSRs indexes. [*] Zephyr 1.5 successfully run on simulator
    [cpu_riscv_func.cpp, memsim.cpp, memsim.h, riscv-ext-a.cpp, riscv-ext-f.cpp, riscv-ext-m.cpp, riscv-isa.h, riscv-rv64i-priv.cpp]
2016-10-06 [*] Initial mergin with the latest RocketChip. [+] FPU enabled config [-] HostIO bus removed [!] TileLink data bus set = 64 bits (was 128) [!] AXI data bus width set = 64 bits (was 128) [-] Resets ar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
    [eth_axi_mst.vhd, rocket_l1only.vhd, types_amba4.vhd, types_rocket.vhd]
2016-10-08 [-] remove Host IO. [+] redesign interrupts routing from irq controller (PLIC) [-] Remove config with L2
    [nasti_dsu.vhd, nasti_irqctrl.vhd, rocket_l1only.vhd, starter.vhd, types_rocket.vhd]
2016-10-08 [+] add accidentaly skipped verilog files'
    [behav_srams.v]
2016-10-09 [+] Add new debuggers service like: comport, autocompleter, execution engine. [*] Move exec. command under separate interface. [*] Redesign QT-gui itself so that it uses only console commands (no nee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
    [ConsoleWidget.cpp, ConsoleWidget.h, DbgMainWindow.cpp, GpioWidget.cpp, GpioWidget.h, PnpWidget.cpp, PnpWidget.h]
2016-10-10 [!] Fix debugger linux build [+] Data attribute optimization [+] com-port for linux added [+] new commands added as a separate objects to the executor [!] Bug fix in registers view and with polling s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
    [ConsoleWidget.cpp, ConsoleWidget.h, DbgMainWindow.cpp, GpioWidget.cpp, GpioWidget.h, PnpWidget.cpp]
2016-10-11 [*] remove hardcoded buffer size for json-config [!] fix buges in different commands implementation [*] cleanup commented code [-] Not finished transition on autocompleter output for GUI control cons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
    [ConsoleWidget.cpp, DbgMainWindow.cpp, comport.cpp, console.cpp]
2016-10-12 [!] several fixes in commands implementaion (exit, log) [*] signal/slot instead timers in console view and serialv iew [+] good comand line editor implemented via autocompleter
    [ConsoleWidget.cpp, ConsoleWidget.h, DbgMainWindow.cpp, console.cpp]
2016-10-13 [*] bootloader fix with correct irq enable bit [*] CPU model updated accordingly with priv.1-9 spec: orv level swithcing, irq bits, HostIO removed [!] Emulated UART serial console works good now, bec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
    [console.cpp, cpu_riscv_func.cpp, cpu_riscv_func.h, icpuriscv.h, main.cpp, riscv-isa.h, riscv-rv64i-priv.cpp, riscv-rv64i-user.cpp]
2016-10-14 [!] ModelSim simulation fixed and successfully run. [*] ML605 successfully run with serial in/out. FPU constraint 40 MHz not fixed yet. Need clock freq reducing [*] PNP gui widget entirely implemented
    [DbgMainWindow.cpp, PnpWidget.cpp, PnpWidget.h, comport.cpp, nasti_irqctrl.vhd, pnp.cpp, pnp.h]
2016-10-17 [+] KC705 bitfile add v4.0. [*] fix qr-resources file fix. [*] update RISCV_api with new utils methods. [*] tuning linux application exiting (not entirely fixed yet)
    [ConsoleWidget.cpp, ConsoleWidget.h, DbgMainWindow.cpp, GpioWidget.h, comport.cpp]
2016-10-25 [+] SystemC model of River updated: Instruction fetch stage implemented with simple icache module
2016-10-26 [+] River SystemC model updated: add RV32/64I decoder and 3ports memory for the common registers. Initial version of the executor stage.
2016-11-01 [+] SystemC RIVER: CPU execution trace files generation added (for functional and systemc models). First ~100 instructions of bootloader checked. [!] A lot of fixes in systemc to make work properly f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
    [cpu_riscv_func.cpp, cpu_riscv_func.h, cpu_riscv_rtl.cpp, main.cpp, rtl_wrapper.cpp]
2016-11-03 [*] vhdl: add w_last signal into greth AXI master interface. [+] Add new config file _sys_river_ena.json that enables SystemC CPU model instead of Functional model. [!] A lot of fixes in SystemC mode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
    [cpu_riscv_func.cpp, eth_axi_mst.vhd, main.cpp, riscv-rv64i-user.cpp]
2016-11-04 [*] Description capability for attributes was added. [!] Fix global configuraiton parameter. Now it is possible use -c argument to specify external configuration file (for SystemC RIVER for an exampl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
    [cpu_riscv_func.cpp, cpu_riscv_func.h, main.cpp, riscv-rv64i-user.cpp, rtl_wrapper.cpp]
2016-11-07 [!] SystemC: Fix bugs in multi-cycles instructions. Zephyr succefully loaded. Interrupts on the way
2016-11-08 [*] SystemC: update CSR registers, implemented intial traps logic (interrupts & exceptions)
2016-11-09 [*] SystemC RIVER: external interrupt (testing with UART serial) works good. Need more tests.
2016-11-12 [!] RIVER: Fix bug in mode switching on trap. [+] Add vhdl library riverlib [+] Run Dhrystone benchmark on precise SystemC CPU model (more than 13 million instructions): Final score = 33268 Ways to i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
    [cpu_riscv_rtl.h, rtl_wrapper.cpp, rtl_wrapper.h, types_river.vhd]
2016-11-15 [+] Implement integer multiplication algorithm in VHDL and systemC. [*] Update multi-cyle instructions handling on 'execution' stage. [+] Add some initial versions of VHDL files for RIVER CPU
2016-11-18 [+] River CPU: add VHDL divider and execute stage modules
2016-11-20 [+] Add VHDL RIVER CPU files: branch predictor and memory access stage
2016-11-22 [!] Fix linux build. [+] Add makefile for RIVER SystemC CPU model [-] Remove hardcoded JSON-configuration. Now start application with config argument
    [cpu_riscv_func.cpp, main.cpp, riscv-rv64i-user.cpp, rtl_wrapper.cpp]
2016-12-04 [+] Intial integration of RIVER CPU into SOC. Tested with ModelSim others targets are broken. [-] VHDL is newer than SystemC of RIVER. Totally rerfactored interaction with caches. [!] AMBA AXI slaves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
    [riscv_soc.vhd, river_amba.vhd, river_cfg.vhd, river_top.vhd, types_amba4.vhd, types_river.vhd]
2016-12-06 [!] River bug fixes: XRET instruction, IMUL/IDIV fixed and intensivly tested. [!] Drhystone result computation fixed. RIVER Dhry score = 32893 on FPGA.
    [cpu_riscv_func.cpp, riscv-rv64i-user.cpp, rtl_wrapper.cpp]
2016-12-09 [+] Full redesign of AXI interconnect. Removed legacy AHB signals. [+] Add miss-access interrupt support [!] Linux build fix (unused variable)
    [axictrl.vhd, eth_axi_mst.vhd, riscv_soc.vhd, types_amba4.vhd, types_rocket.vhd]
2016-12-11 [+] Add non-blocking transactions support into functional/SystemC models. Extremely nice and and useful feature to implement interaction with systemc. [+] Add inital version of debug port into RIVER 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
2016-12-12 [*] SystemC preise CPU model connected to debugger with GUI (awesome feature). Tested on windows. [-] Linux version reads some garbage instead registers values via non-blocking interface, need to fix
    [cpu_riscv_func.cpp, cpu_riscv_func.h, cpu_riscv_rtl.cpp, cpu_riscv_rtl.h, icpuriscv.h, imemop.h, rtl_wrapper.cpp]
2016-12-14 [!] Fix non-blocking read from systemc (uninit variable ued) [!] Fix stepping in systemc model [!] Fix register write action (npc) in systemc [*] Configuration defines for SystemC were made as plugin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
    [cpu_riscv_rtl.cpp, cpu_riscv_rtl.h, imemop.h, rtl_wrapper.cpp, rtl_wrapper.h]
2016-12-16 [!] Fix fault on exit (callback on destroyed widget. [*] Remove unused generic parameters in vhdl [*] DSU moved and renamed
    [DbgMainWindow.cpp, comport.cpp, eth_axi_mst.vhd, greth_pkg.vhd, grethaxi.vhd, nasti_gnssstub.vhd, nasti_gptimers.vhd]
2016-12-18 [+] Implement DSU for River CPU [+] Add bus utilization registers and miss access interrupt/statistic registers. [!] Fix bug in greth write access (loosing least bit of address) after changing data b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
    [axictrl.vhd, eth_axi_mst.vhd, riscv_soc.vhd, rocket_l1only.vhd, types_amba4.vhd, types_river.vhd, types_rocket.vhd]
2016-12-19 [+] Add into VHDL River CPU debug port IO, update CSRs addresses in target scripts [*] preparing another one significant update into AXI inteconnect to solve problems with multiple masters transactio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
    [axictrl.vhd, river_cfg.vhd, types_amba4.vhd]
2016-12-20 [!] Fix debugger build [*] Implement the same state machine in DCache as in ICache (SystemC)
    [riscv-rv64i-user.cpp]
2016-12-23 [*] updating axictrl vhd to properly handle multiple masters requests. Add long burst transaction into soc testbench (rtl simulation). [*] updating cache top of River [-] VHDL and SystemC are not con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
    [axictrl.vhd, river_amba.vhd]
2016-12-25 [!] Fix virtex6 synth error in csr module [*] removed unsued signals [!] Fix some ISE warnings [-] There's synth issue in Vivado (kc705). Can't generate shifters from dynamic argument. Need to fix.
    [river_cfg.vhd]
2016-12-30 [!] Finally fix serial port on windows (adding delay between open and setting properties). River CPU is now tested on FPGA with GUI interface. Ready to release v2.0
    [comport.cpp]
2017-01-04 [+] CPI command implemented. available on all targets including FPGA [!] Soft reset via DSU in SoC simulation fixed [*] Registers view Widget optimized to get all values per one EDCL request [*] GUI 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
    [cpu_riscv_func.cpp, main.cpp, rtl_wrapper.cpp]
2017-01-05 [!] Fix VHDL bug that occurs on access from different masters to the same slave with different operations types (read/write). Now debugger works perfectly with fpga board and all opened widgets at th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
    [eth_axi_mst.vhd, types_amba4.vhd]
2017-01-09 [+] Update SystemC model to support breakpoints. [+] Add 'reset' console command [*] Prepared some functionality to support command string autocompleting
    [cpu_riscv_rtl.cpp, icmdexec.h, rtl_wrapper.cpp, rtl_wrapper.h]
2017-01-11 [!] Fix 'disas' command. [+] Added mouse wheel scrolling to disassembler view
    [DbgMainWindow.cpp, icmdexec.h]
2017-01-19 [*] Update 'rocket-chip' to the latest version. TileLink was totally redesigned. [!] Fix bug in axictrl that was cause zero value reading from memory using debugger
    [behav_srams.v, rocket_l1only.vhd, tl2axi.vhd, types_amba4.vhd, types_rocket.vhd]
2017-01-22 [!] Fix bug in functional 'shift immediate instructions (SLLIW, SRAI ..). Wrong condition to generate exception.
    [riscv-rv64i-user.cpp]
2017-01-25 [!] Fix interrupt controller functional model to properly handle lock/unlock interrupts signal. [*] Add debug helping port Zephyr 1.6 kernel
    [cpu_riscv_func.cpp, cpu_riscv_func.h, riscv-rv64i-priv.cpp, riscv-rv64i-user.cpp, rtl_wrapper.cpp]
2017-01-26 [!] Critical bugs fixed: SRAI instruction decoder (systemc and vhdl), Exception generation
    [nasti_irqctrl.vhd, riscv-rv64i-user.cpp, rtl_wrapper.cpp]
2017-01-27 [!] Zephyr v1.6.0 run on FPGA and SystemC. [!] Bug in icache fixed [+] Unaligned load/store exception generation added [*] 60 MHz zephyr -> 40 MHz [*] markdown update
    [cpu_riscv_func.cpp, rtl_wrapper.cpp]
2017-02-15 [!] Fix a couple of bug visible on Linux related to console input: not working console history, special symbols. [!] Fix 'democmd' in simple_plugin always returned VALID value
    [ConsoleWidget.cpp, ConsoleWidget.h, console.cpp, iautocomplete.h]
2017-02-21 [*] update *.pdf soc description with PNP device
2017-02-23 [+] debug symbols command and GUI browser implemented, including names filter. [+] new icons added [+] New disasm view can be opened from symbol browser by double click [+] loadelf command updated to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
2017-02-28 [+] Initial stack trace command [+] dummy StackTrace widget [!] Apply 'dos2unix.exe' for the git zephyr patches
2017-02-28 [+] Console command 'stack' with symbols binding implemented. Commit before GUI stack trace viewer update
    [ielfreader.h, riscv-rv64i-user.cpp]
2017-03-01 [*] GUI Stack Trace widget updated and supports symbols names and symbols offsets in description. It also allows to open disasm view from the stack trace.
2017-03-02 [!] Implement binary search by address in sorted debug symbols list [!] Fix bugs in symbols filter [+] Add symbol info into disasmbler
    [DbgMainWindow.cpp]
2017-03-10 [!] functional model fix: xRET instructions didn't generate illegal instruction exception when not in proper mode
    [cpu_riscv_func.cpp, riscv-rv64i-priv.cpp]
2017-03-11 [*] Split VHDL projects on two types: - basic (without GNSS functionality) that doesn't require gnsslib presence - SoC with gnss requires gnsslib presence.
    [config_k7.vhd, config_v6.vhd, riscv_soc_gnss.vhd]
2017-03-13 [*] builing fpga image with FSE to check RF front-end. Something is broken fse doesn't see satellites
    [riscv_soc_gnss.vhd, riscv_soc_gnss_kc705.xdc, types_gnss.vhd]
2017-03-14 [+] Add stack trace buffer and xRET exceptions into systemc model. [!] Fix bootloader build [*] update soc+gnss top level
    [riscv_soc_gnss.vhd, types_gnss.vhd]
2017-03-15 [!] Fix River CPU bug with sraiw instruction [*] remove 2-nd pll output to minimize probablity of error wirh clock and localize error in soc with gnss [+] Implement sync reset in all slave AXI device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
    [fsev2.cpp, gnss_stub.cpp, nasti_gnssstub.vhd, nasti_gptimers.vhd, nasti_irqctrl.vhd, nasti_uart.vhd, riscv_soc.vhd, riscv_soc_gnss.vhd]
2017-03-16 [+] Add VHDL stack trace buffer [-] found bug in GUI that make it unusable with FPGA. Need to fix ASAP
    [river_cfg.vhd]
2017-03-17 [!] GUI stability fix: adding command execution success, properly hanling commands queue. [*] update VHDL with gnss ADC samples recorder to analize problem with fast search engine
    [DbgMainWindow.cpp, types_amba4.vhd]
2017-03-19 [!] Fix memdump command bug (last line in hex format not aligned with 16 bytes). [+] Add caches states into dport control register (SystemC&VHDL)
    [DbgMainWindow.cpp, riscv_soc_gnss.vhd, river_cfg.vhd, river_top.vhd, types_gnss.vhd]
2017-04-07 [+] Add additional fetched instructions trace buffer (vhdl/sysc) to debug annoying problem occured only on fpga [*] add icache testbench generator on systemc to reproduce bug on simulation
    [DbgMainWindow.cpp, river_cfg.vhd, river_top.vhd]
2017-04-12 [!] Fix old annoying bug (river core had stopped execution on fpga only when several masters generate transactions). [*] GUI tuning: give unique names to events object used for thread synchronization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
    [DbgMainWindow.cpp, console.cpp, cpu_riscv_func.cpp, cpu_riscv_rtl.cpp, fsev2.cpp, gnss_stub.cpp, gnss_stub.h]
2017-04-13 [!] Fix delayed opening 'disasm view' in GUI [!] Fix breakpoint add/rm from GUI [*] Change DeviceID of Fast Search Engines [!] Fix gnssfw VHDL simulation (size of fwimage exceeded hardcoded size of i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
    [PnpWidget.cpp, pnp.cpp, types_amba4.vhd]
2017-05-06 [+] add file logging for uart output [!] fix attribtue string parser for floating values [*] gnssfw updated with new commands
    [comport.cpp, types_gnss.vhd]
2017-05-16 [+] Add openstreet map support into debugger. [-] There's a bug that occurs on linux with QHash destructor. Segfault on exiting from application.
    [DbgMainWindow.cpp, comport.cpp, gnss_stub.cpp, main.cpp]
2017-05-20 [!] Fix GUI problems on linux: [!] Run Qt event loop in main thread with manual handling via QtWrapper. [*] Simplify Qt initialization removing postInit events and QTimers.
    [ConsoleWidget.cpp, ConsoleWidget.h, DbgMainWindow.cpp]
2017-05-22 [!] Suppose linux bugs fixed (testing): revert to app.exec() instead of processEvents(), create app in stack instead of heap, remove manual closing of shared library with Qt to avoid SIGSEGV on exit 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
    [ConsoleWidget.cpp, DbgMainWindow.cpp]
2017-05-23 [*] Make Attribute to json-config string transformation thread-safe
2017-05-31 [+] Add Debug access via UART (without ethernet). Implemented in debugger and functional model
2017-06-02 [+] Add vhdl impl. of Test Access Point (TAP) via UART (under test yet)
2017-06-14 [+] Add VHDL uart debug port (TAP) to SoC top level. Full verification not finished yet. [+] Testing DMA template procedure as a part of tap_uart. Afterwards it will be moved into ambalib and will be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
2017-06-15 [*] Update fpga project with tap_uart.vhd. [!] Fix DMA write transaction bug in burst mode. [*] Move DMA template function into ambalib [+] Add 4 and 8 bytes operation via DMA template function
    [riscv_soc_gnss_kc705.xdc, tap_uart.vhd, types_amba4.vhd, uartmst.cpp]
2017-06-23 [!] Fix all builds. Add UART TAP id into PnP widget. [*] Preparing to release v6.0
    [PnpWidget.cpp, riscv_soc_gnss_kc705.xdc]
2017-11-13 [*] Inital merge with another branch development finished: [+] Add service port to support multiple instance of the same interface [*] Removed ISignal interface [+] Add generic CPU inteface [*} Fix m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
    [cpu_riscv_func.cpp, cpu_riscv_func.h, cpu_riscv_rtl.cpp, cpu_riscv_rtl.h, fsev2.cpp, fsev2.h, gnss_stub.cpp, gnss_stub.h]
2017-11-14 [*] Implement interrupt controller on IWire ports interfaces. [!] Restore breakpoint after merging
2017-11-24 [+] Add support of the Python bool name True/False (with the capitalized letters) when parse config string [+] Add reset interface to simulator to emulate power ON/OFF test cycle
2017-12-03 [*] Full refactoring of the functional model to support new ISA extensions [+] Create generic CPU object compatible with HC08 project [+] New debug interface based Common Bus service with memory mape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
    [DbgMainWindow.cpp, cpu_riscv_func.cpp, cpu_riscv_func.h, icpuriscv.h, instructions.cpp, instructions.h, main.cpp, plugin_init.cpp]
2017-12-04 [+] Implement generic hw and sw breakpoints (sw is used now). [*] move srcproc to River functional model library (to avoid conflicts when different architectures are used each with own source code pr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
    [DbgMainWindow.cpp, cpu_riscv_func.cpp, cpu_riscv_func.h, plugin_init.cpp]
2017-12-05 [*] Move out DSU and Ethernet access point into common folder. [!] Fix global definition of the Greth class
    [hardreset.cpp, hardreset.h]
2017-12-27 [+] Add new compressed instructions. Fix parse() method for C-type instructions
    [cpu_riscv_func.cpp, riscv-ext-c.cpp, riscv-isa.h]
2018-01-02 [+] Add pre-built zephyr and helloworld images using the latest GCC 7.1 with enabled C-extension. [*] READ.ME updated with fixes to some obsolete pathes [!] Fix hardware stack trace size bug.
    [cpu_riscv_func.cpp, main.cpp]
2018-04-30 [+] Add example with simple interrupt. GCC 7.n fix still in progress (C-extension)
2018-04-30 [!] Fix lock signal in interrupt controller model and successfully run isrdemo example built with GCC 7.1 toolchain on windows
2018-05-04 [+] All compressed instructions are disassembled now. [!] Fix bug in c.bnez and c.beqz instructions
    [riscv-ext-c.cpp, riscv-isa.h]
2018-05-06 [!] Fix C.LW instruction bug with usage of uninitialized upper word. [!] Fix loadelf command when string sections have random order in file [*] Run sucessfully zephyr 1.6 built with GCC 7.1.1 and wit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
    [ConsoleWidget.cpp, riscv-ext-c.cpp]
2018-05-06 [+] Add patch file for zephyr 1.6.0 to support gcc 7.1 toolchain. In new gcc-versions was changed typeof(int) from 8 to 4 bytes like for x86 so this patch corrects structure offsets used in assembler
2018-05-09 [+] Moving to GCC 7.1 by default: re-building bootloader with RESET_ADDR=0x0, move previous image (gcc 5.1 to obsolete folder) [!] Add C_NOP instruction to functinal model [*] Start process to update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
    [cpu_riscv_func.cpp, riscv-ext-c.cpp]
2018-05-15 [+] Update RTL with C-extension support [+] Run Zephyr on FPGA board ML605
2018-06-17 [!] Fix icache critical bug. [!] Fix systemc release target by adding /vmg compiler key [*] Remove fw_image folder from rtl and use hex-images directly from examples directory
    [config_k7.vhd, config_v6.vhd, gptimers.cpp, gptimers.h]
2018-06-17 [*] disable debug output to file (trace files) in JSON-configs
2018-06-23 [!] Change license to Appache 2.0 before adding ARM simulation model. [*] Doxy document updated
2018-06-28 [*] Add Registers View config. from JSON-file to support ARM registers set in the same widget
2018-06-28 [+] Add initial version of ARM core simulator
2018-06-30 [!] Fix gnss builds and opened issue #9
    [riscv_soc_gnss.vhd]
2018-07-22 [+] Update UART Test Access Point (TAP) to improve protocol stability by adding preambule, write transaction ACK response and others. Verified and confirmed on FPGA [+] Add initial version of JTAG Te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
    [dcom_jtag.vhd, dcom_uart.vhd, tap_jtag.vhd, tap_uart.vhd, types_amba4.vhd, types_misc.vhd]
2018-07-22 [+] Update debug via UART service accordingly with protocol changing: port speed detection, added preamble and ACK response [!] Fix loadelf bug: sections stored in a list didn't clear when new elf-im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
2018-07-22 [*] Update README with the new benchmark results [+] Add dhrystone 2.1 for bare-metal target into example folder [!] Fix simulator Windows Release target for LW instruction
    [main.cpp, riscv-ext-c.cpp, uart.cpp, uart.h]
2018-07-24 [*] Change registers offset assignment from json-config [+] Add initial version of the ARM-base system [*] Update dhrystone makefiles to build executable for RISC-V and ARM
2018-07-30 [!] Fix JTAG tap critical bugs [*] JTAG tests passed: single read/signle write transactions and burst read/burst write trasactions
    [tap_jtag.vhd]
2018-08-25 [*] Implement universal elfload command compatible with risc-v, ARM and others
2018-08-25 [!] Proposal to Fix potential problem with queued interconnec inputs that could accept several address requests before returning read/write response (#19)
    [arm-isa.h]
2018-11-17 [*] Update ARM processor simulation model
2018-11-17 [*] Refactoring queue to reduce slowdown and improve simulation performance [*] Add slowdown compuation into progress bar of GUI [*] Re-design GUI command handling to avoid unneccessary attribute clo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
    [ConsoleWidget.cpp, ConsoleWidget.h, DbgMainWindow.cpp, GpioWidget.cpp, GpioWidget.h, PnpWidget.cpp, PnpWidget.h]
2018-11-18 [+] Add Zynq Zedboard project [*] Add asic_top level to better comply with silicon verified ASIC structure [*] GPIO changed and made bidirectional instead of dip/led [*] bootimage updated accordingly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
    [ConsoleWidget.h, asic_top.vhd, config_k7.vhd, config_v6.vhd, config_zynq.vhd, grethaxi.vhd, nasti_gnssstub.vhd, nasti_gptimers.vhd]
2018-11-19 [*] Add project elf2rawx that is universal for the ARM-elf32 format and RISC-V-elf64 instead of previous elf2raw32/elf2raw64
2018-11-20 [+] Add capability to detect wrong arguments list for console commands [*] Changed string quotes for attribute to string conversion from \' to "
    [icommand.h, imotor.h, isensor.h]
2018-11-21 [+] Add breakpoint support for ARM target [+] Add CPU specific console commands: br_add, csr
2018-11-21 [+] Add makefiles for ARM plugin [+] Add default images to start ARM dhrystone (ARM model not fully fixed yet)
    [arm7tdmi.cpp, instructions.cpp]
2018-11-22 [!] Fix ARM HWord data transfer instruction sign extending [!] Fix not-cleared response on wrong console command request [-] Interface ISocIndo and service SocInfo was totally removed to improve debu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
    [DbgMainWindow.cpp, GpioWidget.h, PnpWidget.cpp, PnpWidget.h, arm-isa.h, arm7tdmi.cpp]
2018-11-24 [!] Add asic_top testbench (was ignored by gitignore file) [+] Add symbol loading for zephyr at debugger startup (new config key LoadFile') [*] Re-design ARM decoder using if/switch instead of hash-t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
2018-11-25 [!] Tuning ARM decoder [!] Fix interesting bug in ARM shift operation emulation. x86 always applies mask 0x1f on shifting value but ARM expects to receive 0 value when shift is more than 31 [*] Dhrys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
    [decoder_arm.cpp, instructions.cpp]
2018-11-25 [!] Fix access to GPtimer from Cortex processor simulation
    [gptimers.cpp]
2018-11-26 [!] Fix in ARM model LDRD/STRD instructions
    [arm-isa.h, arm7tdmi.cpp, cpu_arm7_func.cpp]
2018-11-29 [!] Fix all bugs in ARM shit-register instructions [+] Publish results with ARM simulation (reproducable from latest) [*] Update READMEM with new ARM dhrystone results
    [arm-isa.h, arm7tdmi.cpp, cpu_arm7_func.cpp, decoder_arm.cpp, instructions.cpp]
2018-12-04 [*] Update benchmark information in readme [!] Fix bitfield instructions in ARM simulator (BFI/BFC) [+] Add capability to generated splitted hex-file from elf in elf2rawx utility
    [decoder_arm.cpp, main.cpp]
2018-12-25 [!] Add CpuFpgaStub class that registers console commands reg and regs and fix error messages for FPGA target
    [cpu_stub_fpga.cpp, cpu_stub_fpga.h, plugin_init.cpp]
2019-01-15 [!] Fix simulator output when command not found (previous message was printed) [+] Start adding arm thumb decoder
    [decoder_arm.cpp, decoder_thumb.cpp]
2019-04-01 [+] Increase number of available irq wires in CpuFunctional from 64 to 128 [+] Add capability to implement instructions cache (not a HW model) into CPU model and increase simualtion time in more than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
2019-04-02 [+] Add Thumb decoder into ARM functional model [*] Update IOPort parent classes
2019-04-02 [*] Add Attribute InitCommands in JSON-config file to list all console commands that should be executed at application startup: loadelf, reset, power-on or any other. [+] Add new commands: elf2raw to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
    [main.cpp]
2019-04-03 [!] Fix ARM simulation linux build (overflow warning)
    [arm-isa.h, decoder_thumb.cpp]
2019-04-03 [!] Remove all global REGISTER_CLASS(..) instances in core library and move it into RISCV_init() method. Next step is to remove all global variables. [+] Rename Bus class as BusGeneric with address h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
2019-04-11 [!] Fix ARM decoder in disassembler service (mul instructions)
2019-04-11 [!] Fix GUI exception when key pressed and gcc8.1 warning
    [ConsoleWidget.cpp, DbgMainWindow.cpp]
2019-04-17 [!] Fix non-symbol key pressing in GUI console
    [ConsoleWidget.cpp]
2019-05-07 [*] finish porting FDIV.D instruction and computation algorithm from hw gnss sensor. Start preparing verification procedure
2019-05-08 [!] Run more than 1 million tests of FDIV.D including operations with NAND and QNAND. Fix all problem to pass all tests [!] Fix linux warning failing the build
    [fpu_func.cpp]
2019-05-08 [+] Add initial port of FMUL.D instruction from HW GNSS sensor. not tested yet
2019-05-10 [*] Continue porting FADD.D from hw gnss sensor (not tested yet)
2019-05-10 [!] Fix FSUB.D sign computation and run full verification test. [!] Fix linux build warnings
    [fpu_func.cpp, fpu_func.h]
2019-05-10 [+] Add long to double conversion FCVT.L.D instruction with verification via command 'fpu0 test fcvt.d.l' [!] Fix found bug in subtractor when value becomes qnan [+] Add FPU register to the functiona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
    [cpu_riscv_func.cpp, cpu_riscv_func.h, fpu_func.cpp, fpu_func.h, instructions.cpp, instructions.h, riscv-ext-f.cpp, riscv-isa.h]
2019-05-14 [+] Add FMIN.D and FMAX.D FPU algorithms [*] Show warning message instead of error when result differs from computed by X86 FPU and when one of operands is NaN, because it looks like FPUs are a bit d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
    [fpu_func.cpp, fpu_func.h, riscv-ext-f.cpp]
2019-05-14 [!] Remove unused variables to fix linux build
    [fpu_func.cpp]
2019-05-15 [+] Add new C-example 'bootrom_test' with intial FPU tests running successfully on River functional model [!] Fix FPU instructions to properly run bootrom_test.hex image
    [cpu_riscv_func.h, riscv-ext-f.cpp]
2019-05-17 [*] Redesign DSU functional model: + Prepareto switch debug interface when multiple CPU config [+] Assign registers offset explicitly in constructor to support DSU memory remaping and remove hardcode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
    [arm-isa.h, icpu_hc08.h, riscv-isa.h]
2019-05-18 [!] Fix ARM and SystemC platforms after DSU update. msvc17_x64 also fixed
2019-05-21 [*] Change reset vector to 0x0 with unmaskable exception support. Boot ROM changed accordingly. Modification in rtl, functional and systemc models [+] Add divstage systemc module as a start point of 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
    [bootrom_inferred.vhd, cpu_riscv_func.cpp, cpu_riscv_func.h, cpu_riscv_rtl.cpp, cpu_riscv_rtl.h, riscv_soc.vhd, river_amba.vhd, river_cfg.vhd]
2019-05-21 [*] redesign UART c++ model using memory mapped registers instead of switch-case function
    [uart.cpp, uart.h]
2019-05-21 [+] Add ICommand instance for the UART moodel to support access from python script to the emulated external uart interface
2019-05-24 [+] Add River dual-core configuration and test it with bootrom_test [+] Add command 'cpucontext' to switch accessed CPU from debugger
2019-05-25 [!] Fix vhdl errors in rtl [*] disable FPU in bootrom_tests to test it on fpga ML605
    [riscv_soc.vhd, river_amba.vhd, river_top.vhd, types_river.vhd]
2019-05-25 [!] Fix valid signals in axictrl on missaccess and successfully run bootrom_tests on ML605. Clock changed to 40 MHz [-] Need to re-design miss access exception and generate it inside River IP when ax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
    [axictrl.vhd, riscv_soc.vhd]
2019-05-26 [*] Redesign trap handling in rtl and systemc [-] rtl is broken for now
    [axictrl.vhd, cpu_riscv_rtl.cpp, cpu_riscv_rtl.h, river_amba.vhd, river_cfg.vhd, river_top.vhd, rtl_wrapper.cpp, rtl_wrapper.h]
2019-05-26 [+] Preliminar redesign of exception handling. Preparing to remove miss_access interrupt and use r_resp/b_resp AXI signal instead. Modifcation in RTL and systemc model [*] Preparing to change traps a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
    [river_cfg.vhd]
2019-05-27 [!] Fix rtl and systemc CPU hanging on interrupts
2019-05-27 [*] Prepare to redesign instruction fetching to improve performance. With the latest changes all miss accesses caused by incorrect instruction parsing in branch predictor (with C-extension) could be 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
    [river_cfg.vhd, river_top.vhd]
2019-05-29 [*] Do not update repository, rtl is broken and is under updating instruction fetching algorithm to support pre-multiplexing C/not-C before decoding
    [river_cfg.vhd]
2019-06-05 [*] Independent exception table fully implemented in models and rtl (non-maskable interrupts): [*] miss_access interrupt removed from interrupt controller and DSU [+] Exception address handlers hardc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
2019-06-06 [!] Fix halt event for systemc platform which is used by python scripts [*] Update python script to compare diffirence between functional model vs systemc. Investigation in progress
    [cpu_riscv_rtl.cpp, cpu_riscv_rtl.h, rtl_wrapper.cpp, rtl_wrapper.h]
2019-06-07 [+] Improve CPI from to 2.5 to 2.2 correctly implementing branch predictor and fetcher. Total dhrystone score improved on 14.5 procentage. Add additional rule into predictor - always do conditional b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
    [rtl_wrapper.cpp]
2019-06-10 [!] Fix command busutil gathering hw statistic by adding detection of number of master slots from PNP module
2019-06-10 [!] Fix gnss top level with the latest updates
    [riscv_soc_gnss.vhd]
2019-06-12 [+] Integrate access to FPU registers from executation stage of pipeline [*] Tested with instructions: 'fmv.d.x', 'fsd' and 'fld'.
2019-06-12 [!] Fixing functional, sysc and rtl simulations with the attached gnssfw hex-image instead of zephyr
2019-06-12 [*] remove config_common.vhd and leave only only one config_target.vhd file for each target [!] Fix unconnectedJTAG master slot in GNSS top-level that lead to infinite exception loop
    [config_k7.vhd, config_v6.vhd, config_zynq.vhd, riscv_soc.vhd, riscv_soc_gnss.vhd]
2019-06-22 [!] Fix and run hardware fpu FDIV test: 10.323/-5.3333 - success. Stress tests for all fpu modules will be added later
    [fpu_func.cpp]
2019-06-24 [+] Add systemc d2l module supporting instructions FCVT_L_D and FCVT_LU_D. [!] Fix functional model conversion instructions
    [riscv-ext-f.cpp]
2019-06-25 [+] Add and run extended FPU tests on systemc model. Fix several bugs. [*] Changing fpu exception signals (not finished). Almost ready to implement int rtl
    [fpu_func.cpp]
2019-06-26 [+] Add rtl compilable module FMUL.D vhdl (not integrated into River yet) [+] Start adding asynchronous reset support in FPU modules
    [asic_top.vhd, imul53.vhd]
2019-06-30 [+] Integrate FPU into River and pass all simple initial tests from bootrom_tests [*] Fix simulation errors, warning and differences between systemc and rtl
    [river_cfg.vhd]
2019-07-01 [+] Add CPU switcher into GUI registers view to simplify multi-core targets debugging
2019-07-02 [*] Increase bootrom to 32KB to run extended FPU tests [!] Fix issues in FADD module [-] FDIV module not finished, FMUL didn't test yet
    [bootrom_inferred.vhd, riscv-ext-f.cpp, riscv_soc.vhd]
2019-07-03 [*] update fpu test debug output. No errors found during exteneded tests in fmul and fdiv (external interrupt may split fpu test)
2019-07-04 [!] Fix sw berakpoint via ethernet and tested on dual-core fpga. Need to fix alignment for uart tap and jtag
2019-07-05 [+] Add unaligned access through uart_tap interface [*] Adding instruction support FCVT_D_W,FCVT_D_WU and reverse (in progress) [*] Continue adding async_reset generic parameters in systemc modules
    [cpu_riscv_rtl.cpp, cpu_riscv_rtl.h, riscv-ext-f.cpp]
2019-07-06 [!] Fix systemc int to double, and double to int conversion. Commit before merging into rtl
    [fpu_func.cpp, fpu_func.h]
2019-07-07 [*] Start preparing release build: [+] Add support of async reset in all river cpu submodules [*] Fixing rtl and projects [-] Remove Rocket-chip generated verilog file
    [config_k7.vhd, config_v6.vhd, config_zynq.vhd, fpu_func.cpp, imul53.vhd, riscv_soc.vhd, riscv_soc_gnss.vhd, river_amba.vhd]
2019-07-07 [!] Fix bug in debugger: context switch, unalign write via debugger (need to test a couple of days before setup tag v8.0) [!] Fix rtl projects: vivado, ISE Studio and modelsim for different targets [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
    [asic_top.vhd, config_k7.vhd, riscv_soc.vhd]
2019-07-08 [+] Add icache registers flush from debug interface and on breakpoint (rtl + systemc) [*] Split critical path in fadd_d module adding additional registered step [!] Fix bug in debugger when 2 compres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
    [river_cfg.vhd, river_top.vhd]
2019-07-08 [*] Revert previous logic of posedge detection for ext_irq signal (was implemented in exec) [+] Add defaul generic values for RiverTop to run auto-comparision simulation script without modification
    [river_cfg.vhd, river_top.vhd]
2019-07-08 [*] Add the latest stable bit-file for ML605 and KC705. Breakpoints and interrupts fixes confirmed
2019-07-15 [*] Rename current ICache systemc model into ICacheStub and start another version ICacheLru that will be instantiated via generic parameter
2019-07-20 [!] Fix initial errors in icache lru implementation and run first tests from tb
    [cpu_riscv_rtl.cpp]
2019-07-21 [!] Fix errors in sysc model of icache [+] Add flush state to init memory bank after reset
    [cpu_riscv_rtl.cpp]
2019-07-23 [*] Run new icache LRU sysc model as the default icache. There're some missmatches with functional model need to fix but icache algorithm is more-or-less alive
    [cpu_riscv_rtl.cpp]
2019-07-31 [!] Fix linux systemc library build
    [cpu_riscv_rtl.cpp]
2019-08-01 [+] Add memaccess rtl next version [*] Continue fixing bugs in rtl (not finished) while integrating new icache into river
    [river_amba.vhd]
2019-08-02 [*] Update projects for ml605 and kc705. timing violation detected that need to be fixed
    [config_v6.vhd]
2019-08-03 [!] Partially fix load fault exception signal (need to add outputs fault address to be exact) [*] Full refactoring of axictrl Bus Controller to work as a pure cross-bar bridge
    [axictrl.vhd, river_amba.vhd]
2019-08-05 [!] Continue fixing rtl for fpga: [!] Fix continues exceptions load_fault/store_fault [+] Add async_reset generic to axictrl [*] Update accordingly systemc model
    [axictrl.vhd, cpu_riscv_rtl.cpp, cpu_riscv_rtl.h, riscv_soc.vhd, river_amba.vhd, river_cfg.vhd, river_top.vhd, rtl_wrapper.cpp]
2019-08-07 [!] Simplify axi interconnect avoid using two-level cycles. It helped to find bug in b_valid signal forming. Hope these modifications will help to run dhrystone on fpga ml605. Later I'll return to cr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
    [axictrl.vhd, types_amba4.vhd]
2019-08-09 [*] reviewing implemented cache code to locate problem with fpga. Debug interface works fine but cpu doesn't
    [config_k7.vhd]
2019-08-11 [!] Fix systemc crush [!] Fix lru algorithm [+] Add single port memory support instead of dual-port ram [*] Preparing next iteration to run on fpga
    [river_cfg.vhd]
2019-08-12 [!] fixed ar_ready while writing on slave sides. there's still problem on river side
    [types_amba4.vhd]
2019-08-12 [*] continue update executation stage to potentially support microcoded instructions (atomic and other multioperation)
2019-08-15 [*] Merge systemc with rtl. Commit before fpga check [-] breakpoints not fixed yet
    [river_cfg.vhd]
2019-08-16 [+] Adding new AXI4 templates (AXI4toMem and MemToAXI4) to implement generic slave devices with simple interface. Add component ax4_sram, testing in progress and not finished
2019-08-17 [*] Enabling axi_sram instead of nasti_sram by default [-] fpga works very unstable... sad. Modification of icache_top is the most probable reason of that. SystemC shows errors in it.
    [config_v6.vhd, riscv_soc.vhd, types_amba4.vhd]
2019-08-17 [!] small fix in new MemToAxi4 template that do not allow to confirm aw and ar requests in the same time when dualport signal disabled [*] cache_top systemc modified accordingly with the rtl implemen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
    [axi4_sram.vhd, types_amba4.vhd]
2019-08-17 [*] The latest fix with aw/ar requests signifcantly improved stability so implement RomBoot using the new template interface AXI4toMem and give the name to the module axi4_rom. Give additional parame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
    [axi4_rom.vhd, riscv_soc.vhd, riscv_soc_gnss.vhd, types_amba4.vhd, types_misc.vhd]
2019-08-17 [!] Fix axi4_rom unused variables [-] Remove nasti_sram.vhd
    [axi4_rom.vhd]
2019-08-18 [!] Fix bug with latching return address from trap when the end of multicycle instruction happen. That lead to zephyr illegal instruction exception while execute drhystone.
    [river_cfg.vhd]
2019-08-18 [!] Fix lost interrupt when multi instruction started in the same time with external interrupt pulse [*] Temporary modify bootrom_tests to test interrupts and fmul.d in long cycle
2019-08-18 [*] Finally zephyr works fine. No FPGA problems found during differnt tests: many-many times run dhrystone, random key pressing, different console commands [-] Something wrong with debug access. Need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
2019-08-19 [!] Fix bug in read burst transaction when read address while ar_valid inited by xsize from previous transaction. That could lead to chaotic behaviour from debug interface. let's check on fpga [+] Up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
    [axi4_rom.vhd, axi4_sram.vhd, axi4_uart.vhd, axislv.vhd, riscv_soc.vhd, riscv_soc_gnss.vhd, types_amba4.vhd, types_misc.vhd]
2019-08-19 [-] I've broke rx fifo in uart, need to fix [*] update ise project and fix ROM size via generic parameter
    [axi4_uart.vhd]
2019-08-20 [!] Fixed rx fifo UART accordingly with rtl simulation [*] AXI4 procedures changed on separate module in modules: SRAM, ROM and UART
    [axi4_rom.vhd, axi4_sram.vhd, axi4_uart.vhd, axislv.vhd, types_amba4.vhd]
2019-08-20 [!] Fix 4-bytes burst transactions that can issue only TAPs [-] Remove procedure that moved into separate module axislv.vhd
    [axislv.vhd, types_amba4.vhd]
2019-08-20 [*] Checked with ml605. Everything works as expected. Debug access fixed. So, now I can continue migrate on a new interface module axislv to implement 1 clock write cycle (a-la AXI Lite)
2019-08-22 [*] Migrate on new axi4 interface for modules: irqctrl and pnp. It is almost ready (except eth) to switch on one-cycle write AXI Lite support
2019-08-22 [*] update doxygen uart chapter
2019-08-23 [-] ISE project cannot pass place&route stage with enabled single cycle write access (branch w_single_cycle). So, postpone this update until D-cache will be implemented. [+] Split ambalib and move ou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
2019-09-02 [!] Fix time violation constrain in module fpu fadd.d for kc705 in Vivado without changing logic itself. There's the same problem in module imul53. ISE + ml605 doesn't have such problems
2019-09-02 [!] Fix time constrain violations in imul53 block when Vivado for KC705 is used. No functional changes were made
    [imul53.vhd]
2019-09-02 [*] Update README with the new CPI score = 1.9 accordingly with dhrystone. Update River top level picture. [*] Update uart doxy adding information of how to use lock register fwcpuid.
2019-09-03 [+] Start adding new custom CSR registers: CSR_reset - to diffiriantiate hard reset and reset from watchdog CSR_mstackovf - generate trap on stack overflow CSR_mstackund - generate tap on stack under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
    [cpu_riscv_func.cpp, riscv-isa.h]
2019-09-04 [+] Implement Stack Protection tests in bootrom_tests application and verify them with the functional and systemc simulation. Ready to port on rtl [*] Add additional fwdbg2 register into pnp module [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
    [cpu_riscv_func.cpp, gpio.cpp, gpio.h, periphmap.h, riscv-isa.h]
2019-09-04 [*] Move stack exceptions (WLRL) from 12,13 to 16,17 to avoid conflict with PageFault exceptions [+] Update doxy CPU description page [+] Add attribute ExceptionTable to functional model to freely co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
    [cpu_riscv_func.cpp, cpu_riscv_func.h, riscv-isa.h]
2019-09-04 [!] Fix systemc trap_code bit width. Number of exceptions exceeds 16 so need to increase variables bitwidth.
    [cpu_riscv_func.cpp]
2019-09-15 [+] Start new project libdpiwrapper that will provide access to RTL simulation from debugger via SystemVerilog DPI interface [+] Successfully run initial DPI run control tests controlling rtl from ou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
2019-09-15 [!] Fix libdpiwrapper makefiles for linux. Not tested with ncsim
    [main.cpp]
2019-09-15 [!] Fix test application for linux that emulates system verilog exposing library function names into global namespace
    [main.cpp]
2019-09-17 [!] Fix #32. Warning in systemc file (bool conversion to enum). [!] Fix reset isr_table register in irq controller that zero value was used to detect neccessity of memory mamanger allocation in bootr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
    [rtl_wrapper.h]
2019-09-19 [*] Move on version MSVC2019 for the windows x64 project (msvc2017 removed). The main development tool is still msvc2013 due some errors in systemc under msvc17 or 19
    [cpu_riscv_rtl.cpp]
2019-09-20 [*] Update DPI server adding client thread and increas number of supported commands. Ready to work with external simulator
2019-09-21 [-] Remove unused logic from ConsoleClass to avoid error message: service core0 not found (#29). Functionality didn't changed only message. [!] Fix blocking timeout of method select() in TcpClass. Li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
    [console.cpp]
2019-09-22 [*] Update DPI library implementing state machine to support real axi4 transactions and interrupt requests [*] Build and run test application on linux
2019-10-01 [*] Update doxygen generated documentation: interrupt controller description
2019-10-25 [*] Move top-level RTL file and test bench into target specific project directories. I would like to have a single riscv_soc file with the common logic (including gnss sub-system) and top-level that 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
    [asic_top.vhd, asic_top_tb.vhd, axi4_flashspi.vhd, config_sim.vhd, kc705_top.vhd, ml605_top.vhd, riscv_soc.vhd, types_bus0.vhd]
2019-10-25 [+] Add OTP behavioral model to comply with the doxygen documentation. Preparing to add GNSS as a single slot sub-system device
2019-11-08 [!] Fix address bus bitwidth errors when switch from 32-bits on 64-bits [-] Remove obsolete trace buffer from fetcher (systemc and rtl)
    [river_cfg.vhd]
2019-11-08 [!] Fix rtl module declaration
    [river_cfg.vhd]
2019-11-08 [+] Add External SPI flash test into ROM MBIST firmware to test SPI brdige on rtl
2019-11-20 [*] Update boot ROM adding SPI Flash test. Now River SoC doesn't work because of wrong implementation of the write data with wait states and bug in spiflash.vhd bridge
    [cpu_riscv_func.cpp]
2019-11-21 [+] Flash SPI successfully connected [!] Fixed axi write transaction with wait states
    [axi4_flashspi.vhd, axi4_pnp.vhd, axislv.vhd, config_sim.vhd, riscv_soc.vhd, types_misc.vhd]
2019-11-25 [+] Add gdb server to support gdb protocol for ARM and RISC-V architectures [*] Changed reset interface to avoid manual definition of devices to reset. No all devices with reset interface will be res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
    [ConsoleWidget.cpp, ConsoleWidget.h, comport.cpp, console.cpp]
2019-11-25 [*] Update fpga projects with gnss sub-system. some 1 drc error detected
    [axi4_pnp.vhd, config_k7.vhd, config_v6.vhd, top_kc705_gnss.xdc]
2019-11-26 [+] Update axislv.vhd to support burst write transactions with address overlap. [!] Fix ncsim warning changing integer registers on std_logic_vector(31 downto 0) in modules spiflash bridge and uart
    [axi4_flashspi.vhd, axi4_uart.vhd, axislv.vhd]
2019-11-26 [+] Retore project files for vivado and ise [-] Current version doesn't work properly. Previous commit broke system!!!
    [config_k7.vhd, config_v6.vhd]
2019-11-28 [!] Fix optimized axi slave interface properly handled burst wrap address increment
    [axislv.vhd]
2019-11-28 [+] Minor modifications: executed instruction counter enabled by exec valid signal instead of memaccess valid [*] GPIO direction write in bootrom_tests [+] Add empty tracer module in rtl
2019-11-28 [+] Add initial SystemC tracer into cpu model (enabled in config)
2019-11-29 [!] Fix in execute step: recently implemented queue in the memaccess module allows to accept 2 sequential memory operations (such as LOAD) without waiting response from bus. This fix takes into accou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
    [uart.cpp, uart.h]
2019-12-01 [!] Fix wrong signal usage (RTL) in module memaccess. To fix this bug systemc was update to generate trace file fully comparable with the wasserfall trace file
    [config_k7.vhd, config_v6.vhd, cpu_riscv_rtl.cpp, cpu_riscv_rtl.h, iclock.h, uart.cpp, uart.h]
2019-12-01 [!] Add stress-test of amba interconnect using dual-core config + boot update and found and fixed bug in slave interface with the memory write request while in a read hold state
    [axislv.vhd, config_sim.vhd]
2019-12-04 [!] fix uart to print all information during simulation
    [uart.cpp]
2019-12-05 [!] Fix warnings generated by Jasper tool: possible latches, race condition with nrst signal between fetcher and icache modules [*] Preparing to release stable version 10 before implmenting MPU and d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
    [config_k7.vhd, config_v6.vhd]
2019-12-05 [!] Move Jasper warnings from trl into systemc model to maintain identity [!] Fix some warnings of building on Ubuntu: initialization order, type conversion
    [cpu_riscv_func.cpp]
2019-12-07 [+] Add fpga kc705 bit file with v10.0 [!] Fix structure of Zynq ZedBoard project but default configuration with fpu and icache doesnt fit into fpga (97% LUT, 100% memory). Just leave it as a help pr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
    [config_zynq.vhd]
2019-12-08 [*] Switch to gcc-8.3.0 improves drhystone to 101200 dhry [+] Start dcache implementation on systemc
2019-12-15 [+] Add initial connection of DCache LRU to River core systemc [*] Enabling default MPU region[1] above 0x80000000 as uncached for IO access [*] Run simulation and after 13.5 us occurs memory corrupt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
    [cpu_riscv_rtl.cpp]
2019-12-16 [!] Fix general bug and run dhrystone simualtion on systemc with D$ enabled [*] Update tracer
    [uart.cpp]
2019-12-19 [*] Move out queue module from memaccess [*] Update tracer to support out-of-order memory access
2019-12-19 [*] playing with register forwarding. need to think out how to update tracer.
2019-12-24 [+] Re-design cache_top in systemc using queue module to remove AXI4 protocol vialoations, especially old bug with queued slave devices that can accept several transactions without response (such dev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
    [cpu_riscv_rtl.cpp, cpu_riscv_rtl.h, rtl_wrapper.cpp, rtl_wrapper.h]
2019-12-25 [+] Merging with systemc (part 1): [+] Add MPU [+] Add dcache with lru and re-designed icache [+] Change AXI master state machine to remove AXI4 protocol violations [-] RTL not working while all modi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
    [river_amba.vhd, river_cfg.vhd, river_top.vhd, types_river.vhd]
2019-12-25 [*] minor fixes in systemc during merge with rtl
    [cpu_riscv_rtl.cpp, cpu_riscv_rtl.h]
2019-12-26 [*] Continue merging systemc into rtl (decoder part). RTL is still not finished and not working
    [river_cfg.vhd]
2019-12-27 [!] Fix general bugs and run rtl simulation with drhystone example
    [config_sim.vhd, river_cfg.vhd]
2019-12-27 [*] Commit before fixing detected timing loops in icache
    [config_k7.vhd]
2020-01-02 [*] Add csr registers to control MPU in RTL [!] Fix fpu enable signal in exec module [-] fpu not properly enabled yet
    [river_cfg.vhd]
2020-01-02 [!] Fix type conversion boolean to integer in vhdl
    [types_common.vhd]
2020-01-05 [!] Fix bugs when postponed memop writeback operation re-writes the valid directly written value. Fix affects CPI that not good. So this is intermediate commit before changing a bit register bank and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
    [cpu_riscv_func.cpp, uart.cpp]
2020-01-06 [!] Merge tagged registers from systemc into rtl. System wasn't run on fpga yet and probably still has several bugs
    [config_sim.vhd, river_cfg.vhd]
2020-01-07 [!] Fix debug interface: doubled step on instruction stepping, access to fpu registers [*] Code cleanup: remove unused signals
    [cpu_riscv_rtl.cpp, cpu_riscv_rtl.h, periphmap.h, pnp.cpp, river_cfg.vhd, rtl_wrapper.cpp, rtl_wrapper.h]
2020-01-07 [*] Update and fix simulator for linux. [-] Something wrong with the latched error code and mepc on exceptions [*] Code cleanup
    [config_k7.vhd, cpu_riscv_func.cpp]
2020-01-08 [!] Fix lru write address (not-delayed on 1 clock) [-] Do not enable mie bit in bootimage. IRQ generates transition umode to mmode
    [axi4_uart.vhd, pnp.cpp]
2020-01-08 [!] Fix vivado warning: signal not in sensitivity list, remove latches. [*] zephyr stably works on kc705 board
2020-01-08 [+] Add and modify for this SoC riscv-tests to check compatibility with risc-v specification. Stop on fencei instruction. It looks like I wrongly understood implementation, so I need to wait d-cache 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
2020-01-09 [!] Fix torture riscv-tests FENCE.I testcase in systemc: post flush reuqest into memory queue to avoid flushing before actual last value has been writen; wait instruction fecth until fully flushed to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
    [uart.h]
2020-01-10 [!] Merge all fixes from systemc into rtl [+] Run successfully rv64ui tests on rtl simulation
    [config_sim.vhd, river_cfg.vhd, river_top.vhd]
2020-01-11 [!] Fix write ena strob into MPU [+] Add test of MPU into boorom_test adding SPI flash region into uncached region
2020-01-13 [+] Add pwm generation support int GPTimers module [*] Update doxygen description of GPT [!] Fix #33 issue
    [axi4_gptimers.vhd, riscv_soc.vhd, types_misc.vhd]
2020-01-14 [!] Fix rtl gptimer RESET structure and move on top level (riscv_common) output signal o_pwm for all targets (checked with simulation)
    [asic_top.vhd, asic_top_tb.vhd, axi4_gptimers.vhd, riscv_soc.vhd]
2020-01-16 [*] Start preparing arm simulator for demonstration purpose based on stm32l4xx cpu
2020-01-17 [*] Update tracer in functional generic cpu to gather multiple actions per one instruction [*] Update arm thumb demo:
2020-01-18 [*] Update stm32 model (arm cpu). Simulated more than 7700 clocks before exception with demo example.
2020-01-19 [*] Update stm32l4 demo simulation target adding new device model (rcc and gpio) and new thumb instructions
2020-01-20 [*] Updating arm demo. stopped on if-then instruction (IT)
2020-01-20 [!] Fix integer divider accordingly with riscv-tests. Now division on zero produces all-ones results (x86 produce zero result). So disabling auto-comparision of divider module in systemc [!] Fix sign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
    [riscv-ext-m.cpp]
2020-01-21 [+] Implement tracer in river functional model comparable with systemc. For this were added method setReg in all instructions modifying regsiters [+] Run successfully riscv-tests on functional model 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
2020-01-21 [*] Update arm demo simulation implementing If..Then (IT) instruction and blocking execution
2020-01-21 [*] Enabling MULHU instruction. It is worked in system but doesnot in functional model. fix in progress
    [riscv-ext-m.cpp]
2020-01-22 [!] Fix mulhu instruction in functional simulation. 2 instructions left: mulhsu and mulh
    [riscv-ext-m.cpp]
2020-01-22 [+] Update arm demo platform: adding SysTick and NVIC devices
2020-01-22 [!] Fix MULH related instructions and pass riscv-tests for whole m-extension. Ready to port all modifications from systemc into rtl
    [riscv-ext-m.cpp]
2020-01-23 [*] Adding into arm demo target exception enter/exit functionality
2020-01-23 [!] Fix riscv-tests for M-extension (rv64um-p): add instructions MULH, MULHSU and MULHU support, make result of division on zero as -1 (it is not compatibile with x86 but acceptable to pass tests).
    [river_cfg.vhd]
2020-01-23 [!] fix interrupt exit in arm functional simulation platform
    [arm-isa.h, arm7tdmi.cpp, cpu_arm7_func.cpp, cpu_arm7_func.h, decoder_thumb.cpp]
2020-01-24 [+] Add 320x240 color display support into demo STM32 simulation platform
2020-01-25 [+] Update generic cpu model to better support arm breakpoints and registers bank. Probably broke riscv functional model (need to check). Arm simulation ready to implement keyboard controller
    [arm-isa.h, arm7tdmi.cpp, cpu_arm7_func.cpp, cpu_arm7_func.h, cpu_riscv_func.cpp, cpu_riscv_func.h, decoder_thumb.cpp]
2020-01-26 [+] Run demo application on stm32 simulation platform platform and make some video
2020-01-27 [!] Fix Debugger makefiles (linux build) and run stm32l4xx platform on linux
    [instructions.cpp, riscv-ext-m.cpp, thumb.cpp]
2020-01-27 [!] Fix bug (uninitialized variable usage in DIV instruction) that was created by previous commit
    [riscv-ext-m.cpp]
2020-01-27 [*] minor changes in demo firmware and generate batchfile for stm32l4 target
2020-01-31 [*] Fix rtl simulation with enabled gnss subsystem
    [asic_top_tb.vhd]
2020-02-03 [*] merge from systemc: removed system bus parameters BUS_DATA_WIDTH adn strob width from river core as a first step to support 32-bits data bus [-] something wrong with rtl simulation. need to fix
    [river_cfg.vhd, river_top.vhd]
2020-02-07 [*] Implement systemc structures axi4_.. similar to vhdl that can be used a signals and input/output [*] Create CFG_RIVER_ADDR_BITS parameter that now doesn't depend of bus parameter. So now CPU and 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
    [axiserdes.cpp, axiserdes.h, config_k7.vhd, cpu_riscv_rtl.cpp, cpu_riscv_rtl.h, rtl_wrapper.cpp, rtl_wrapper.h, types_amba.h]
2020-02-08 [+] Add bit-file with dhrystone for KC705 board. Makeing release target v11.0
2020-02-24 [!] Enabling messaging between L1 and L2 caches. There is still problem to switch cache line from unique to shared state (systemc)
2020-07-16 [*] change JTAG pin assignment for kc705
2020-08-27 [+] Update functional sim tracer to disasm compressed instructions
2020-08-28 [*] Move instructions and clock timers from debug module into csr to support pseudo-instructions RDTIME, RDCYCLE and RDINSRET
2020-08-31 [*] Update simulator/debugger: - Change breakpoints handling. Remove all custom debug registers that allowed to skip breakpoint and implement gdb-ocd approach - add all breakpoints on resume command 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
    [DbgMainWindow.cpp, console.cpp, cpu_arm7_func.cpp, cpu_arm7_func.h]
2020-09-05 [!] Fix asic RTL simulation makefile for the changed server environment
    [config_sim.vhd]
2020-09-05 [*] Update debug interface: - Move DMI registers into seprate module and connect to DSU (connection to JTAG not implemented yet) - Add new module Debug Port interconnect to connect DSU directly to CP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
    [riscv_soc.vhd, river_amba.vhd, river_dummycpu.vhd, types_amba4.vhd, types_bus0.vhd, types_river.vhd]
2020-09-06 [+] Update RTL: - Implement processors workgroup with l2-caching level. Use dummy l2 for now as a simple non-coherent interconnect - Support quad-core configuration by default - Add capability to add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
2020-09-07 Updating jtag tap after failed initial test on fpga: - Fix response when re and we DMI request are zeros - Fix MISA address to 301h instead f10h
    [asic_top_tb.vhd, river_cfg.vhd, tap_jtag.vhd]
2020-09-08 [!] Fix DMI registers bug: - wrong signal used to set cmd transfer bit - Add aarpostincrement bit support in the abstract command request
    [asic_top_tb.vhd]
2020-09-08 [!] Fix dport hangout when access to unavailable core. This situation was happened every time through the enumaration when number of created Cores are lower than number available slots
    [asic_top_tb.vhd, config_sim.vhd, riscv_soc.vhd, river_dummycpu.vhd, types_river.vhd]
2020-09-08 [*] Update DMI registers: - Fix write access into capability bits autoexec - Implement SBCS register to report memory access capability without actual DMA implementation (for now) - J-Link for now pr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
2020-09-09 [!] UPdate and fix JTAG TAP to support DMI scans without IR stage. Also fix ndmreset with halt request
    [asic_top_tb.vhd, dcom_jtag.vhd]
2020-09-09 [+] Update JTAG TAP via DMI registers: - Add states for DMA when SBA registers are used - Fix wrong state switching when broadband dport request
    [asic_top_tb.vhd]
2020-09-09 [+] Add description and configuration files for the openocd and how to use it with gdb to connect to target - SBA registers using addresses compatible with Xilinx interconnect and memory access becom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
    [kc705_river_1core.cfg, kc705_river_smp.cfg]
2020-09-15 [!] Fix systemc model with the correct size bus width [+] Add compressed instruction tracer into systemc model
    [asic_top_tb.vhd, cpu_riscv_func.cpp]
2020-09-16 [+] Update functional simulation - Add code coverage widget into GUI - Fix coverage detailed calculation
    [DbgMainWindow.cpp]
2021-09-09 [+] Start modification of SystemC execution module to support instructions with multiple access to memory. Idea is: - Implement separate tag for each register - Independent valid signal for the memor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
2021-09-13 [+] Enabling part of the refactored functionality in sysc executor module. Need to update tracer to support multiple memory transactions and register updates per one instruction to properly debug ato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
2021-09-15 [+] Updating and fixins CSR module. Preparing to move out all privelege controlling and exception controlling logic from excutor into CSR module. xret instreuction either as exception and simple rw a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
2021-09-16 [+] Update decode and tracer with AMO instructions. riscv-tests expectedly fails on AMO instruction amoadd.w with uart output TEST FAILED
2021-09-17 [*] minor modification in executor: adding muxltiplexer on the module input that switch in signals in Idle state on latched values in others states.
2021-09-19 [+] Implement all AMO instructions. Implement cache reserve/release logic [+] All riscv-tests passed including AMO tests [-] Next need to cleanup systemc, restore interrupts and exceptions logic and 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
2021-09-20 [+] Cleanup sysc executor module [+] Restore functionality of exceptions and interrupts requests throught the CSR bus [+] Add halted state in the executor to stop cpu before instruction execution has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
2021-09-21 [+] Add exception signal on CSR bus to generate Illegal instruction exception if there is no CSR access rights in current mode [+] Add software, timer and external irq requests into executor [+] Conn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
2021-09-21 [*] Updating CSR module adding Exceptions and Interrupts tables. [!] Need to verify env call from user mode (now it is called while in machine mode) [-] Privildge stack not implemented yet
2021-09-22 [+] Add env call handler from machine mode into boot source code [!] Fix bug missed signals in the sensitivity list
    [uart.h]
2021-09-23 [!] Fix address offset in rtl wrapper
    [rtl_wrapper.cpp]
2021-09-24 [!] debug and fix diveregence betwen functional and sysc simulation running bootrom_tests examples
    [rtl_wrapper.cpp]
2021-09-28 [!] Change functional model of interrupt controller and enable interrupt from its to CPU models (sys, funcitonal) [!] Fix cmake output directories of binary files [*] Update targets scripts according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
    [uart.cpp, uart.h]
2021-09-29 [*] temp disable uart irq to compare functional sim vs sysc running bootrom_tests
2021-09-29 [+] Add FPU registers into tracer output for the functional model
2021-09-30 [+] Add stack overflow/underflow exception signals [!] Fix fence request in a case if memaccess queue is full
2021-09-30 [!] fix bug in csr interconnect that leads to unstable sysc simulation [!] Fix exception address handling in CSR
    [rtl_wrapper.cpp, rtl_wrapper.h]
2021-10-01 [*] Optimizing tracer to be aligned with functional model (not finished)
2021-10-09 [*] Run bootrom_tests on functional and systemc models. Exceptions and interrupts checked
2021-10-11 [!] Fix error in functional model while run bootloader_tests. Disable interrupts while testing stack protection exceptions
    [cpu_riscv_func.cpp]
2021-10-13 [!] Finally fixed manually created makefiles for linux (not cmake) and run Simulator with GUI on Ubuntu 20.04. Deploy missed files Qt6XcbQpa.* and Qt6OpenGL.*. Unused variables warnings treated as er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
    [cpu_riscv_func.cpp, riscv-ext-m.cpp, uart.cpp]
2021-10-17 [+] Build and add to repo OpenOCD for windows with enabled bitbang interface [+] Add systemc dtm (jtag tap model) initial version [+] Add bitbang server into systemc configuration and connect OpenOCD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
    [bitbang.cfg]
2021-10-20 [+] Add jtag CDC module to better emulate future rtl implementation [+] Implement simultanious access to DMI registers from system bus and from JTAG TAP module. This simplify access for functional mo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
2021-10-21 [+] Add multicore support into dmi debug module and successfully run OpenOCD that detects 1 unavailable core[1] and core[0] is available. OpenOCD also properly reads all core capabilities and switche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
    [bitbang.cfg]
2021-10-27 [+] Update functionality of howto console commands interacts withe simulated system: interact with the CPU only through the memory mapped registers of the DMI device (all others interfaces will be re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
2021-10-28 [+] Implement basic run control for the functional model through the DM register: halt/resume, CSR transfer [-] Now I suppose DSU implementation is obsolete and should be removed soon to avoid overco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
    [cpu_riscv_func.cpp, cpu_riscv_func.h, icpufunctional.h, icpuriscv.h, idmi.h, idport.h]
2021-10-29 [+] Update functional dmi interface: - Fix stepping - Implement regisers read/write access through the dmi transfers. Work similar to systemc - Let implement funcitonal DTM model to provide interacti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
    [arm-isa.h, cpu_arm7_func.cpp, cpu_riscv_func.cpp, cpu_riscv_func.h, cpu_riscv_rtl.cpp, cpu_riscv_rtl.h, cpu_stub_fpga.cpp, cpu_stub_fpga.h]
2021-10-30 [+] Implement basic functionality to interact with the OpenOcd (go/halt/stepping) and functional model (DTM +DMI). [+] Need to add hartinfo and sbacs DMI registers to properly show CPU capabilities
    [bitbang.cfg]
2021-10-31 [+] Add hartinfo and sbcs registers into DMI implementaiton [!] Fix bug: wrong MISA value read from dcsr in functional model
    [bitbang.cfg]
2021-11-01 [+] Add tests commands into OpenOCD script bitbang.cfg to test runctrontrol and progbuf execution logic [+] OpenOcd tests run successfully with the functional model
    [bitbang.cfg]
2021-11-02 [+] Run OpenOcd with the systemc and make the following updates and fixes: + Add description and each DMI r/w transaction for each openocd command in bitbang.cfg file + Fix execution from progbuf. Ch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
    [bitbang.cfg]
2021-11-04 [+] Update openocd support with the reset/reset halt command for systemc This update includes: bitbang reset control for signals TRST and SRST Implement separate resets for system and DMI logic to pr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
    [bitbang.cfg]
2021-11-05 [!] Fix to memory access from OpenOcd (command mdw) using progbuf
    [bitbang.cfg]
2021-11-11 Fix debug memory access on systemc using _abstract_ type-2 commands: + incorrect aampostincrement fix + latching read value fix + some strange systemc feature that cannot properly concatates two bool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
    [bitbang.cfg]
2021-11-12 [+] Testing memory access using openocd abstract commands: + All valid read/write operations passed (byte, word, ...) - Not signaling about exceptions - unaligned debug requests or mpu error response
    [bitbang.cfg]
2021-11-14 [+] Verify memory access through progbuf and abstract. Tested with the image_load/image_verify to check buch write/read access
    [bitbang.cfg]
2021-11-15 [!] Minor fix in gui interface accordingly with the Qt6 rules: setBackground/setForground methods used instead of background()/forground() [!] Enable meie (external interrupts from PLIC) bit in regis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
2021-11-22 [+] Add WFI instruction support (wait-for-interrupt). [+] Update boot image to support soc with the multiple cores (more than 2). HW initialization is done on hart[0]. all others cores go to WFI stat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
2021-12-16 [*] first revision of PLIC funcitonal model implemented. next step is to connect to current simulation and prepare C-example to test it
2021-12-17 [+] Implement first functional tests for PLIC: generate self-test interrupt 70 from pnp module on write access to RO register HWID, then check pending bit 70 and check how claim read is working
2021-12-18 [+] Connect PLIC to functional CPU model: - Connect gnss_stub to PLIC and check that capable generate periodic interrupt - Update rom_tests and it works with interrupts generation from PLIC, claim/co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
2021-12-19 [+] Remove obsolete irqctrl interrupt controller from functional simulation and use PLIC instead for all interrupts [*] Enable vector interrupt mode (mtvec[1:0]=0x1) by default in bootrom_test exampl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
2021-12-19 [+] Change device memory mappin to be compatible with FU740: - Move boot ROM and reset address at 0x1_0000 - Move internal SRAM block into dedicated L2 controller range also used by FU740 BSL before 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
    [cpu_riscv_func.cpp, pnp.cpp, uart.cpp, uart.h]
2021-12-20 [+] Implement functional model of Core-local interruptor (CLINT) and connect it to CPU functional model. Now all local and global interrupts are supported in the same way as on FU740. Next commits wi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
2021-12-20 [*] Change GPIO model registers implementation and mapping accordingly with the FU740 board (unmatched). Update bootrom_tests accordingly
2021-12-20 [+] Add new self tests into bootrom_tests example for mtimer and sw interrupts. Run successfully with functional simulation [*] Small fixes in initialzation code to support better stack intialization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
    [cpu_riscv_func.cpp]
2021-12-21 [+] Update systemc model: - connect PLIC and CLINT to systemc CPU - Fix overflow flag int integer divider module accordignly with riscv-tests - Change default MPU configuration accordingly with the n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
    [cpu_riscv_rtl.cpp, cpu_riscv_rtl.h, rtl_wrapper.cpp, rtl_wrapper.h]
2021-12-22 [+] Add initial functional models of the following devices: - PRCI to properly generate PLL lock statuses when running Uboot - DDR phsyical filter - DDR controller [+] Connect all models to functiona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
2021-12-26 [+] Update boot example so that it implements functionality of ZBSL for FU740 board:search uefi partition with guid 5B193300-FC78-40CD-8002-E86C45580B47 boot example copies this segement into interna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
    [cpu_riscv_func.cpp, ddr.cpp, ddr.h, periphmap.h, plugin_init.cpp, pnp.cpp, qspi_ctrl.cpp, qspi_ctrl.h]
2021-12-27 [!] Fix some GUI issues with the GUI elements that execute read/write memory commands [*] Small optimization in systemc impl. branch predictor connecting pre-decoders signals to BTB [*] Create additi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
    [PnpWidget.cpp]
2021-12-28 [*] Update spi controller functional model to properly generate rx pending signal. Calculation of crc for data block was added but not checked yet
2021-12-28 [*] Systemc branch predictor tuning: do not overwrite executed jumps on pre-decoded (executed has higher priority) [!] Fix small build error in printf function
    [sdcard.cpp]
2021-12-29 [+] Change DDR functional model to avoid memory allocation of full size (2,8 or 64 GB) that leads to exception on virtual machine. Instead of that 2-linked list was created with block size equal to 1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
    [ddr.cpp, ddr.h, uart.cpp]
2021-12-30 [+] Enable GUI for systemc by default [!] Fix qspi2 reading for Boot example
    [qspi_ctrl.cpp, qspi_ctrl.h]
2022-06-12 [+] Copy U-boot FSL binary image loader1 into example/loader1.bin to speed simulation [*] need to properly implement spi controller
2022-07-12 [*] Insert rtlgen generated sysc module regibank instead of manually written
2022-07-12 [*] fetch systemc module inserted from rtlgen generator
2022-08-28 [*] merge the latest systemc generated modificaitons: interrupt bus instead of separate pins, some minor changes triggered by generator interface
2022-09-06 [+] Use rtlgen generate interface structures in file river_types.h. [+] Add a couple files to reproduce the CPUx4 workgroup in systemc in a same way as in RTL
2022-09-06 [+] Update PNP functional model to properly number of available harts, L2 cache and number of PLIC interrupts [*] sc_vector in systemc to connect interrupts in a same way as in RTL
2022-09-13 [+] Insert MMU into data path of the core. Memory requests to cache use physical address after MMU
2022-09-14 [!] Fix flag 'instruction executable' when run opcode from progbuf. Tested with with openocd. Change bitbang.cfg file configuring openocd accordingly with the memory map udpates
    [bitbang.cfg]
2022-09-17 [+] Update systemc csr implementation accordingly with the latest priv spec. Better implementation of the priv stack. Add delegation of interrupts and exception into S mode
2022-09-18 [!] Fix wfi instruction in S-mode test when global interrupts are disabled. Now test passes
2022-09-18 [+] Implements csr xcounteren for M an S modes [+] Implements register mcountinhibit [+] Provide shadow read-only access to mtimer value mapped in CLINT device
2022-09-19 [+] Update bootrom_tests example accordingly with the new pending bits behaviour. Add common methods to disable/enable specific hart interrupt
2022-10-03 [!] Fix workgroup interfaces: irqs and apb dmi
    [cpu_riscv_rtl.cpp, cpu_riscv_rtl.h]
2022-10-12 [!] Fix bootrom_tests L2.coherence enabling Software interrupts bits. Startup.S file does not enable them anymore
2022-10-13 [!] Fix copy-past error in connection i_tms signal to jtagtap module (workgroup) [+] Add custom device tree blob into boot example and run bbl an pk with successfully passed ftl_scan stage
    [bitbang_gdb.cfg]
2022-10-13 [*] Tuning Device Tree Blob to start bbl and pk before linux kernel [!] Fix AMO write data handling
2022-10-14 [+] bbl passes successfully device tree scan stage and start debian kernel. [-] Need to implement mmu sv36 type. linux kernel does not automatically select sv48 instead of sv36 [!] Fix TVM flag acces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
2022-10-18 [*] Regenerate device tree blob dtb using riscv virt target as reference, limit DDR size to 512 MB to simplify rtl simulation [*] Change behaviour of fence instruction, no need to flush whole caches 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
2022-10-24 [!] Fix switching to paged mode (rump-up of linux) [*] Add mrx and sum flags into mmu
2022-11-02 [+] Add initial version of the FPGA project using SystemVerilog source code (KC705 is the target). All necessary files have been added [*] Use the latest generated riverlib version (same as current s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
2022-11-03 [!] Fix axi2apb bridge logical errors while testing [!] Fix xsize signal on uncached access in dcache
    [types_amba.h]
2022-11-04 [+] Implement unfied device config descriptor for the next step to implement device tree map instead of defining it in the slave descriptor [+] Add initial version of apb_uart submodule in systemc
2022-11-09 [!] Fix sv apb_uart module and integrated into top level
    [types_amba.h]
2022-11-10 [+] Add APB bus[1] definitions and connect axi2apb bridge with the APB uart on riscv_soc level.
2022-11-21 [+] Finally switching to 48-bits system bus and 64-bits CPU core. Now bus width does not affect CPU implementation and can be freely configured even in systemc that has strict buswidth rules checking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
2022-11-25 [+] Change memory mapping scheme. Now device mapinfo structure and forms its own device description sctructure that could be read from PNP module [+] AXI to APB bridge now is using universal axi_slv 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
2022-11-28 [+] Update device descriptor structure [*] Update AXI slave module to properly handle burst transactions and APB devices with the wait states
2022-11-28 [*] Update all generated system verilog files. Manualy writen updates is in progress. Bus interface was changed so they are not compatible and will generate errors
    [axi2apb.sv, axi2apb_pkg.sv, types_bus0_pkg.sv, types_bus1_pkg.sv]
2022-12-02 [!] Fix PNP functional model accordingly with the new format of the device descriptor structure in sc and sv [!] Fix issue with the flushing MMU tlb entries
    [PnpWidget.cpp, PnpWidget.h, periphmap.h, pnp.cpp, pnp.h]
2022-12-05 [!] Fix simulated ext. fpga frequency to 200 MHz to see correct UART output at 115200 baud
    [config_target_pkg.sv, riscv_soc.sv]
2022-12-06 [!] Fixes for the kc705 tcl script to build fpga image [*] split rom 64 on 2x32 rom implementation and use 2 different hex files to initialize Boot ROM
    [config_target_pkg.sv, riscv_soc.sv]
2022-12-06 [!] Fix memory block exceeds 1 mbit error in vivado elaborating stage
    [riscv_soc.sv]
2022-12-06 [+] Apply the latest systemc modifications into system verilog: [!] Fix mmu flush request bit that could lead to cpu hanging [*] Move out into global config file caches configuration size [*] Reduce 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
    [config_target_pkg.sv, riscv_soc.sv]
2022-12-09 [+] Add delay module WireDelay in testbench file for the DDR IO-signals [+] APB bridge is now fully functional and support multiple apb ports
2022-12-12 [*] Connect DDR clock to separate igds buffer and change paramter to NO_BUFFER to avoid synthesis error
    [config_target_pkg.sv]
2022-12-13 [+] Add generated for KC705 axi clock converter to provide 200 MHz access from the 40 MHz system bus. Update example to monitor and print DDR init done flag.
2022-12-14 [!] Fix the last one found latch in dbg_port module [*] Commit all updates into sv and sysc so that they were synchronized [-] Need to significantly reduce critical path in PLIC that computes pending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
    [kc705_top.xdc]
2022-12-15 [!] Fix pin assignment for kc705
    [kc705_top.xdc]
2022-12-15 [!] Fix constrain syntax error
    [kc705_top.xdc]
2022-12-17 [!] Fix simualtion with the NO_BUF cjlock connection fcm[+] Add asic simulation without xilinx IP blocks
    [config_target_pkg.sv]
2022-12-21 [*] kc705 simulation is restored (build and executed), but the calibration is not started, no activity on dq lines
2022-12-23 [+] Commit the latest modifications applied in system verilog into systemc [*] Initial version of SPI controller for SD-card has been started
2022-12-27 [+] Initial integration of the SPI module to interact with SD-card in SPI mode into sv RTL. Map this module into QSPI2 allocated memory region of FU740. Update example bootrom_tests
2022-12-29 [+] Update SPI controller for SD card. Computation of the valid CRC7 was added. Update bootrom_tests example to send CMD0 and read R1 response. [*] Let check what will SD card output on fpga
2022-12-29 [!] Fix signal name in KC705 constrain file
    [kc705_top.xdc]
2022-12-29 [!] Fix PnP output that stucks CPU wth exception. DMI APB slave provided master device descriptor
2022-12-30 [*] update bootrom_tests example adding initial timeout of 1000 SPI clocks before sending CMD0 to SD-card
2023-01-01 [*] Add 1 sec output into bootrom_tests example to see GPIO (DIP/LED) values and SD-card inputs
2023-01-03 [!] Use APB GPIO generated system verilog instead of manually writen with the fixed registers mapping
    [apb_gpio.sv, riscv_soc.sv]
2023-01-04 [*] Update and fix bootrom_tests LED output when in idle cycle
2023-01-11 [*] Generate SPI SCK when CS is asserted. Update a bit test example to check CMD0, CMD8 response from SD-card
2023-01-12 [*] Update SPI test example to check full SD-card init sequence plus Single Data block read
2023-01-13 [*] update test to interact with SD card High Capacity
2023-01-16 [+] Update bootrom_tests example to test multiple block read from SD-card [+] Add Device tree file into bootrom_tests [+] Prepare everythin to jump into DDR and start BSL + Linux after coping data fr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
2023-01-16 [+] Add Verification IP of the simple SD-card in SPI mode to check SPI controller. Update test example
2023-01-17 [*] Use UART in bootrom_tests without interrupt handler (Tx buffer disable). Update example to copy 10MB from SD card to DDR [+] Add target configration parameter to speed-up UART output simulation
2023-01-17 [*] Add all the latest modification from verilog into systemc: SPI SD-card related logic, etc [*] Improve parameters alignment at string when new module is instantiated
2023-01-18 [!] Fix spi controller. The last byte in data block (511) was not wrote into rxfifo. [+] Add DDR inferred model with intialization from file to speed-up simulation of BSL and Linux kernel
2023-01-26 [*] First try to fix fmul selftest errors that occurs on the real fpga and in the post-synthesis simulation. Adding seprate zeroenc to compute first non-zero bit on the bus
    [imul53.sv]
2023-01-30 [!] Fix build errors after checkout clean repo aftger the previous commit. Changing console commands interface and upate all commnad classes
    [DbgMainWindow.cpp, cpu_riscv_rtl.h, cpu_stub_fpga.h, fpu_func.cpp, fpu_func.h, icache_func.cpp, icommand.h, idisplay.h]
2023-02-15 [+] Add instruction SFENCE.VMA into func sim that allows to execute full botrom_tests example. MMU test is failed because no mmu implemented there [+] Add generic method to interact with mmu into fun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
    [cpu_riscv_func.cpp, cpu_riscv_func.h, icpufunctional.h, riscv-isa.h, riscv-rv64i-priv.cpp]
2023-02-17 [!] Fix and restore fucntionality of the command 'reg' in the functional simulation. GUI registers view is now working again
    [cpu_riscv_func.cpp]
2023-03-21 [+] Fix stepping command c 1, for an example
    [DbgMainWindow.cpp]
2023-03-23 [!] Fix slowdown computation in GUI status bar. Now reg command returns dict type even if one register was requested
    [DbgMainWindow.cpp, riscv-isa.h]
2023-03-24 [+] Connect OpenOCD to functional simulation (need modifications in the JSON-config, see bitbang.cfg for more details). All basic commands of the OpenOCD implemented in bitbang.cfg have been passed s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
    [bitbang.cfg, bitbang_gdb.cfg]
2023-03-28 [*] Update funcitonal DTM DMI interfaces to support abstraact memory command with the functional model and to properly handle DMI errors
    [cpu_riscv_func.cpp, cpu_riscv_func.h, idmi.h, idport.h, ijtag.h]
2023-03-28 [!] Fix systemc DTM sticky error handling and resets. Now it is should correspond to debug spec 1.0 [*] Change a bit FIFO template to simpler handle threshold interrupts
2023-03-29 [+] Implement memory access through the simulated jtag bitbang interface. [*] Full openocd test (bitbang.cfg) has been passed with the funcitonal simulation. Memory access with progbuf and with abstr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
    [bitbang.cfg, bitbang_gdb.cfg]
2023-04-04 [+] Run openocd as system() process called from a separate thread. There is problem to gracefully close TCP connection valid for windows and linux
    [memsim.cpp]
2023-04-06 [*] Trying to connect to openocd via gdb protocol. Unclear how to gracefully close connection and exit from thread
2023-04-20 [!] Fix TcpClient bug: skipped transmitted data in multithreaded application [+] add gdb-detach event into openocd config file to shutdown openocd and gracefully close simulation
    [bitbang_gdb.cfg]
2023-05-05 [!] Fix reset and halt via JTAG implementation. [!] Fix DMI cmderr sticky bit [*] Use FIFO generic implementation in APB UART [*] Move out PLL module from PRCI into Top Level [*] Need to update bootr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
    [riscv_soc.sv, riscv_soc_pkg.sv]
2023-05-16 [!] Fix SPI sd-card controller to work with sd v2.0 card properly at 10 MHz. bootrom_test was also updated
2023-05-16 [!] Restore parameter that allows to speed-up RTL simulation modifing scale rate in APB UART module (for test purpose only)
2023-05-16 [!] Fix spi sd-card initialization sequence and CRC reading bug that modifies data block data
2023-05-16 [*] minor modification uart scale rate in kc705 simulation testbench
2023-05-24 [*] Add delay between CMD0 and CMD8 in bootrom_tests examplse for spi interface
2023-06-02 [+] Add sysc generated axi_rom module with all tech submodules. Initialization from hex-file is implemented in a same way as in system verilog emulating the method readmemh with asic_sim relative pat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
    [sv_func.cpp, sv_func.h]
2023-06-09 [!] Fix pnp table size calculation (sysc version) after rtl simulation
    [riscv_soc_pkg.sv]
2023-06-12 [!] Fix wrong port direction declaration of the i_*_cfg ports on riscv_soc level connected to pnp module. This was lead to a wrong device enumaration in bootrom_tests
    [riscv_soc.sv]
2023-06-12 [+] Add ddr cdc module into systemc model [+] Copy fixes from rtl into sysc related to pnp device description structure
2023-06-12 [!] Fix vivado unsupports string generic parameter error
    [riscv_soc.sv]
2023-06-15 [+] Run full asic_top simulation in systemc. Previously only workgroup was simulated [!] Fix critical bug with array index in ax2apb_bus module (systemc)
    [cpu_riscv_rtl.cpp, cpu_riscv_rtl.h, rtl_wrapper.cpp, rtl_wrapper.h]
2023-06-15 [!] Fix critical bug: array index out of range in axi2apb_bus1 module. Bug leads to stack corruption was not reported by ncsim
    [axi2apb_bus1.sv]
2023-07-18 [!] Tuning and fixing full soc systemc simulation: - Fix SV_readmemh implementation - Connect uart_vip to simulation and fix clock generation issues - sysc simulation succesessfully started.
    [cpu_riscv_rtl.cpp, cpu_riscv_rtl.h, rtl_wrapper.cpp, sv_func.cpp]
2023-07-19 [*] Add UART string output for systemc simulation from uart_vip
2023-07-24 [+] Connect SD-controller with DAT[3:0] bi-directional pins into system verilog (asic and kc705) instead of previously implemented SPI apb_spi.sv
2023-07-25 [!] Fix after making bootrom_file as a generic parameter: default bootrom file not defined leads to unworking kc705 build.
    [config_target_pkg.sv]
2023-07-26 [+] Allocate new 32GB AXI slot for the SD-card controller in systemc [+] Add new sdctrl sub-modules
2023-07-26 [+] Allocate 32GB AXI slot for SD-controller in verilog. Alignment with the systemc
2023-07-28 [*] Move target_cofig parameters as generic parameter of riscv_soc level, so that low level module didnot have dependencies of the higher level config parameters
    [config_target_pkg.sv, riscv_soc.sv, riscv_soc_pkg.sv]
2023-07-31 [+] Update and fixes into UART related logic: [!] Fix abb_uart output tx signal to HIGH when Idle/dummy byte is transmitted [+] Update and fix VIP UART with the fully generated version usable in syst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
    [cpu_riscv_rtl.cpp, sv_func.cpp, sv_func.h]
2023-08-01 [!] Fix VIPs (uart, clk) in systemc before commiting into verilog
2023-08-01 [+] Accumulated update from systemc: [+] New uart_vip with the fixed empty line output in UART console and implemented transmitter [!] Fix vip_clk generator with the initialization and timescale [!] 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
2023-08-22 [!] Fix vip_sdcard reset and make it async to avoid X on io_cmd line
    [cpu_riscv_rtl.cpp]
2023-08-25 [!] SD-card related fixes: - Implement 1 ms delay at startup before enabling clock on sd-controller - default dat[3:0] io-pins set as output and HIGH - Set io_cmd to LOW for 70 clock (< 74) to switch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
    [sdctrl.cpp]
2023-09-10 [!] Add pull-up constrants for SD-card io-pins (kc705) [!] Fix syntax error in sd-card vip that broke rtl simulation
    [kc705_top.xdc]
2023-09-12 [*] Change default direction input for SD controller DAT[3:0]. Actually only DAT[3] should be used as Card Detect input at power-up (will be fixed later) all others are output. Update bootrom_tests e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
    [cpu_riscv_rtl.cpp, cpu_riscv_rtl.h, sdctrl.cpp]
2023-09-18 [*] Start implementing SPI mode in sdctrl and sd-card vip because cannot start SD card in SD-mode on kc705. SPI mode previously worked fine (only systemc for now)
2023-09-19 [+] Update SD vip and controller in SPI mode
2023-09-27 [*] Merge all modifications related to sd-card in SPI mode from systemc into system verilog
2023-09-27 [!] Fix crc15 instance names in sdctrl module
    [sdctrl.cpp]
2023-09-30 [+] Add initial version of sdctrl cache submodule and include it into top. Cache line 512 bytes (4096 bits) looks too big for implementation so split data block on 8 cache lines for now. Need to fini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
    [sdctrl.cpp]
2023-10-04 [+] Add sd-controller block reading and caching. Need to check with fpga that cache lines (64B=512b) are not too long and all contrains are met. SystemC version first
    [sdctrl.cpp]
2023-10-05 [!] Fix CRC16 computation and rx now it is corretly computes 7fa1 value on all FFs [-] Previous version didnot work on kc705 with the real sd hc card. Need to properly handle errors to clarify the re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
    [sdctrl.cpp]
2023-10-06 [+] Update systemc sdctrl model: - Split SPI/SD modes state machines into different modules - Improve watchdog and error handling functions as a separate modules - Increase pause interval (CSn) betwe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
    [sdctrl.cpp]
2023-10-06 [+] Update system verilog files withh all sysc modifications: - Refactoring sdctrl to split SD/SPI modes state machines in a different modules - Improve error handling and watchdog module - CSn in SP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
2023-11-24 [*] rtlgen generator was updated and fixed comma-separator at the end of comment lines. No functional changes
    [types_amba.h, types_pnp_pkg.sv]
2023-11-29 [*] rtlgen upgrade: fixed unnecesary empty lines in code (no functional changes)
    [apb_gpio.sv, axi2apb_bus1.sv, axictrl_bus0.sv, clint.h, imul53.sv, plic.h]
2023-11-29 [!] Fix clint: structure members are used as a triggers without sc_signal interface and were not added into sensitivity list [*] rtl gen detects another similar case in plic ctx structure but it is m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
    [clint.h]
2023-12-10 [!] Fix verilog build errors. Run asic_sim successfully
    [riscv_soc.sv]
2024-10-28 [*] Update SystemC model after rtlgen upgrade to support multiple reset and clock signals in one module. This functionality allows to generate async. clock-domain-crossing modules without limitation 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
    [plic.h]
2025-05-30 [+] Add AXI DMA interface module [+] Add refined and tested async fifo implementation
2025-07-15 [+] Regenerate misclib: [+] Add I2C apb slave [+] Update prci to support different clock domains, multiple resets
    [apb_gpio.sv]
2025-07-15 [*] Regenerate riverlib with the latest version of rtlgen: - Use unified afifo in jtagtap instead of cdcjtag - Create separate module Cache L1 DMA engine - Remove empty package files
2025-07-15 [+] Update AXI inteconnect to support multiple masters to a different slaves at the same time. Implemented like a real interconnect [!] Slave interface axi_slv treats AXI Light requests as an AXI Ful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
2025-07-15 [*] Update systemc model to match current system verilog code
2025-07-16 [!] remove watchdog in l1_dma_snoop that was added to debug axictrl bug, now it is a problem for the case when L2 is enabled
    [bus_slv.h, cpu_riscv_rtl.h, rtl_wrapper.h]
2025-07-16 [!] Fix CI build error
    [cpu_riscv_rtl.cpp, cpu_riscv_rtl.h]
2025-07-16 [!] Fix CI workflow - known issue using the old configure && make flow when build SystemC 3.0.x. Use CMake to build SystemC 3.0.1
